MASantangelo/SV08-Enhanced-Gantry-Projects/tools/README.md

# tools

Scripts that generate the viewable files in this repo. You only need them if you're maintaining the repo; they're not needed to build the printer.

**Requirement:** [FreeCAD 1.0](https://www.freecad.org/) installed at the default location. The scripts run on FreeCAD's own Python, so nothing else needs installing.

## Refresh a variant

From the repo root:

```powershell
powershell -ExecutionPolicy Bypass -File tools\update-previews.ps1 -Variant "Printed Version" -Title "SV08-P6 Printed Gantry (6 mm)"
```

The titles in use are `SV08-P6 Printed Gantry (6 mm)`, `SV08-CF6 Carbon Fiber Gantry (6 mm)` and `SV08-M5 Aluminum Gantry (5 mm)`.

This:

1. Converts every STEP file into `For Viewing\<name>.stl`, in each of these folders that exists: the variant folder itself, `Base Assemblies`, `Base Components\Print Ready` and `Base Components\For Mockups Only`.
2. Rebuilds `<variant>\BOM.md` from the variant's `*BOM*.xlsx` file.

Add `-SkipStl` or `-SkipBom` to run only one of the two steps. Close the spreadsheet in Excel first, because Excel blocks other programs from reading it.

The output is deterministic: if a STEP file hasn't changed, its STL comes out byte-for-byte identical, so git only shows files that actually changed.

### Sub-variants (`CF Version\9mm Belt Mod`)

A sub-variant is a folder inside a variant that reuses most of its parent, like the CF build for 9 mm belts. It holds its own main STEP, `*BOM*.xlsx`, `BOM.md`, `Renders` and `For Viewing`. Its own sub-assemblies and parts sit beside the parent's in a folder with the same name: `CF Version\Base Assemblies\9mm Belt Mod` and `CF Version\Base Components\9mm Belt Mod`.

- Pass it as the variant: `-Variant "CF Version\9mm Belt Mod" -Title "SV08-CF6 Carbon Fiber Gantry for 9mm Belts"`. Renders, the BOM check and `dupes` pick up its sub-assemblies from the parent's `Base Assemblies\9mm Belt Mod`.
- `BOM.md` links its own parts first, then the parent's `Base Components` (the plates it shares), then `Shared Components`.
- Its BOM rules are the parent's rules plus any under `variants` → `"CF Version/9mm Belt Mod"`.
- The STLs for its parts in the parent's folders come from refreshing the parent (`-Variant "CF Version"`), which converts every subfolder.

## Renders

`update-previews.ps1` also renders PNGs into `<variant>\Renders\`. You can run that step on its own:

```powershell
powershell -ExecutionPolicy Bypass -File tools\render.ps1 -Variant "Printed Version"
```

- **What it renders:** the main assembly from 4 angles (front left, front right, rear left, overview), plus each `Base Assemblies` STEP from its outside corner. The CAD colours are kept, shaded without edge lines.
- **How:** it uses FreeCAD's full interface, so a FreeCAD window opens for about a minute and then closes itself. Images are rendered at 2× size, cropped to the parts and scaled down.
- **Changing angles:** edit `$MainViews` and `$AssemblyViews` in `render.ps1`. An angle is an azimuth (0 = front, 45 = front right, 315 = front left) and an elevation in degrees above the horizon. Avoid 90 (straight down), because the light washes out faces seen head-on.
- **No noise in git:** a render is only rewritten when its pixels change, so an unchanged model leaves the files byte-identical. FreeCAD's embedded metadata, which includes a timestamp and the local file path, is stripped out.
- **Not covered:** motion. Animations like the tensioner GIF still come from Fusion.
- **Landing image:** after rendering, `landing_composite.py` combines each version's `Full Gantry - Front Right` render into `Renders/Landing - Front Right.png`. With three versions it's a "Y" split from the centre (seams to the top-left corner, the top-right corner and the bottom middle): printed on the left, metal at the top, CF on the right, each with a label. Edit `REGIONS` in the script to change the order or labels.

## Build-guide step images

`build-steps.ps1` renders the step-by-step pictures for the guides in `Docs/`:

```powershell
powershell -ExecutionPolicy Bypass -File toolsuild-steps.ps1                    # every guide
powershell -ExecutionPolicy Bypass -File toolsuild-steps.ps1 -Only "XY Joint"
```

- **Step files:** each guide has a JSON file in `Docs/steps/` that names groups of parts (matched by name, optionally by height) and lists the steps. The format is described at the top of `build_steps.py`.
- **What each picture shows:** the parts added in that step in orange, parts fitted in earlier steps of the same sequence in grey, and nothing else.
- **Output:** `Docs/Images/<guide>/`, cropped and stripped of metadata like the other renders. Re-run it after any change to the sub-assembly STEP the guide uses.
- **Warnings:** a group that matches no parts (for example after a part is renamed in Fusion) is reported, and the run fails so the guide doesn't silently lose a part.

## Check flat plates (CF, metal)

```powershell
powershell -ExecutionPolicy Bypass -File tools\plate-check.ps1 -Variant "Metal Version" -Reference "CF Version"
```

This runs two checks on each plate in `<variant>\Base Components`: `plate_check.py` (holes, fits and walls between features), then `wall_check.py` (a direct wall sweep, below). Add `-SkipWallSweep` to run only the first.

`plate_check.py` checks:

- **Thickness:** must match the number in the file name (`Metal5mm` → 5.00 mm).
- **Position:** the plate must sit on 0,0,0.
- **Holes by role:** M2 and M3 tap drills (1.6 and 2.5), close-fit clearance holes (3.2, 4.3, 5.3) and Ø5.00 locating fits. A hole that's close to one of these sizes but not on it is flagged as a near-miss. Inside corner radii of the outline aren't counted as holes.
- **Metal only:** every plate except spacers needs at least one tapped hole.
- **Minimum wall:** the thinnest strip of material between two features, or between a feature and the edge, at every depth. Anything under 1.5 mm is flagged (change it with `-MinWall`). Each one is labelled as a through-wall (full plate depth) or a lip (a rim around a pocket).
- **With `-Reference`:** each hole is matched by position to the same plate in the reference version. It flags precision fits that changed (Ø5.00 shoulder holes, Ø13.00 bearing bores, Ø22.00 motor boss) and holes that exist on only one of the two plates. Intentional changes like PEM → tap are only counted. Add `-ListAllChanges` to list them.

`wall_check.py` measures material directly on the solid, so it also catches walls `plate_check.py` can't see: material between pockets that merge into one opening, such as knife-edge tips and thin tongues where a bearing step overlaps a motor-boss recess.

- **In-plane walls:** each plate is sectioned at every distinct depth (and every 0.1 mm through countersinks and chamfers). Anywhere two boundary edges come closer than the minimum across solid material, it reports a `THIN WALL` at the thinnest point, with the depth of that section.
- **Floors:** every pocket floor or ceiling is checked against the opposite face (`THIN FLOOR`).
- It uses the same `-MinWall` and `-Only` options and the same `plate_accepted.json` (kinds `wall` and `floor`).

**Printed parts:** the sweep can also check that walls and heights suit your slicer settings. Use `-SweepOnly`, because the hole sizes `plate_check.py` expects don't apply to print-tolerance holes, and point `-Folder` at the print-ready parts:

```powershell
powershell -ExecutionPolicy Bypass -File tools\plate-check.ps1 -Variant "Printed Version" -Folder "Base Components\Print Ready" -SweepOnly -MinWall 2.0 -PreferredWall 3.0 -InsertHole 4.7 -LayerHeight 0.2
powershell -ExecutionPolicy Bypass -File tools\plate-check.ps1 -Variant "Shared Components" -Folder "Print Ready" -SweepOnly -MinWall 2.0 -PreferredWall 3.0 -InsertHole 4.7 -LayerHeight 0.2
```

These are the project's printed rules: 2.0 mm minimum and 3.0 mm preferred. 3 mm of printed plastic is enough for most loads in this motion system, and the shared outline can reach it in most places.

- **`-PreferredWall`**: a second tier. Walls from `-MinWall` up to this are `BELOW-PREFERRED WALL`s. They're listed for review like thin walls, so you either fix them or accept them.
- **`-InsertHole`** (heat-set insert hole diameters, comma-separated, e.g. `4.7`): any wall touching one of these holes and thinner than the preferred wall (or `-MinWall`, without one) is an `INSERT WALL`. Heat-setting pushes melted plastic outward, so a thin wall beside an insert bulges into the next hole or cracks.
- **`-LayerHeight`** (e.g. `0.2`, `0.15`): the thickness and every flat level (pocket floors, steps) must sit on a layer boundary, otherwise it's an `OFF-LAYER HEIGHT`. In this mode the file's own Z is the build direction, since print-ready files are already oriented for printing.
- **`-WallMultiple`** (your line width, e.g. `0.4`), optional: every wall up to `-WallMax` (default 4 mm) must be an exact multiple of it, otherwise it's an `OFF-GRID WALL` with the two nearest multiples. The project doesn't use this rule, because the shared outline can't keep every wall on the grid.
- Accepted entries use the kinds `preferred`, `insert`, `grid` and `layer`.

Use `-Only "Front Left Top"` to check a single plate. Plates with findings get a marked-up drawing in `%TEMP%\sv08-plate-check`.

**Accepting a finding on purpose:** add an entry to `plate_accepted.json`, giving the plate, the kind (`wall`, `floor`, `near-miss` or `fit`), x/y and the measured value, plus a note. A matching finding then prints as `~ accepted` and doesn't count against the plate. If the geometry changes, it's reported as a normal finding again: that means a move of more than 1 mm, or a value change of more than 0.05 mm.

## Check the BOM against the STEP file

Run this before committing a new assembly STEP. It reads every part and how many times it's used from the STEP file, then compares those counts with the spreadsheet.

```powershell
& "C:\Program Files\FreeCAD 1.0\bin\python.exe" tools\step_bom.py check "Printed Version"
```

- **check**: reports quantity differences, parts in the CAD that aren't in the BOM, and BOM rows that are no longer in the CAD. It also fails on duplicate components (see `dupes`). It ends with `CHECK PASSED` (exit code 0) or `CHECK FAILED` (exit code 1), and never writes anything.
- **dupes**: checks the main STEP and every `Base Assemblies` STEP for duplicate components. When a component is copied and pasted instead of inserted as another instance, Fusion names the copy `Name (1)`, `Name (2)` and so on. The BOM still counts them correctly, but each copy is a separate component to keep in sync, so the check names each one and its parent so you can replace it with an instance of the original. Copies inside the stock Sovol `SV08 … Z Carriage` models are listed but don't fail the check.
- **update**: writes the CAD quantities into the spreadsheet's Qty column, then rebuilds `BOM.md`. Links, notes and formatting are left alone. New CAD parts are only reported unless you add `--add-new`, which appends them under a "New from CAD (sort these)" section. Close the spreadsheet in Excel first.
- **tree**: prints the assembly structure, showing each sub-assembly once. It's useful when writing rules.

Needs openpyxl in FreeCAD's Python. This is a one-time install: `& "C:\Program Files\FreeCAD 1.0\bin\python.exe" -m pip install --user openpyxl`

### Rules (`bom_rules.json`)

CAD names don't always match BOM names, so `bom_rules.json` translates them. Fusion's copy and mirror suffixes (`(2)`, `(Mirror)`, `_1`, `.f3d`, ` x2`) are removed automatically first.

| Rule | What it does | Example |
|---|---|---|
| `exclude_assemblies` | Skips a sub-assembly and everything inside it | The stock SV08 Z carriages |
| `unit_assemblies` | Counts a sub-assembly as one BOM item. Add `"descend": true` to also count the parts inside it. | A D2F-L switch is 1 item, not 5 pieces |
| `category_by_assembly` | Puts parts under a sub-assembly into a specific BOM category | Xol hardware goes into "Xol Toolhead Hardware". Use `{"as": "<category>", "only": "<regex>"}` to move only the matching parts: the rail screws and M3 T-nuts under `Linear Rails` go into "Linear Rail Mounting Hardware", while the rails stay in "Linear Rails & Sliders" |
| `rename` | Maps an exact CAD name to a BOM name | `T-Nut M4` becomes `M4 T-Nut` |
| `rename_patterns` | Regex renames, used when no exact rename matches | `M3x8mm SHCS` becomes `M3 x 8mm SHCS` |
| `ignore_parts` | CAD parts that never belong in the BOM | |
| `bom_only` | BOM rows that are expected to be missing from the CAD | |

`common` rules apply to every variant. Rules under `variants` → `"<folder name>"` add to them for one variant.

## Mechanical analysis

The numbers and figures in [`Mechanical Analysis.md`](../Mechanical%20Analysis.md) come from the scripts in [`analysis/`](analysis). To rerun them after a design change:

```powershell
powershell -ExecutionPolicy Bypass -File tools\analysis\analysis.ps1
```

It takes about 15 minutes and runs six steps. Add `-From <step>` to restart from a later one, reusing the earlier steps' output.

| Step | What it does |
|---|---|
| `geometry.py` | Reads the three versions' assembly STEPs and the 9mm belt mod's. It exports the left-side plates, the front and back corner sandwiches and the left XY joint, and measures every belt wrap and its load at 8 lb. |
| `plates.py` | FEA of every left-side plate under its idler loads (printed ABS, CF with the weave at 0/90 and at 45°, aluminium), then how much the plates lengthen the belt path compared with the belt's own stretch |
| `corners.py` | FEA of the corner sandwiches, giving how stiffly each version holds the Y extrusion ends. Each is run bonded (a tight through-bolt) and clamped only at its bolts (a loose T-nut joint). |
| `xyjoint.py` | Predicted XY joint bench test: one joint held at its MGN9 carriage with a 200 mm X-beam stub, 49 N sideways and vertically, next to the bare-stub deflection. Each joint is exported with three stand-in shaft post sizes, and the first that meshes is used. |
| `frame.py` | Beam models of the whole gantry: masses and acceleration (motor rotors included), sag, vertical bounce, XY and yaw modes, belt tension swing and plucked-frequency table, thermal bow at each chamber temperature, joint slip, motor heat, creep and buckling |
| `figures.py` | Writes the PNGs in `Renders/Analysis/` |

- **Inputs:** material data and assumptions are in `materials.py`: the CF weave's direction-dependent constants, belt stiffness range, toolhead mass, motor, and chamber temperatures.
- **Tools:** meshing uses gmsh and solving uses CalculiX. Both ship with FreeCAD 1.0, so nothing else needs installing.
- **Work files** go to `%TEMP%\sv08fea`, deliberately a short path, because CalculiX fails once a path passes Windows' 260-character limit.
- **Meshing failures:** gmsh retries with other element sizes and a looser tolerance for touching faces, and gives up on an attempt after 90 s. If a model still can't be meshed, it's skipped. For a corner, `frame.py` then uses the other corner's value, and says so in its output.
- **Reading the output:** the printed results are what the tables in the analysis doc are built from. The doc isn't regenerated automatically, so update its numbers by hand when they change.

## Files

| File | What it does |
|---|---|
| `update-previews.ps1` | Runs both steps for one variant |
| `step2stl.py` | STEP to STL using size-based meshing: small hardware coarse, plates and large parts fine. This keeps full assemblies small enough for GitHub's viewer. |
| `make_bom_md.py` | Spreadsheet to `BOM.md`: sectioned tables, Amazon/AliExpress/Mouser/McMaster buy links, and printed parts and plates linked to their STL previews |
| `render.ps1` / `render.py` | Renders PNGs of the assemblies using FreeCAD's full interface |
| `build-steps.ps1` / `build_steps.py` | Renders the build-guide step images from `Docs/steps/*.json` |
| `landing_composite.py` | Builds the split landing-page image from each version's render |
| `plate-check.ps1` / `plate_check.py` | Sanity-checks flat plates: thickness, holes, thin walls, changes from a reference version |
| `wall_check.py` | Direct minimum-wall and floor sweep of flat plates, including merged pockets (run by `plate-check.ps1`) |
| `plate_accepted.json` | Findings accepted on purpose, shared by both plate checks |
| `step_bom.py` | Checks or updates the BOM spreadsheet against the assembly STEP |
| `bom_rules.json` | Rules that translate CAD names into BOM lines |
| `read_xlsx.py` | Minimal `.xlsx` reader using only the Python standard library, used by `make_bom_md.py` |
| `analysis/analysis.ps1` | Runs the mechanical analysis (see above) |
| `analysis/fealib.py` | Small gmsh + CalculiX wrapper used by the FEA steps: meshing, picking bolt and bore nodes by position, solving, reading results |
| `analysis/materials.py` | Material data and analysis assumptions |

## Spreadsheet layout `make_bom_md.py` expects

- Header row: `Category | Qty Needed | Description | Purchase Link | Notes`
- Section rows: only the first column filled in, for example `Fasteners - Screws`
- Rows in a section called `Printed Parts`, or one ending in `Plates` (`CF Plates`, `Metal Plates`), are linked to the STL preview with the matching name in the variant's `Base Components` or in `Shared Components`. A leading `4x` and a trailing `- For Printing` are ignored when matching.
