MASantangelo/SV08-Enhanced-Gantry-Projects/CF Version/README.md

# SV08-CF6 Carbon Fiber Gantry (6 mm)

The carbon fiber variant: every gantry plate is cut from 6 mm carbon fiber, and standard M3 hex nuts in hex pockets replace the heat-set inserts used in the printed version.

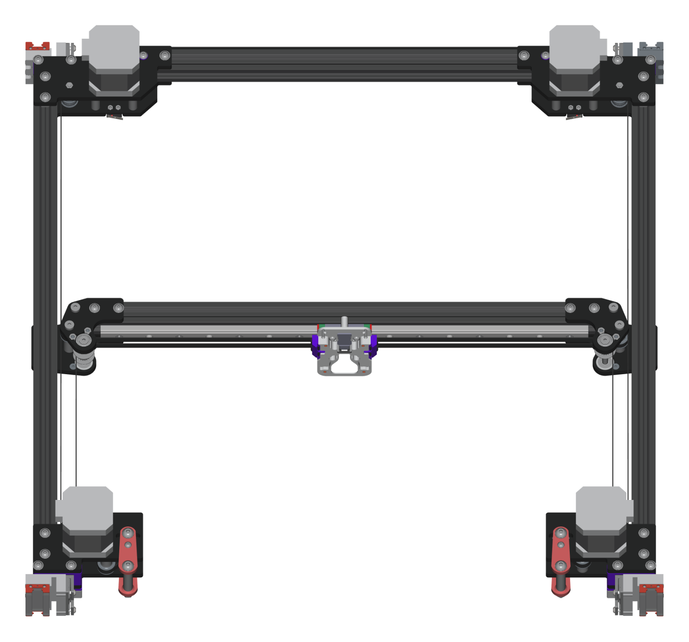
[picture p5: CF Version/Renders/Full Gantry - Overview.png]
Full gantry overview, rendered from the current STEP file


## Folder structure

```text
CF Version/
├── BOM.md                                   Bill of materials with purchase links
├── SV08_CF6_BOM_from_STEP.xlsx              BOM spreadsheet (source for BOM.md)
├── SV08-CF6 Dual Shear Live Idlers Front Tensioners.step   Full assembly
├── For Viewing/                             STL preview of the full assembly (~34 MB)
├── 9mm Belt Mod/                            The 9 mm belt version: its own full assembly, BOM and renders
│
├── Base Assemblies/                         Each corner and joint as its own assembly
│   ├── Back Left / Back Right Motor Assembly
│   ├── Front Left / Front Right Motor Assembly
│   ├── XY Joint Left / Right
│   ├── 9mm Belt Mod/                        The same six for 9 mm belts
│   └── For Viewing/                         STL previews
│
├── Base Components/                         ← Cut these from 6 mm carbon fiber
│   ├── *.step                               12 gantry plates + the 5 mm XY idler spacers
│   ├── CF Printed Parts.3mf                 The shared printed parts a CF build needs, on one plate (OrcaSlicer)
│   ├── 9mm Belt Mod/                        The three 5 mm riser spacers for the 9 mm build (CF or printed)
│   └── For Viewing/                         STL previews
│
├── Photos/                                  Photos of real builds
└── Renders/                                 Auto-generated from the STEP files (always current)
```

The spacers and tensioner lever arms are the same in every version, so they live in [`Shared Components`](../Shared%20Components). Print them, or cut the lever arms from CF or metal.

## Quick links

| I want to... | Go to |
|---|---|
| Buy the hardware | [BOM.md](BOM.md) |
| Install it | [Installation guide](../Docs/Installation.md) |
| Cut the plates | [Base Components](Base%20Components) |
| Print the shared parts | [Shared Components/Print Ready](../Shared%20Components/Print%20Ready), or all at once from the [CF Printed Parts 3MF](Base%20Components/CF%20Printed%20Parts.3mf) |
| Look at the assembly in 3D | [Full assembly STL](For%20Viewing/SV08-CF6%20Dual%20Shear%20Live%20Idlers%20Front%20Tensioners.stl) · [Sub-assemblies](Base%20Assemblies/For%20Viewing) |
| Build it for 9 mm belts | [9mm Belt Mod](9mm%20Belt%20Mod): the same CF plates with a 30 mm corner gap, 9 mm idlers and pulleys and longer hardware, with its own [BOM](9mm%20Belt%20Mod/BOM.md). It works with the aluminum and printed plates too. |

## What's different from the printed version

- **Plates:** cut from 6 mm carbon fiber instead of printed. The layout matches the printed plates, with machining tolerances built in (see the hole guide below) and a few outlines grown slightly to keep at least 1.5 mm of material around the bearing-retainer screws.
- **Threaded mounting points:** standard M3 hex nuts (ISO 4032), seated in hex pockets, replace the M3 heat-set inserts. The pockets are 5.9 mm across the flats, so a nut drops in and can't turn. A dab of glue (CA or epoxy) keeps each nut in its pocket until its screw is in. Every screw that goes into a nut gets its full thread, apart from the lever-arm screws (about 2.1 of 2.4 mm), which is plenty for a pivot.
- **Back motors on top:** the CAD has the back motors on top of the corners, like the fronts. The printed and metal CAD hangs them below. Both ways work on every version: swap the back plates left for right to change it (see [Motor up or motor down](../Docs/Installation.md#motor-up-or-motor-down)).
- **Everything else is the same:** hardware, bearings, pulleys, belts, extrusions and the shared printed parts.

## Cutting the plates

| Hole | Size | Notes |
|---|---|---|
| **M3 / M4 / M5 clearance** | Ø3.2 / Ø4.3 / Ø5.3 | Close fit. The tensioner slot is 5.3 mm wide. |
| **M3 nut pockets** | 5.9 mm across the flats, R1 corners, 2.5 mm deep (2.4 mm at the bearing retainers on the front bottom plates), with a 1 mm lead-in chamfer | For standard M3 hex nuts; the M3 hole through the rest of the plate is Ø3.2. The 2.4 mm pockets leave a thicker floor at the front bottom retainers. |
| **Shoulder-bolt holes** | Ø5.00 | Locating fit for the D5 shoulder bolts; head counterbores Ø8.3. |
| **Bearing seats** | Ø13.00 bore, Ø16.20 step | Locating fit for the F695 flanged bearings. Step depth: 2.0 mm on the XY plates, 2.6 mm on the front bottoms, 1.4 mm on the front tops, 1.0 mm on the back bottoms. The XY and front depths set the bearing spans for the Chicago bolt idler shafts. |
| **Bearing-retainer counterbores** | Ø6.2, as deep as the bearing step beside them (1.4–2.6 mm) | For the M3 flat heads that clamp the bearing flanges |
| **Motor boss** | Ø22.00 | Front top plates; merged with the bearing bore, so there's no thin web between them |

- **The pockets need a mill.** Bearing steps, counterbores and the hex nut pockets are partial-depth features, so a waterjet or laser alone can't cut them.
- **Left plates are flipped copies of the right ones.** Each left plate is its right-hand plate turned over, so its pockets are on the opposite face of the file. Machine each plate pocket-side up as it's drawn.
- **XY live idler spacers:** cut from the same 6 mm sheet and machined down to 5 mm, so you don't need a separate 5 mm sheet.
- A few walls and floors are under 1.5 mm on purpose: mostly the floors between the nut pockets and the bearing-retainer counterbores (1.0 mm on the front bottoms), plus a few rims beside the nut pockets and shoulder-bolt holes. They're listed, with the reasons, in [`tools/plate_accepted.json`](../tools/plate_accepted.json).

## Build photos

The first CF XY joint (left), cut from 6 mm carbon fiber and fitted with its Chicago bolt live idler, bearings and pulleys.

| Front | Side |
|---|---|
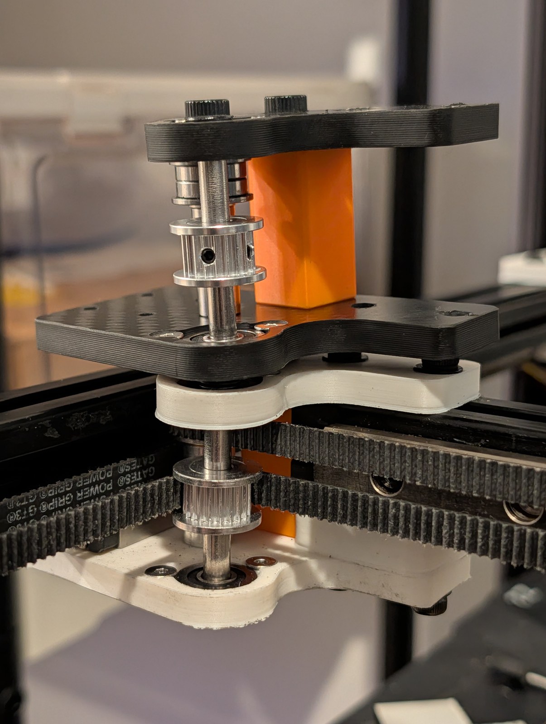
[picture p6: CF Version/Photos/XY Joint Left CF - Front.jpg]
The left CF XY joint on the printer: the toothed pulley and the bearing stack on the shoulder bolt between the carbon fiber plates, with the orange printed spacer and both belts below
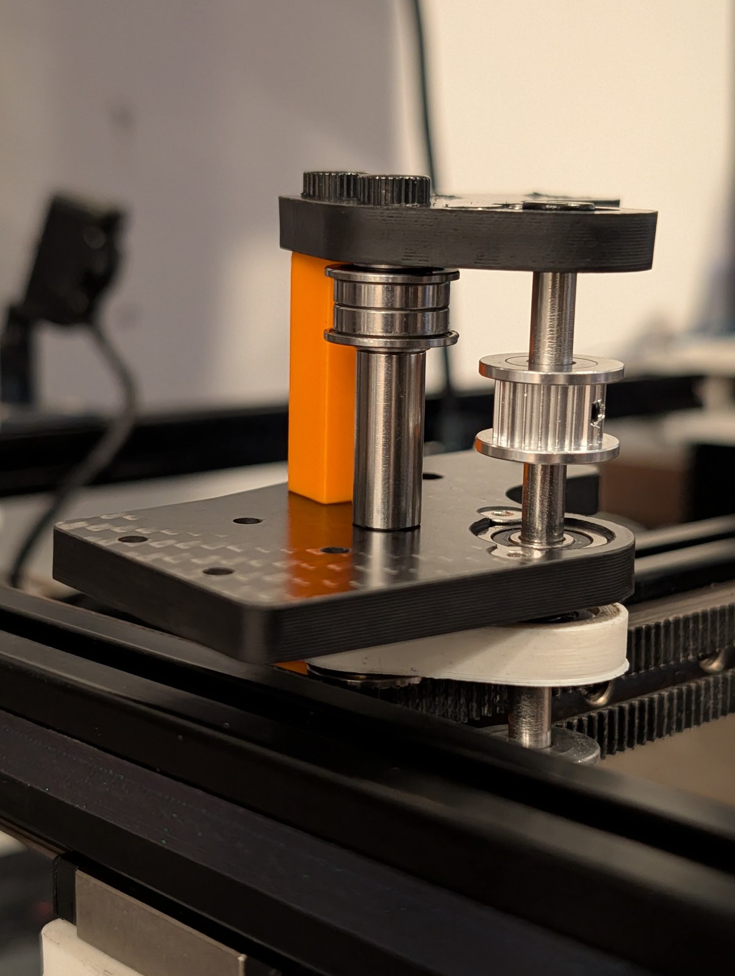
[picture p7: CF Version/Photos/XY Joint Left CF - Side.jpg]
The left CF XY joint from the side: the bearing stack and the toothed pulley on the Chicago bolt between the two carbon fiber plates
|  |  |

**The X gantry on the stock SV08 extrusion**, with both CF XY joints through-bolted to it with nuts and bolts.

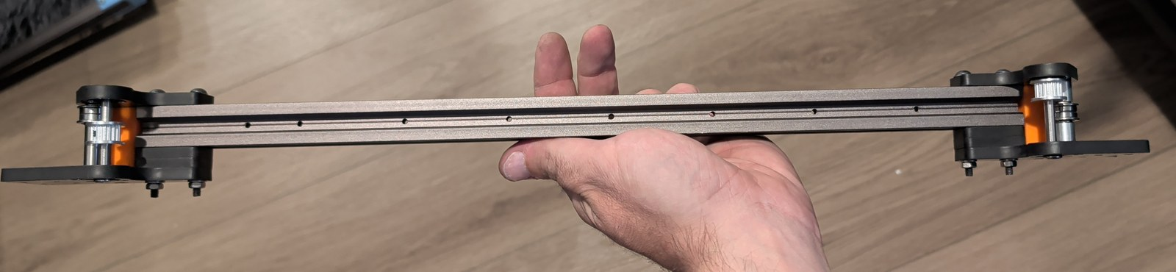
[picture p8: CF Version/Photos/X Gantry CF - In Hand.jpg]
Both CF XY joints mounted on the ends of the stock SV08 toolhead extrusion, held in one hand: through-bolts and nuts under each joint, pulleys and orange printed spacers at each end


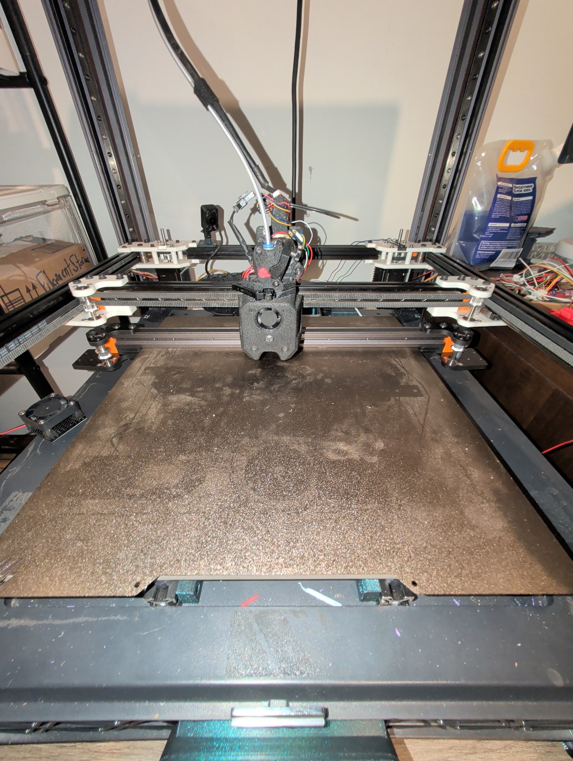
[picture p9: CF Version/Photos/X Gantry CF - On Printer.jpg]
The CF X gantry installed on an SV08 with printed corners: the toolhead on the stock extrusion between the two CF XY joints, belts fitted


**Front right motor corner**

| Belt side | Tensioner |
|---|---|
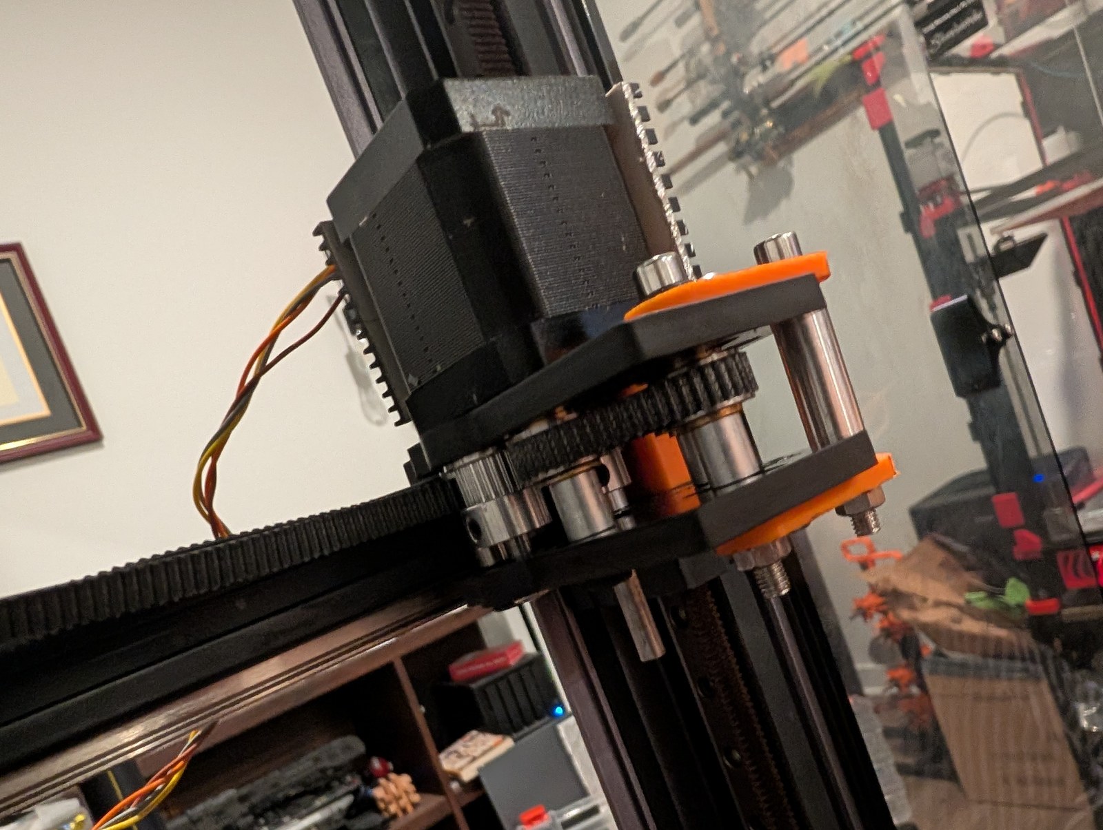
[picture p10: CF Version/Photos/Front Right Motor Corner CF - Belt Side.jpg]
The CF front right motor corner on the printer: the motor on the top plate, the belts on the bearing stacks between the two carbon fiber plates, and the orange lever arms on the shoulder bolts
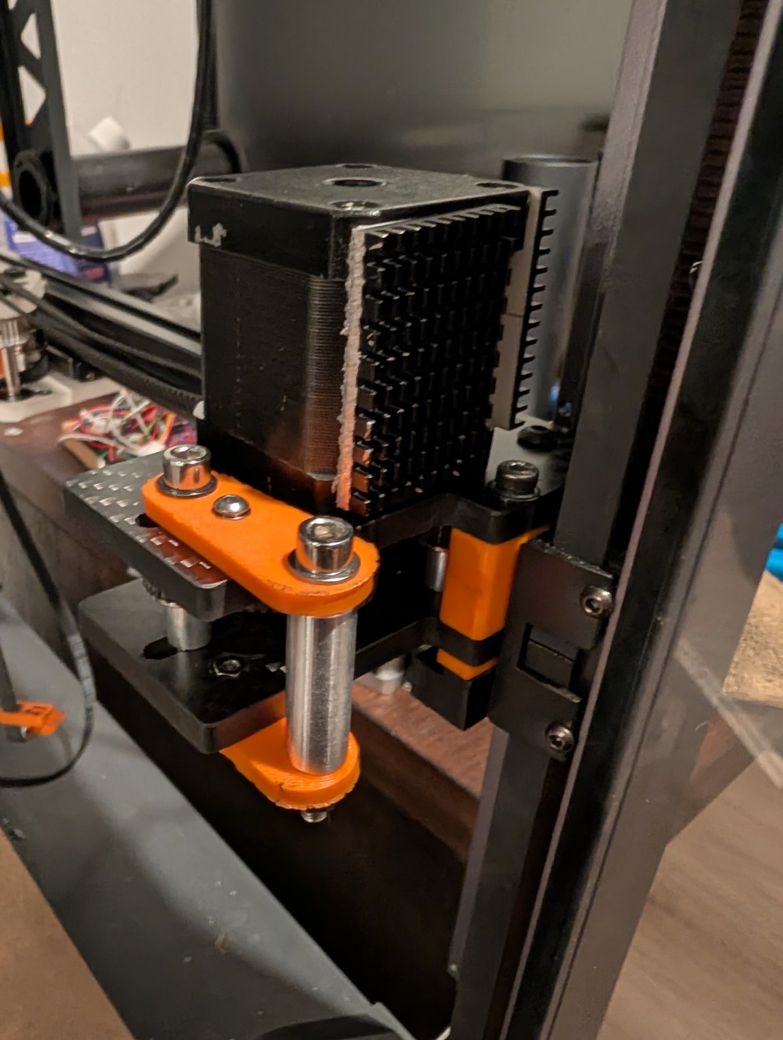
[picture p11: CF Version/Photos/Front Right Motor Corner CF - Tensioner.jpg]
The CF front right motor corner from the tensioner side: the orange lever arms clamped top and bottom on the tensioner shaft, with the motor above
|  |  |

## Renders

Generated automatically from the current STEP files whenever the repo is refreshed (see [tools](../tools)), so they always show the latest design.

| | |
|---|---|
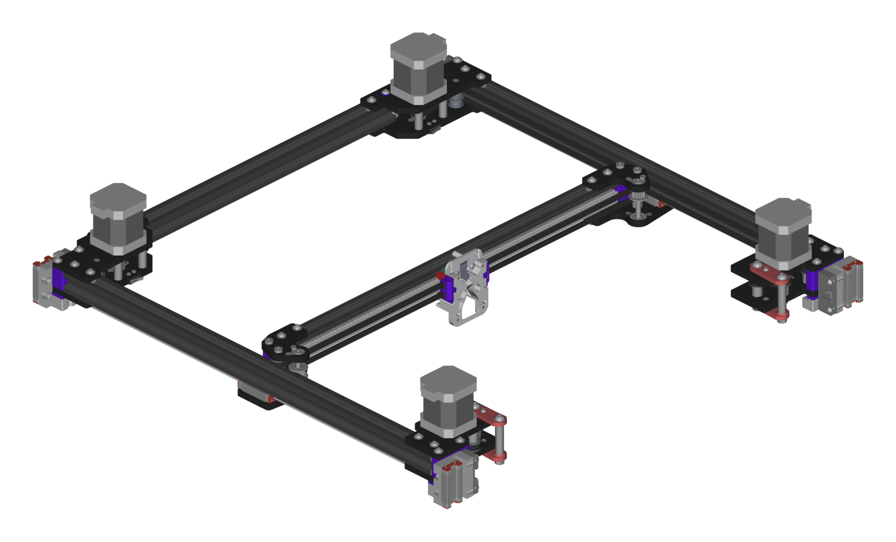
[picture p12: CF Version/Renders/Full Gantry - Front Left.png]
Full gantry, front left
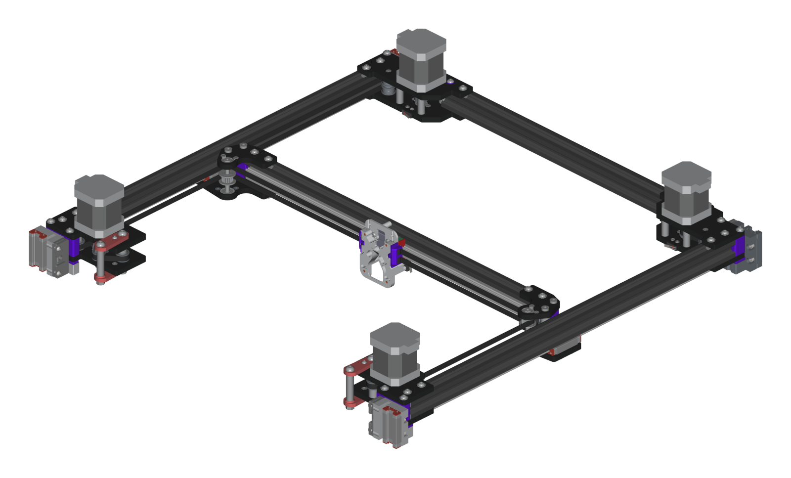
[picture p13: CF Version/Renders/Full Gantry - Front Right.png]
Full gantry, front right
|  |  |
| Front left | Front right |
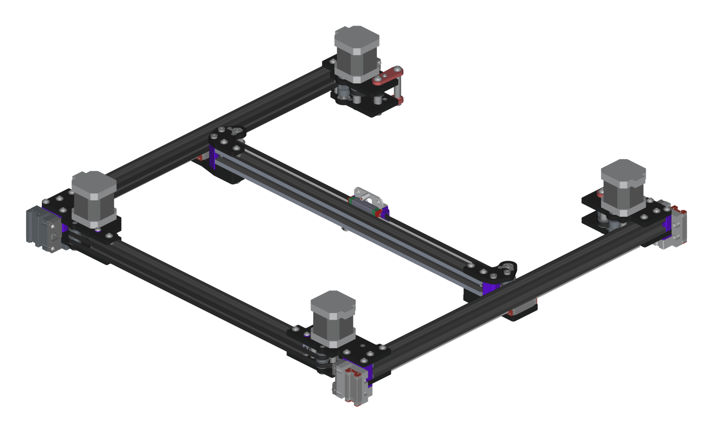
[picture p14: CF Version/Renders/Full Gantry - Rear Left.png]
Full gantry, rear left
|  | Full gantry, overview |
| Rear left | Overview |

### Sub-assemblies

| | | |
|---|---|---|
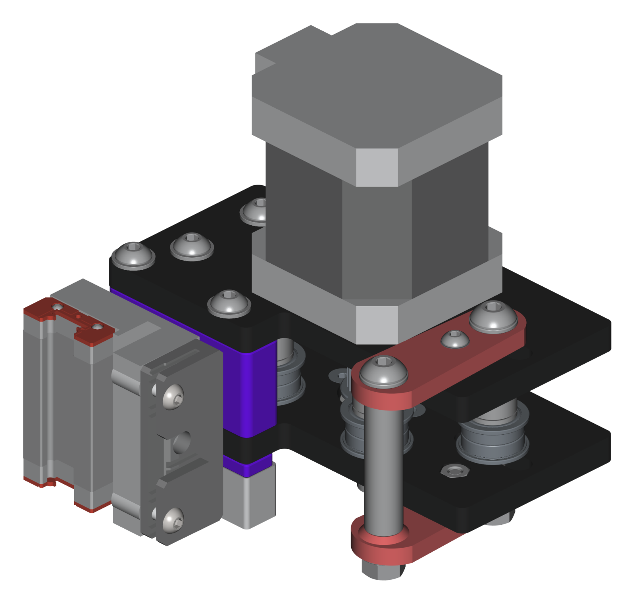
[picture p15: CF Version/Renders/Front Left Motor Assembly CF6mm - Iso.png]
Front left motor assembly
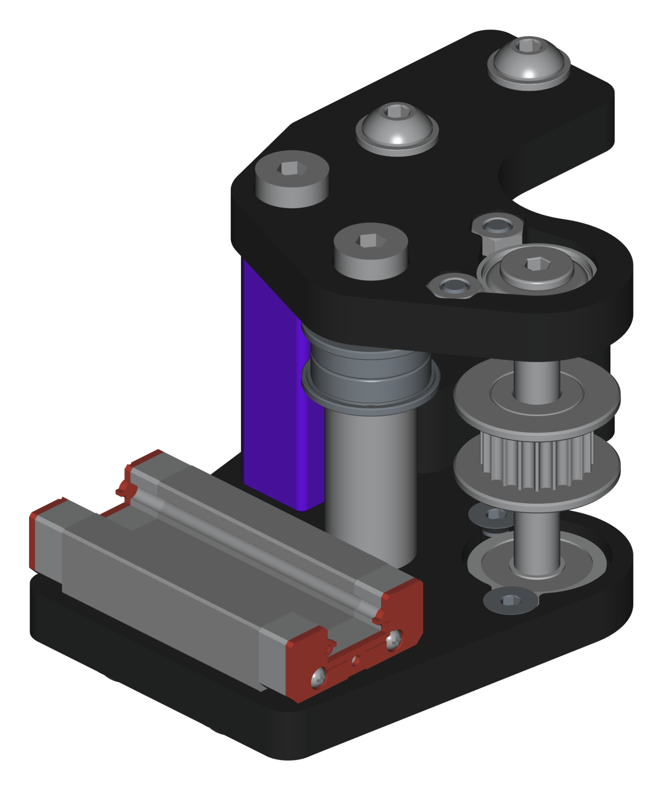
[picture p16: CF Version/Renders/XY Joint Left CF6mm - Iso.png]
XY joint left
|  | Front right motor assembly |  |
| Front left motor | Front right motor | XY joint left |
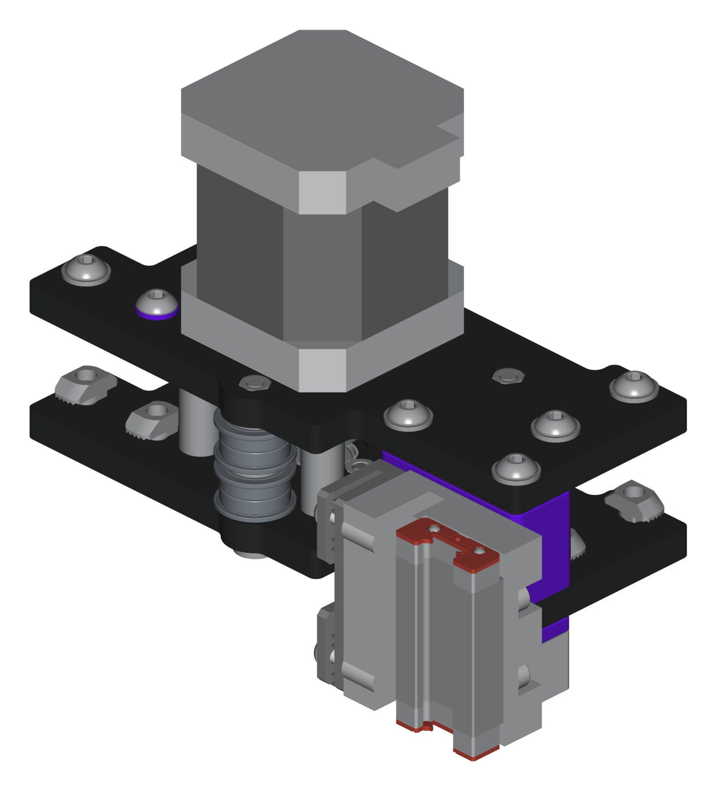
[picture p17: CF Version/Renders/Back Left Motor Assembly CF6mm - Iso.png]
Back left motor assembly
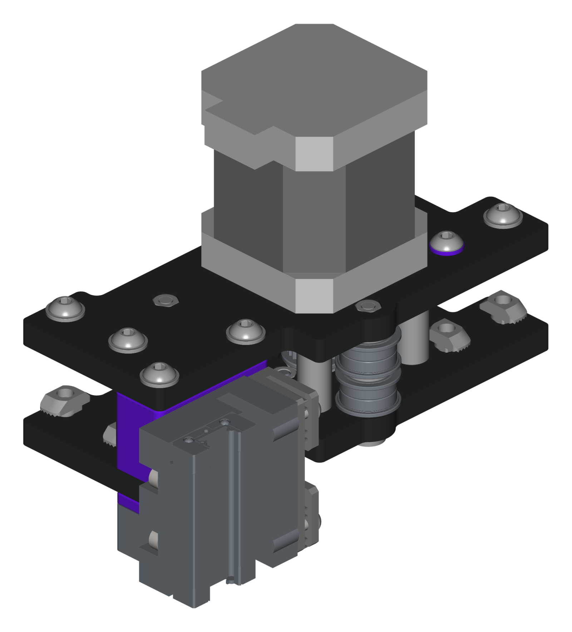
[picture p18: CF Version/Renders/Back Right Motor Assembly CF6mm - Iso.png]
Back right motor assembly
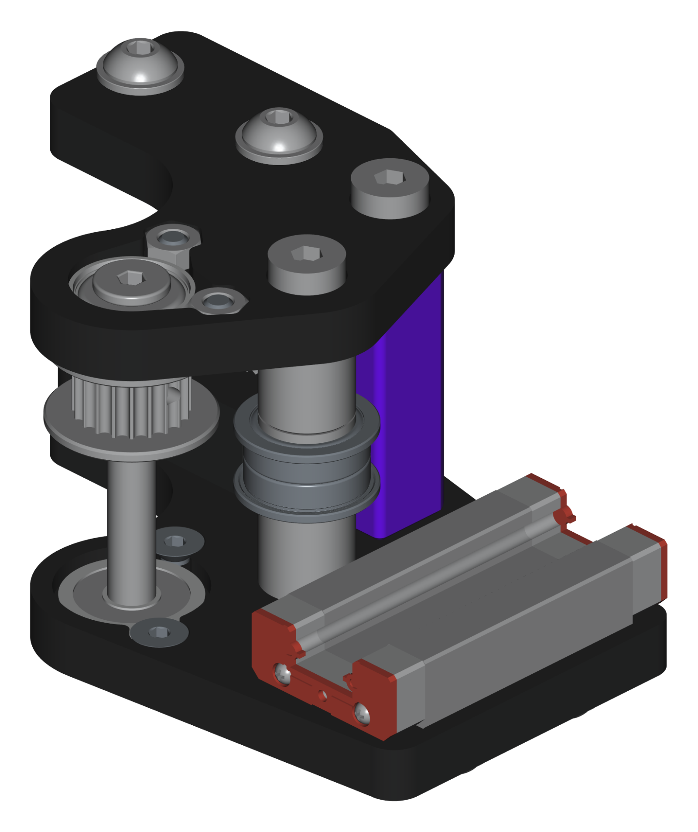
[picture p19: CF Version/Renders/XY Joint Right CF6mm - Iso.png]
XY joint right
|  |  |  |
| Back left motor | Back right motor | XY joint right |
