MASantangelo/SV08-Enhanced-Gantry-Projects/Metal Version/Renders/Full Gantry - Overview.png

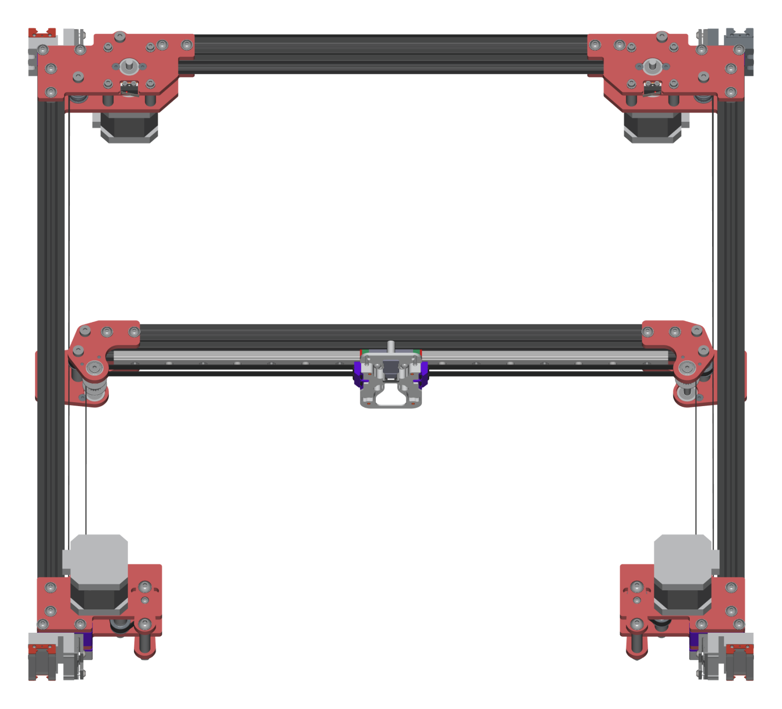
Metal Version/Renders/Full Gantry - Overview.png
