MASantangelo/SV08-Enhanced-Gantry-Projects/Shared Components/README.md

# Shared Components

Parts that are the same in every version of the gantry (printed, carbon fiber and metal). Each version's BOM links here for them.

## Print Ready

Oriented for printing, with holes enlarged by about 0.3 mm for printing tolerance. The quantity per machine is in the file name.

| Qty | Part |
|---:|---|
| 4 | [Tensioner Lever Arm Revised](Print%20Ready/For%20Viewing/4x%20Tensioner%20Lever%20Arm%20Revised%20-%20For%20Printing.stl) |
| 4 | [Z Carriage Spacer](Print%20Ready/For%20Viewing/4x%20Z%20Carriage%20Spacer%20-%20For%20Printing.stl) |
| 2 | [Back Spacer Plate 20mm](Print%20Ready/For%20Viewing/2x%20Back%20Spacer%20Plate%2020mm%20-%20For%20Printing.stl) |
| 2 | [Front Spacer Plate 20mm](Print%20Ready/For%20Viewing/2x%20Front%20Spacer%20Plate%2020mm%20-%20For%20Printing.stl) |
| 2 | [Printed Back Motor Spacer](Print%20Ready/For%20Viewing/2x%20Printed%20Back%20Motor%20Spacer%20-For%20Printing.stl) |
| 2 | [XY Live Idler Spacer](Print%20Ready/For%20Viewing/2x%20XY%20Live%20Idler%20Spacer%20-%20For%20Printing.stl) |

Part names link to 3D previews. The STEP files sit next to them in [`Print Ready`](Print%20Ready).

## For Cutting

Nominal size, for parts that can also be cut from carbon fiber instead of printed.

| Qty | Part |
|---:|---|
| 4 | [Tensioner Lever Arm Revised](For%20Cutting/For%20Viewing/Tensioner%20Lever%20Arm%20Revised.stl) |

The tensioner lever arm works either way: print it from `Print Ready`, or cut it from carbon fiber using this file. **Metal builds use their own flat 5 mm lever arm** from [`Metal Version/Base Components`](../Metal%20Version/Base%20Components). Machined aluminium lever arms for all three versions will be available to buy at some point.

## Stock Parts

Models of bought parts and the stock SV08 extrusions, for checking fits in CAD. You don't make these; the BOMs say where to buy them.

| Part | Notes |
|---|---|
| [M5x30 Chicago Bolt Base](Stock%20Parts/For%20Viewing/M5x30%20Chicago%20Bolt%20Base.stl) | 304 stainless Chicago screw, 5 mm × 30 mm barrel, M4 thread. Front live idler shaft. |
| [M5x40 Chicago Bolt Base](Stock%20Parts/For%20Viewing/M5x40%20Chicago%20Bolt%20Base.stl) | Same, 40 mm barrel. XY joint live idler shaft. |
| [M4x4 Chicago Bolt Cap Screw](Stock%20Parts/For%20Viewing/M4x4%20Chicago%20Bolt%20Cap%20Screw.stl) | The screw included with the Chicago bolts. Its 2 mm head doesn't clear the front motors, so the build uses the ultra-thin head instead. |
| [M4x8 Ultra Thin Flat Head](Stock%20Parts/For%20Viewing/M4x8%20Ultra%20Thin%20Flat%20Head.stl) | 1.2 mm head. Closes the screw end of each Chicago bolt. |
| [SV08 Stock Toolhead Extrusion](Stock%20Parts/For%20Viewing/SV08%20Stock%20Toolhead%20Extrusion.stl) | 426 mm. M4 holes 5 mm and 25 mm from each end. |
| [SV08 Stock Gantry X Extrusion](Stock%20Parts/For%20Viewing/SV08%20Stock%20Gantry%20X%20Extrusion.stl) | 345 mm. M4 holes 5 mm and 23 mm from each end. |
| [SV08 Stock Gantry Y Extrusion](Stock%20Parts/For%20Viewing/SV08%20Stock%20Gantry%20Y%20Extrusion.stl) | 469 mm. M4 holes 5 mm and 25 mm from each end. |

Part names link to 3D previews. The STEP files sit next to them in [`Stock Parts`](Stock%20Parts).
