MASantangelo/SV08-Enhanced-Gantry-Projects/CF Version/BOM.md

# SV08-CF6 Carbon Fiber Gantry (6 mm): Bill of Materials

Generated from [`SV08_CF6_BOM_from_STEP.xlsx`](SV08_CF6_BOM_from_STEP.xlsx). If the two disagree, the spreadsheet is correct.

Links are plain product pages with no affiliate or tracking codes. Where a listing has multiple options, the **Notes** column says which one to pick.

## Contents

- [Fasteners - Screws](#fasteners---screws)
- [Fasteners - Shoulder Bolts](#fasteners---shoulder-bolts)
- [Fasteners - T-Nuts](#fasteners---t-nuts)
- [Live Idler Shafts](#live-idler-shafts)
- [Fasteners - Nuts](#fasteners---nuts)
- [Washers & Shims](#washers--shims)
- [Bearings](#bearings)
- [Pulleys](#pulleys)
- [Belts](#belts)
- [Spacers (Aluminum)](#spacers-aluminum)
- [Xol Toolhead Hardware](#xol-toolhead-hardware)
- [Electronics / Endstops](#electronics--endstops)
- [Linear Rails & Sliders](#linear-rails--sliders)
- [Linear Rail Mounting Hardware](#linear-rail-mounting-hardware)
- [Motors](#motors)
- [Extrusions](#extrusions)
- [CF Plates](#cf-plates)
- [Printed Parts](#printed-parts)

## Fasteners - Screws

*The M3 screws and M3 T-nuts that mount the linear rails are listed separately under [Linear Rail Mounting Hardware](#linear-rail-mounting-hardware).*

| Qty | Part | Buy | Notes |
|---:|---|---|---|
| 28 | M4 x 10mm BHCS | [Amazon](https://amazon.com/dp/B0CTH3Z2F5) |  |
| 24 | M3 x 6mm FHCS | [Amazon](https://amazon.com/dp/B01E5EOIWW) |  |
| 12 | M3 x 10mm BHCS | [Amazon](https://amazon.com/dp/B0GJK7Z9DH) |  |
| 8 | M3 x 35mm SHCS | [Amazon](https://amazon.com/dp/B0GHY9ZCLC) |  |
| 8 | M4 x 45mm BHCS | [Amazon](https://amazon.com/dp/B0GH6G1R1G) |  |
| 4 | M4x8 Ultra Thin Flat Head | [Amazon](https://amazon.com/dp/B0H61X7SWB) | Screw end of each Chicago bolt live idler shaft (1 per front motor assembly and 1 per XY joint). 1.2mm head, thin enough to clear the front motors. Use threadlocker: blue (medium, removable) recommended; red (high strength) only for a permanent build, since removing it takes heat that can damage the bearings. |
| 4 | M2 x 2mm Set Screw | [Amazon](https://amazon.com/dp/B0DDJBSF6B) | Should come with the GT2 20-Tooth Pulley - Live Idler Version (2 per pulley, 4 total). |
| 4 | M2 x 8mm SHCS | [Amazon](https://amazon.com/dp/B0D4JMPT86) |  |
| 4 | M4 x 20mm BHCS | [Amazon](https://amazon.com/dp/B0DYSQZHC9) |  |
| 4 | M5 x 45mm BHCS | [Amazon](https://amazon.com/dp/B0GJX8PR8J) |  |

## Fasteners - Shoulder Bolts

| Qty | Part | Buy | Notes |
|---:|---|---|---|
| 8 | D5 M3 x 30mm Shoulder Bolt | [AliExpress](https://www.aliexpress.us/item/3256810189139611.html) | Make sure you select Size D5-M3, Length 30mm |
| 4 | D5 M3 x 25mm Shoulder Bolt | [AliExpress](https://www.aliexpress.us/item/3256810189139611.html) | Make sure you select Size D5-M3, Length 25mm |
| 4 | D5 M3 x 35mm Shoulder Bolt | [AliExpress](https://www.aliexpress.us/item/3256810189139611.html) | Make sure you select Size D5-M3, Length 35mm |

## Fasteners - T-Nuts

*The M3 screws and M3 T-nuts that mount the linear rails are listed separately under [Linear Rail Mounting Hardware](#linear-rail-mounting-hardware).*

| Qty | Part | Buy | Notes |
|---:|---|---|---|
| 32 | M4 T-Nut | [Amazon](https://amazon.com/dp/B0C9DJBG1H) |  |

## Live Idler Shafts

| Qty | Part | Buy | Notes |
|---:|---|---|---|
| 2 | M5x40 Chicago Bolt Base | [Amazon](https://amazon.com/dp/B0FLJNY14R) | Live idler shaft in the XY joints (1 per joint). 304 stainless Chicago screw: the 5mm x 40mm barrel runs the full width of both bearings, its head on one bearing and an M4x8 Ultra Thin Flat Head on the other, so the bearings are clamped and the idler can't float. Pack of 20. The M4x4 screws in the pack aren't used: their 2mm heads don't clear the front motors, so the ultra-thin heads are used everywhere. ALTERNATIVES (not as good): an M3 internally threaded spacer, 5mm OD x 35mm (amazon.com/dp/B0D3HWQ2GF), clamped by 2x M3 x 10mm ultra-thin flat heads (amazon.com/dp/B0H61WCTBX). The anodised spacers measure about 5.05mm, so sand the whole length in a drill (400-600 grit) until it presses into a bearing with firm thumb pressure and the pulley slides over it. Or a 5mm h6/h7 slip-fit dowel / ground shaft, 40mm long: it fits, but it's held only by the pulley set screws, so the idler can float up and down under belt tension, which causes vibration. |
| 2 | M5x30 Chicago Bolt Base | [Amazon](https://amazon.com/dp/B0FLJQP39V) | Live idler shaft in the front motor assemblies (1 per side). 304 stainless Chicago screw: the 5mm x 30mm barrel runs the full width of both bearings, head at the bottom and an M4x8 Ultra Thin Flat Head at the top, 0.4mm under the motor. Pack of 20; the M4x4 screws in the pack aren't used (their 2mm heads don't clear the motor). ALTERNATIVES (not as good): an M3 internally threaded spacer, 5mm OD x 25mm (amazon.com/dp/B0D3HVVJPN), clamped by 2x M3 x 10mm ultra-thin flat heads (amazon.com/dp/B0H61WCTBX). The anodised spacers measure about 5.05mm, so sand the whole length in a drill (400-600 grit) until it presses into a bearing with firm thumb pressure and the pulley slides over it. Or a 5mm h6/h7 slip-fit dowel / ground shaft, 30mm long: it fits, but it's held only by the pulley set screws, so the idler can float up and down under belt tension, which causes vibration. |

## Fasteners - Nuts

| Qty | Part | Buy | Notes |
|---:|---|---|---|
| 4 | M2 Nut | [Amazon](https://amazon.com/dp/B0FGTMN5JM) |  |
| 4 | M5 Nut | [Amazon](https://amazon.com/dp/B0D1X2YBLJ) |  |
| 36 | M3 Nut | [Amazon](https://amazon.com/dp/B0F9FC4563) | Standard M3 hex nuts (ISO 4032: 5.5mm across flats, up to 2.4mm thick) in hex pockets in the CF plates, in place of the PEM standoffs: bearing retainers, shoulder bolts and lever-arm screws. The pockets are 5.9mm across flats, so a dab of glue holds a nut in place while you assemble. |

## Washers & Shims

| Qty | Part | Buy | Notes |
|---:|---|---|---|
| 44 | M5 Washer (5mm ID \| 10mm OD \| 1mm Tall) | [Amazon](https://amazon.com/dp/B07WZ5WQCG) | Includes the 36 bearing-stack shims, now named M5 Washer. |
| 38 | M4 Washer (4mm ID \| 9mm OD \| 1mm Tall) | [Amazon](https://amazon.com/dp/B0DK6KXB6W) | .8mm more common and acceptable swap, OD matters |
| 8 | M3 Washer (3mm ID \| 7mm OD \| .5-.6mm Tall) | [Amazon](https://amazon.com/dp/B0C3TJ7PWT) |  |
| 8 | M3 Shim (3mm ID \| 5mm OD \| .2mm Tall) | [Amazon](https://amazon.com/dp/B08ZYP1TK4) |  |

## Bearings

| Qty | Part | Buy | Notes |
|---:|---|---|---|
| 48 | 695-2RS Flanged Bearing | [Amazon](https://amazon.com/dp/B0CGXF48ZZ) | Includes the 12 loose bearings named F695-2RS Bearing Single in CAD (36 stacked + 12 loose). |
| 4 | MR63ZZ Bearing 3x6x2.5mm | [Amazon](https://amazon.com/dp/B0DY11G865) |  |

## Pulleys

| Qty | Part | Buy | Notes |
|---:|---|---|---|
| 6 | GT2 20-Tooth Pulley Set-Screw Version | [Amazon](https://amazon.com/dp/B0GWLM6FD6) |  |
| 2 | GT2 20-Tooth Pulley - Live Idler Version | [AliExpress](https://www.aliexpress.us/item/3256803833151466.html) | Make sure you select Bore 5mm Width 6mm. Uses 2x M2 x 2mm Set Screws each (4 total). Pulley body recovered from an unnamed STEP node (one per XY Joint) |

## Belts

| Qty | Part | Buy | Notes |
|---:|---|---|---|
| 1 | Bottom Belt 2.1m | [Amazon](https://amazon.com/dp/B07CDDPCM8) |  |
| 1 | Top Belt 2.1m | [Amazon](https://amazon.com/dp/B07CDDPCM8) |  |

## Spacers (Aluminum)

| Qty | Part | Buy | Notes |
|---:|---|---|---|
| 10 | M5 Spacer 10mm OD 10mm Tall | [AliExpress](https://www.aliexpress.com/item/3256802878592600.html) | 8mm OD is more common and acceptable. Purchase preferred. Printed as alternative with same dimensions.. If purchasing from Aliexpress be sure to select 5.1x10x10 |
| 8 | M3 Spacer 8mm OD 20mm Tall | [Amazon](https://amazon.com/dp/B0F8QLBKYC) | 6mm OD is more common and acceptable. Purchase preferred. Printed as alternative with same dimensions. Optional: use a 6mm OD (or smaller) spacer for the one nearest each end of the Gantry X extrusion (2 total) and the stock 345mm extrusion fits without cutting. |
| 2 | M5 Spacer 8mm OD 20mm Tall | [Amazon](https://amazon.com/dp/B0CRL77N5C) | Purchase preferred. Printed as alternative with same dimensions. |
| 2 | M5 Spacer 8mm OD 30mm Tall | [Amazon](https://amazon.com/dp/B0CQ53LS2B) | Purchase preferred. Printed as alternative with same dimensions. |
| 1 | M5 Spacer 10mm OD 20mm Tall | [Amazon](https://amazon.com/dp/B0D2L3H5LV) | 8mm OD is more common and acceptable. Purchase preferred. Printed as alternative with same dimensions. |

## Xol Toolhead Hardware

*Optional: only needed if you're building the Xol carriage.*

| Qty | Part | Buy | Notes |
|---:|---|---|---|
| 4 | M3 x 6mm BHCS |  | Not required unless building the Xol carriage. |
| 2 | M2 x 12mm BHCS |  | Not required unless building the Xol carriage. |
| 2 | M3 x 30mm Dowel Pin |  | Only dowel used by the Xol Toolhead. Not required unless building the Xol carriage. |
| 2 | Xol 6mm Clamp |  | Not required unless building the Xol carriage. |
| 1 | D2F-L Micro Switch (Endstop) |  | Not required unless building the Xol carriage. |
| 1 | Xol-Carriage_MGN12H_MGN9H_archetype_clips |  | Not required unless building the Xol carriage. |

## Electronics / Endstops

| Qty | Part | Buy | Notes |
|---:|---|---|---|
| 2 | D2F-L Micro Switch (Endstop) | [Amazon](https://amazon.com/dp/B0DBV8XGG4) | Base machine endstops (one in each back assembly). |

## Linear Rails & Sliders

| Qty | Part | Buy | Notes |
|---:|---|---|---|
| 2 | MGN9H Linear Rail Slide |  | Re-usable from Stock |
| 2 | Y MGN9H Rail 402mm |  | Re-usable from Stock |
| 1 | MGN12H Linear Rail Slide |  | Re-usable from Stock |
| 1 | X MGN12H Rail 406mm |  | Re-usable from Stock |

## Linear Rail Mounting Hardware

*The screws and T-nuts that hold the linear rails to the 2020 extrusions: 10 per Y rail and 8 on the X rail.*

| Qty | Part | Buy | Notes |
|---:|---|---|---|
| 28 | M3 x 8mm SHCS | [Amazon](https://amazon.com/dp/B0F5Q6YYWM) | Rail mounting screws: 10 per Y rail (20) and 8 on the X rail, one per M3 T-Nut. |
| 28 | M3 T-Nut | [Amazon](https://amazon.com/dp/B0G2M7W3PL) | Rail mounting T-nuts: 10 per Y rail (20) and 8 on the X rail. |

## Motors

| Qty | Part | Buy | Notes |
|---:|---|---|---|
| 4 | 42-48 Motor 5mmx30-37mm Shaft |  |  |

## Extrusions

| Qty | Part | Buy | Notes |
|---:|---|---|---|
| 2 | Gantry Y-Axis 2020 Extrusion 469mm |  | Stock extrusion works: the front and back motor-mount bolt holes line up with its existing holes. |
| 1 | Gantry X-Axis 2020 Extrusion 342mm |  | Shortened from 345mm: all tensioning now happens at the front motor mounts. The back motor-mount bolt holes line up with the stock extrusion's existing holes. To use the stock 345mm extrusion without cutting it, fit a 6mm OD (or smaller) M3 x 20mm spacer in the spot nearest each end of this extrusion (one per back corner) instead of an 8mm one. If you cut a 345mm extrusion down to 342mm, take 1.5mm off each end: the stock holes are 5mm and 23mm from each end, so an even trim keeps both ends lined up with the back motor-mount holes. |
| 1 | Toolhead X-Axis 2020 Extrusion 426mm |  | Stock extrusion works: the XY joint bolt holes line up with its existing holes (5mm and 25mm from each end). |

## CF Plates

Cutting files are in [`Base Components`](Base%20Components). Click a part name to preview it in 3D.

| Qty | Part | Buy | Notes |
|---:|---|---|---|
| 4 | [XY Live Idler Spacer 5mm CF6mm](Base%20Components/For%20Viewing/XY%20Live%20Idler%20Spacer%205mm%20CF6mm.stl) |  | Cut from the same 6mm carbon fiber plate and machined down to 5mm (no separate 5mm sheet needed). |
| 1 | [Back Left Bottom Plate CF6mm](Base%20Components/For%20Viewing/Back%20Left%20Bottom%20Plate%20CF6mm.stl) |  | Cut from 6mm carbon fiber |
| 1 | [Back Left Top Plate CF6mm](Base%20Components/For%20Viewing/Back%20Left%20Top%20Plate%20CF6mm.stl) |  | Cut from 6mm carbon fiber |
| 1 | [Back Right Bottom Plate CF6mm](Base%20Components/For%20Viewing/Back%20Right%20Bottom%20Plate%20CF6mm.stl) |  | Cut from 6mm carbon fiber |
| 1 | [Back Right Top Plate CF6mm](Base%20Components/For%20Viewing/Back%20Right%20Top%20Plate%20CF6mm.stl) |  | Cut from 6mm carbon fiber |
| 1 | [Front Left Bottom CF6mm](Base%20Components/For%20Viewing/Front%20Left%20Bottom%20CF6mm.stl) |  | Cut from 6mm carbon fiber |
| 1 | [Front Left Top CF6mm](Base%20Components/For%20Viewing/Front%20Left%20Top%20CF6mm.stl) |  | Cut from 6mm carbon fiber |
| 1 | [Front Right Bottom CF6mm](Base%20Components/For%20Viewing/Front%20Right%20Bottom%20CF6mm.stl) |  | Cut from 6mm carbon fiber |
| 1 | [Front Right Top CF6mm](Base%20Components/For%20Viewing/Front%20Right%20Top%20CF6mm.stl) |  | Cut from 6mm carbon fiber |
| 1 | [XY Live Idler Left Bottom Plate CF6mm](Base%20Components/For%20Viewing/XY%20Live%20Idler%20Left%20Bottom%20Plate%20CF6mm.stl) |  | Cut from 6mm carbon fiber |
| 1 | [XY Live Idler Left Top Plate CF6mm](Base%20Components/For%20Viewing/XY%20Live%20Idler%20Left%20Top%20Plate%20CF6mm.stl) |  | Cut from 6mm carbon fiber |
| 1 | [XY Live Idler Right Bottom Plate CF6mm](Base%20Components/For%20Viewing/XY%20Live%20Idler%20Right%20Bottom%20Plate%20CF6mm.stl) |  | Cut from 6mm carbon fiber |
| 1 | [XY Live Idler Right Top Plate CF6mm](Base%20Components/For%20Viewing/XY%20Live%20Idler%20Right%20Top%20Plate%20CF6mm.stl) |  | Cut from 6mm carbon fiber |

## Printed Parts

Print files are in [`Shared Components/Print Ready`](../Shared%20Components/Print%20Ready) (parts common to every version). Click a part name to preview it in 3D.

| Qty | Part | Buy | Notes |
|---:|---|---|---|
| 4 | [Tensioner Lever Arm Revised](../Shared%20Components/Print%20Ready/For%20Viewing/4x%20Tensioner%20Lever%20Arm%20Revised%20-%20For%20Printing.stl) |  | Print it (Shared Components/Print Ready, holes enlarged for printing) or cut it from CF or metal (Shared Components/For Cutting, nominal size). |
| 4 | [Z Carriage Spacer](../Shared%20Components/Print%20Ready/For%20Viewing/4x%20Z%20Carriage%20Spacer%20-%20For%20Printing.stl) |  |  |
| 2 | [Back Spacer Plate 20mm](../Shared%20Components/Print%20Ready/For%20Viewing/2x%20Back%20Spacer%20Plate%2020mm%20-%20For%20Printing.stl) |  |  |
| 2 | [Front Spacer Plate 20mm](../Shared%20Components/Print%20Ready/For%20Viewing/2x%20Front%20Spacer%20Plate%2020mm%20-%20For%20Printing.stl) |  |  |
| 2 | [Printed Back Motor Spacer](../Shared%20Components/Print%20Ready/For%20Viewing/2x%20Printed%20Back%20Motor%20Spacer%20-For%20Printing.stl) |  |  |
| 2 | [XY Live Idler Spacer](../Shared%20Components/Print%20Ready/For%20Viewing/2x%20XY%20Live%20Idler%20Spacer%20-%20For%20Printing.stl) |  |  |
