MASantangelo/SV08-Enhanced-Gantry-Projects/CF Version/Base Assemblies/9mm Belt Mod/Back Left Motor Assembly CF6mm (For 9mm Belts).step

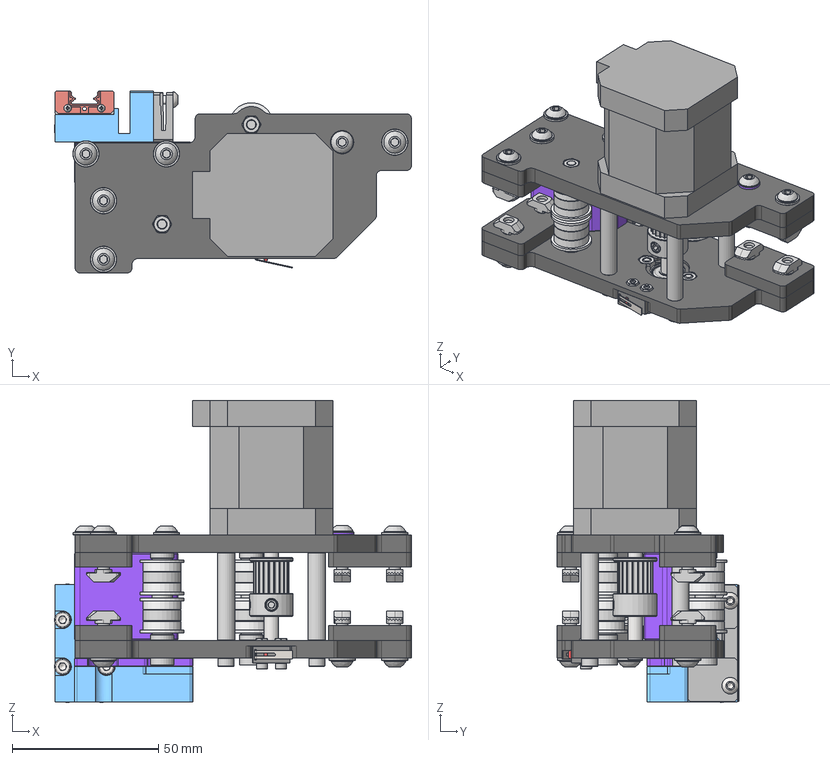
[picture p39: CAD file, 2026-11-04]
CF Version/Base Assemblies/9mm Belt Mod/Back Left Motor Assembly CF6mm (For 9mm Belts).step
121.9 x 62.2 x 103.3 mm
CF6BRTMP
CF6BRBMP
F695 Bearing x 9
4668K226_Permanently Lubricated 440C Stainless Steel Ball Bearing x 4
D2F_Bottom^D2F-L_Straight
D2F_Top^D2F-L_Straight
D2F_Button^D2F-L_Straight
D2F_Pin^D2F-L_Straight x 4
D2F_Hinge^D2F-L_Straight
D5M3x35mmSB x 2
6000N209_NO THREADS_T-Slotted Framing Fasteners x 8
FL Z Carriage Spacer 3mm
GB-T-70.1-2000-M3x6 内六角圆柱 头螺丝 hex socket cylindrical head screws x 4
JXHSV08-02005-d AB轴安装板1 AB-axis m ounting plate1
JXHSV08-02006-d Z轴皮带压板2 z-axis belt clip plate
GB-T-70.2-2000-M3x10 内六角平圆 头螺钉 hex socket flat round head screw x 2
MGN9HZ1C 滑块 slider
