MASantangelo/SV08-Enhanced-Gantry-Projects/CF Version/Base Assemblies/9mm Belt Mod/For Viewing/Front Left Motor Assembly CF6mm (For 9mm Belts).stl

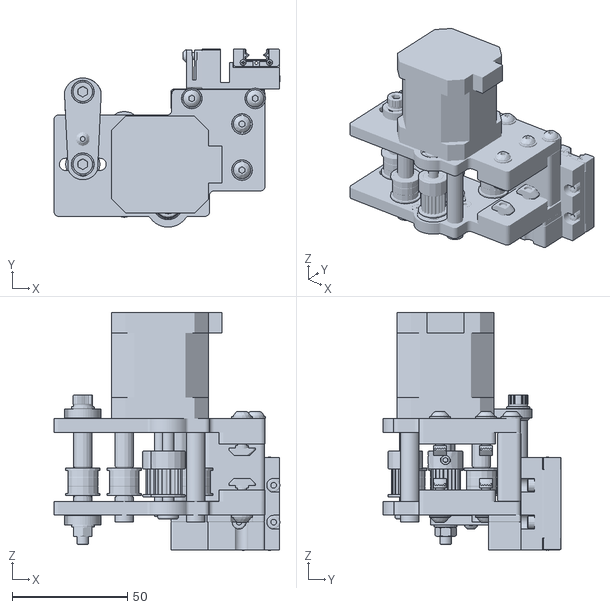
[picture p40: CAD file, 2026-11-04]
CF Version/Base Assemblies/9mm Belt Mod/For Viewing/Front Left Motor Assembly CF6mm (For 9mm Belts).stl
98.1 x 77.3 x 103.3
