MASantangelo/SV08-Enhanced-Gantry-Projects/CF Version/Base Assemblies/Back Right Motor Assembly CF6mm.step

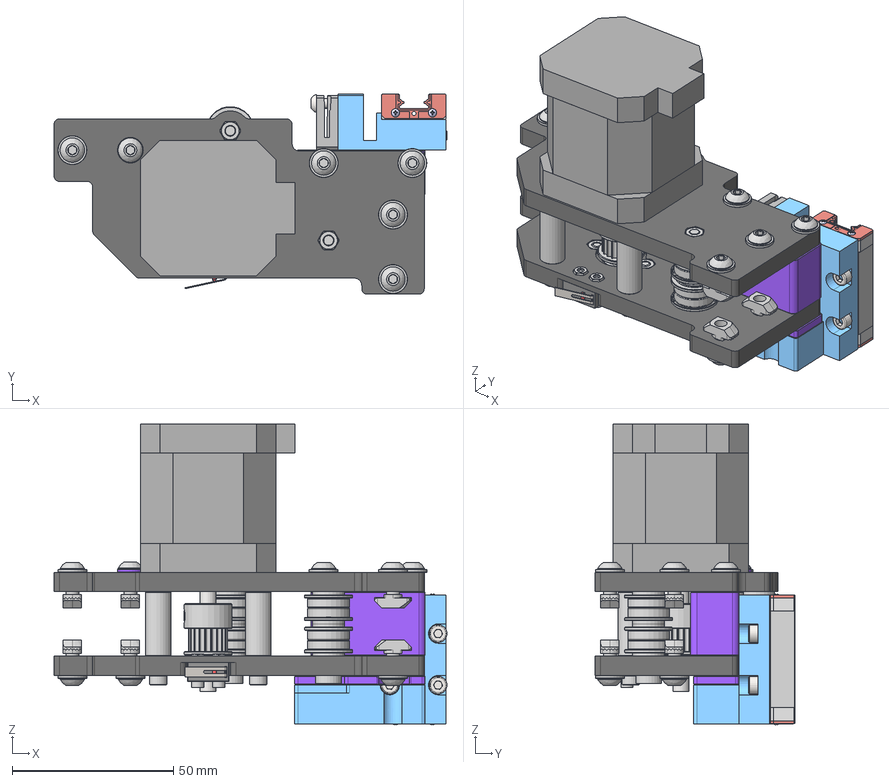
[picture p41: CAD file, 2026-11-01]
CF Version/Base Assemblies/Back Right Motor Assembly CF6mm.step
121.9 x 62.2 x 93.3 mm
CF6BLBMP
CF6BLTMP
JXHSV08-03018-h 42-48电机(左侧) 42-48 motor left side
7804K138_Corrosion-Resistant 440C Stainless Steel Ball Bearing x 8
98089A375_18-8 Stainless Steel Shim x 8
F695 Bearing
D2F_Bottom^D2F-L_Straight
D2F_Top^D2F-L_Straight
D2F_Button^D2F-L_Straight
D2F_Pin^D2F-L_Straight x 4
D2F_Hinge^D2F-L_Straight
D5M3x25mmSB x 2
3684N12_Corrosion-Resistant Aluminum Gt Timing Belt Pulley
92290A763_NO THREADS_Super-Corrosion-Resistant 316 Stainless Steel So cket Head Screw x 4
FL Z Carriage Spacer 3mm
GB-T-70.1-2000-M3x6 内六角圆柱 头螺丝 hex socket cylindrical head screws x 4
JXHSV08-02005-d AB轴安装板1 AB-axis m ounting plate1
JXHSV08-02006-d Z轴皮带压板2 z-axis belt clip plate
GB-T-70.2-2000-M3x10 内六角平圆 头螺钉 hex socket flat round head screw x 2
MGN9HZ1C 滑块 slider
BL Plate Spacer 20mm
92095A190_NO THREADS_18-8 Stainless Steel Button Head Hex-Drive Screw x 8
92125A126_NO THREADS_18-8 Stainless Steel Hex-Drive Flat Head Screw x 2
92095A205_NO THREADS_Button Head Hex Drive Screw x 2
91292A832_NO THREADS_18-8 Stainless Steel Socket Head Screw x 2
90591A349_NO THREADS_Zinc-Plated Steel Hex Nut x 2
6000N209_NO THREADS_T-Slotted Framing Fasteners x 8
94669A061_Aluminum Unthreaded Spacer x 4
