MASantangelo/SV08-Enhanced-Gantry-Projects/Metal Version/Base Assemblies/For Viewing/Front Left Motor Assembly Metal5mm.stl

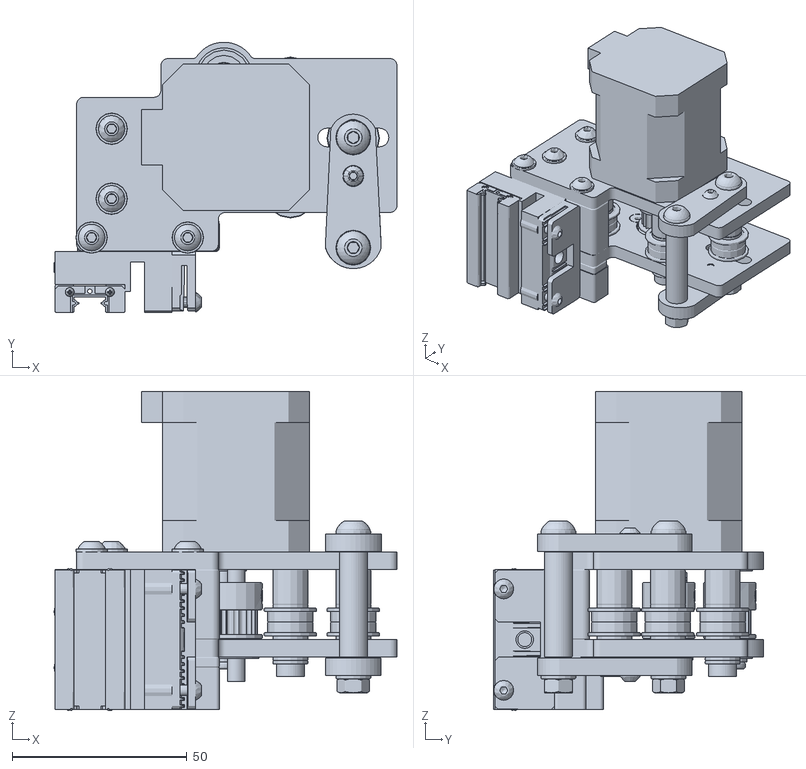
[picture p42: CAD file, 2026-10-22]
Metal Version/Base Assemblies/For Viewing/Front Left Motor Assembly Metal5mm.stl
98.1 x 77.3 x 91.3
