MASantangelo/SV08-Enhanced-Gantry-Projects/Metal Version/Base Assemblies/Front Right Motor Assembly Metal5mm.step

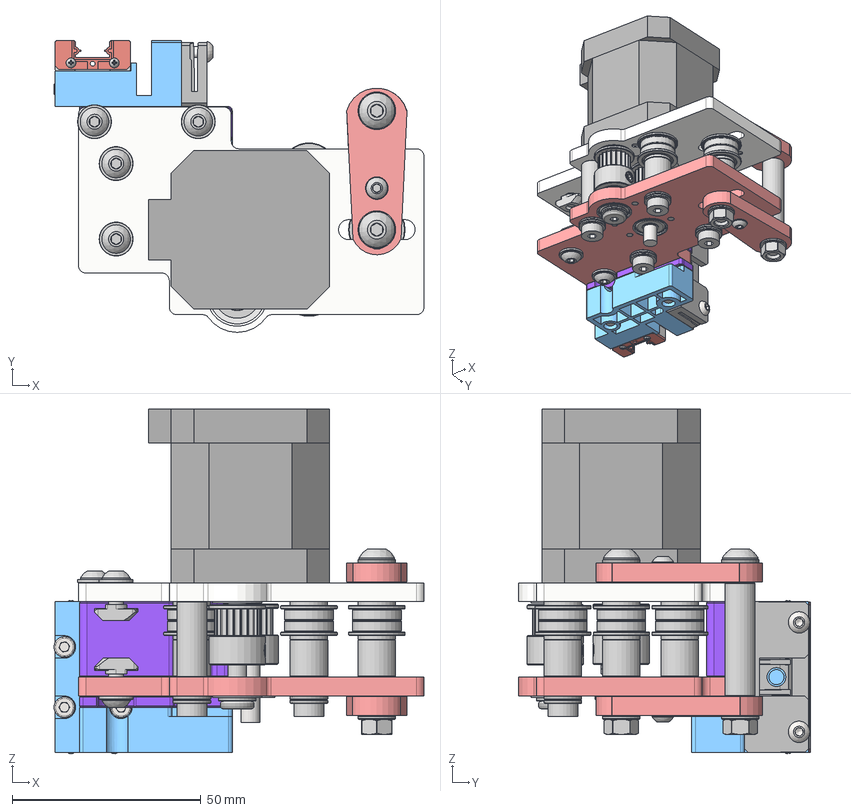
[picture p43: CAD file, 2026-10-22]
Metal Version/Base Assemblies/Front Right Motor Assembly Metal5mm.step
98.1 x 77.3 x 91.3 mm
P6FRBMP
P6FRTMP
JXHSV08-03018-h 42-48电机(左侧) 42-48 motor left side
D5 M3x36mm Shoulder Bolt x 4
F695 Bearing x 3
7804K138_Corrosion-Resistant 440C Stainless Steel Ball Bearing x 8
98089A375_18-8 Stainless Steel Shim x 8
Front Spacer Plate 20mm x2
3684N12_Corrosion-Resistant Aluminum Gt Timing Belt Pulley x 2
MGN9HZ1C 滑块 slider
JXHSV08-02006-d Z轴皮带压板2 z-axis belt clip plate
GB-T-70.2-2000-M3x10 内六角平圆 头螺钉 hex socket flat round head screw x 2
JXHSV08-02005-d AB轴安装板1 AB-axis m ounting plate1
GB-T-70.1-2000-M3x6 内六角圆柱 头螺丝 hex socket cylindrical head screws x 4
6000N209_NO THREADS_T-Slotted Framing Fasteners x 4
Tensioner Lever Arm Revised x 2
FL Z Carriage Spacer 3mm
