MASantangelo/SV08-Enhanced-Gantry-Projects/Printed Version/Base Assemblies/For Viewing/Front Right Motor Assembly Printed 6mm.stl

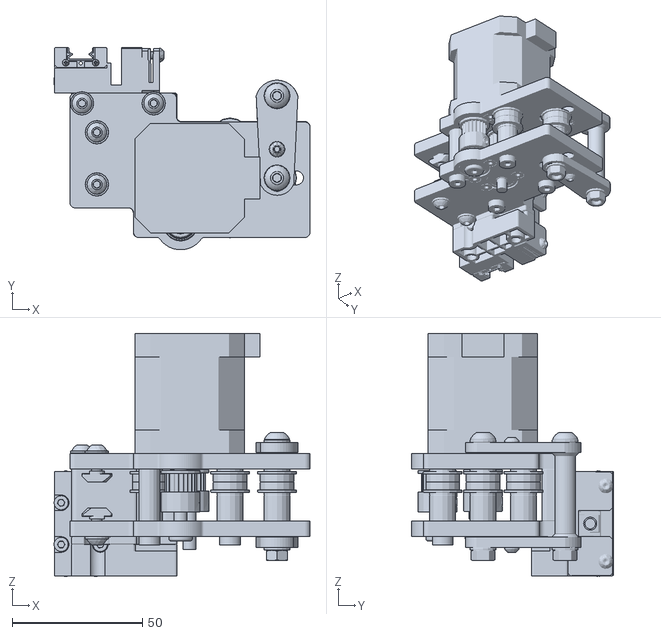
[picture p44: CAD file, 2026-10-22]
Printed Version/Base Assemblies/For Viewing/Front Right Motor Assembly Printed 6mm.stl
98.2 x 77.6 x 93.3
