MASantangelo/SV08-Enhanced-Gantry-Projects/CF Version/Base Assemblies/9mm Belt Mod/Front Right Motor Assembly CF6mm (For 9mm Belts).step

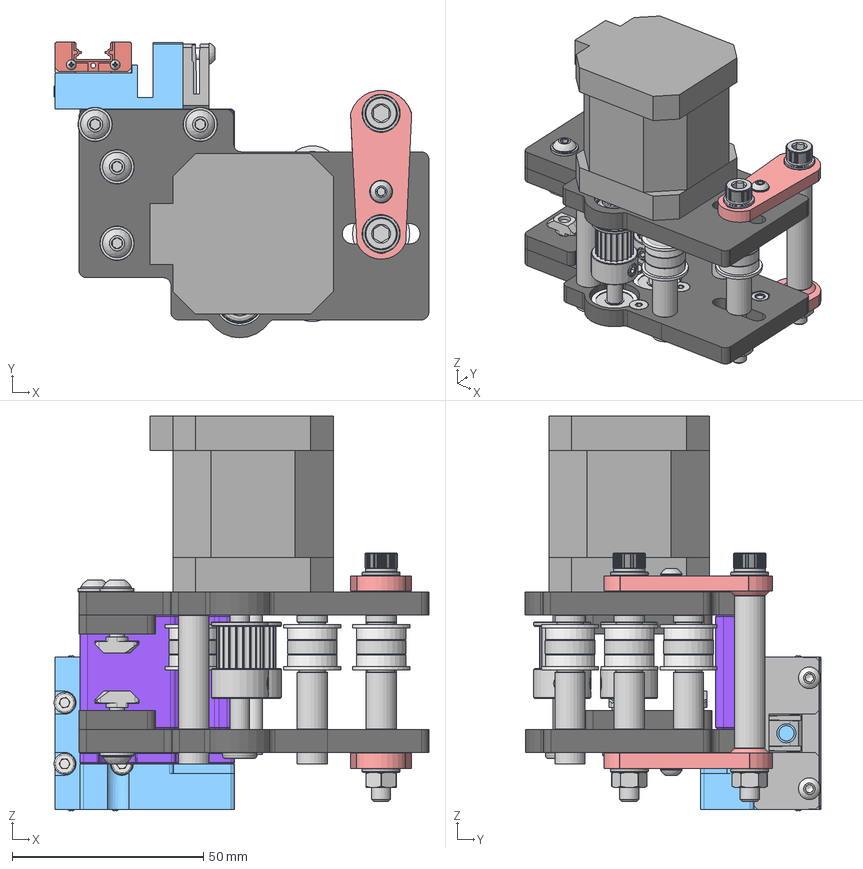
[picture p45: CAD file, 2026-11-04]
CF Version/Base Assemblies/9mm Belt Mod/Front Right Motor Assembly CF6mm (For 9mm Belts).step
98.1 x 77.3 x 103.3 mm
CF6FRBMP
CF6FRTMP
6000N209_NO THREADS_T-Slotted Framing Fasteners x 4
D5M3x40mmSB x 4
F695 Bearing x 11
FL Z Carriage Spacer 3mm
MGN9HZ1C 滑块 slider
JXHSV08-02006-d Z轴皮带压板2 z-axis belt clip plate
GB-T-70.2-2000-M3x10 内六角平圆 头螺钉 hex socket flat round head screw x 2
JXHSV08-02005-d AB轴安装板1 AB-axis m ounting plate1
GB-T-70.1-2000-M3x6 内六角圆柱 头螺丝 hex socket cylindrical head screws x 4
4668K226_Permanently Lubricated 440C Stainless Steel Ball Bearing x 4
Tensioner Lever Arm Revised x 2
