MASantangelo/SV08-Enhanced-Gantry-Projects/Metal Version/Base Assemblies/Front Left Motor Assembly Metal5mm.step

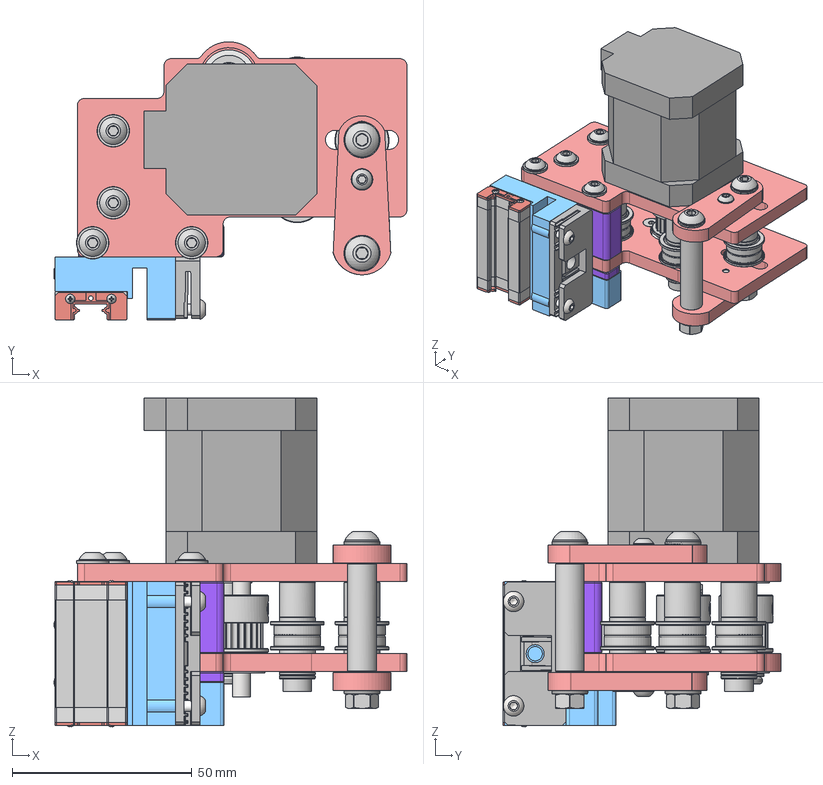
[picture p46: CAD file, 2026-10-22]
Metal Version/Base Assemblies/Front Left Motor Assembly Metal5mm.step
98.1 x 77.3 x 91.3 mm
P6FLBMP
P6FLTMP
F695 Bearing x 3
JXHSV08-03018-h 42-48电机(左侧) 42-48 motor left side
D5 M3x36mm Shoulder Bolt x 4
7804K138_Corrosion-Resistant 440C Stainless Steel Ball Bearing x 8
98089A375_18-8 Stainless Steel Shim x 8
3684N12_Corrosion-Resistant Aluminum Gt Timing Belt Pulley x 2
JXHSV08-02006-d Z轴皮带压板2 z-axis belt clip plate
GB-T-70.1-2000-M3x6 内六角圆柱 头螺丝 hex socket cylindrical head screws x 3
JXHSV08-02013-d AB轴安装板2 ab axis i nstall plate2
MGN9HZ1C 滑块 slider
GB-T-70.2-2000-M3x10 内六角平圆 头螺钉 hex socket flat round head screw x 2
GB-T-70.1-2000-M3x6 内六角圆柱 头螺丝 hex socket cylindrical head screws_1
6000N209_NO THREADS_T-Slotted Framing Fasteners x 4
Tensioner Lever Arm Revised x 2
FL Z Carriage Spacer 3mm
Front Spacer Plate 20mm x2
94669A063_Aluminum Unthreaded Spacer
94669A079_Aluminum Unthreaded Spacer x 4
92095A182_NO THREADS_18-8 Stainless Steel Button Head Hex-Drive Screw x 2
94669A130_Aluminum Unthreaded Spacer
