MASantangelo/SV08-Enhanced-Gantry-Projects/CF Version/Base Assemblies/For Viewing/Front Left Motor Assembly CF6mm.stl

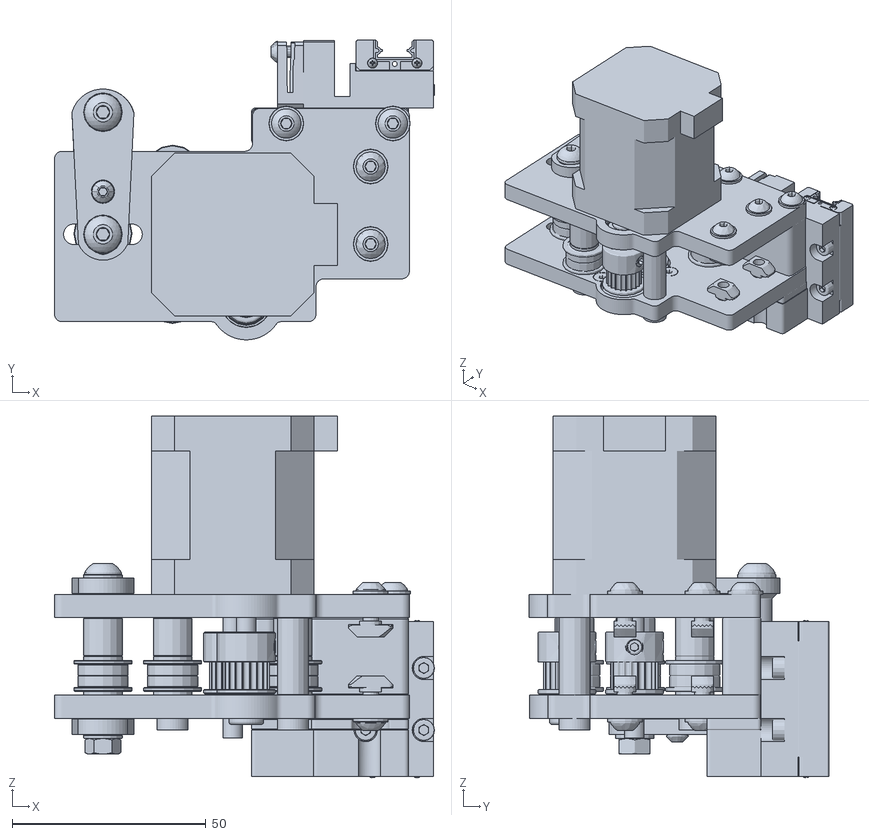
[picture p51: CAD file, 2026-10-22]
CF Version/Base Assemblies/For Viewing/Front Left Motor Assembly CF6mm.stl
98.1 x 77.3 x 93.3
