MASantangelo/SV08-Enhanced-Gantry-Projects/CF Version/9mm Belt Mod/For Viewing/SV08-CF6 Dual Shear Live Idlers Front Tensioners (for 9mm Belts).stl

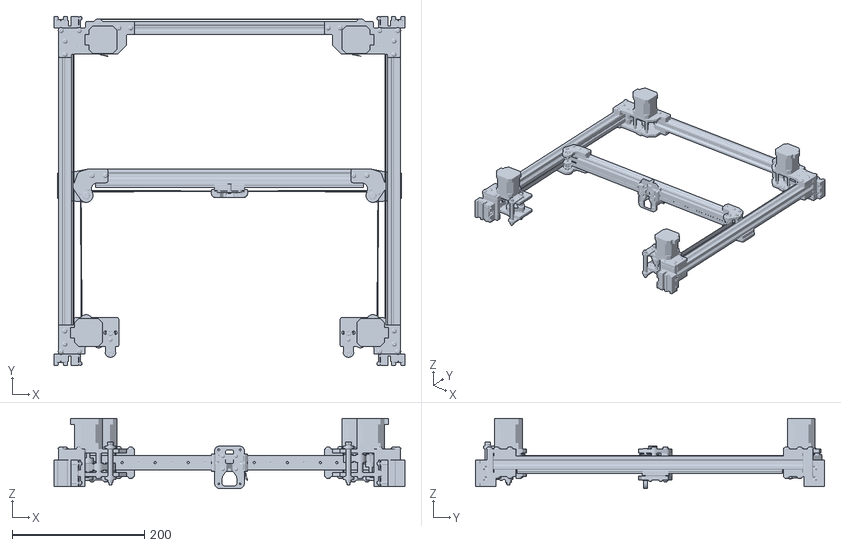
[picture p52: CAD file, 2026-11-04]
CF Version/9mm Belt Mod/For Viewing/SV08-CF6 Dual Shear Live Idlers Front Tensioners (for 9mm Belts).stl
531.5 x 529.0 x 106.2
