MASantangelo/SV08-Enhanced-Gantry-Projects/CF Version/Base Assemblies/9mm Belt Mod/For Viewing/XY Joint Left CF6mm (For 9mm Belts).stl

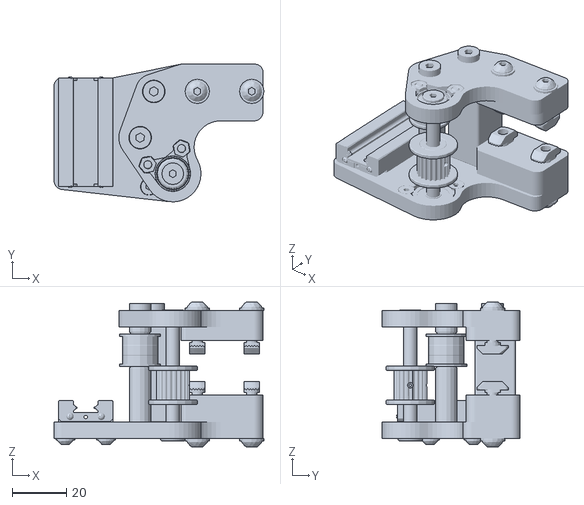
[picture p53: CAD file, 2026-11-04]
CF Version/Base Assemblies/9mm Belt Mod/For Viewing/XY Joint Left CF6mm (For 9mm Belts).stl
77.1 x 50.6 x 53.2
