MASantangelo/SV08-Enhanced-Gantry-Projects/CF Version/Base Assemblies/For Viewing/XY Joint Left CF6mm.stl

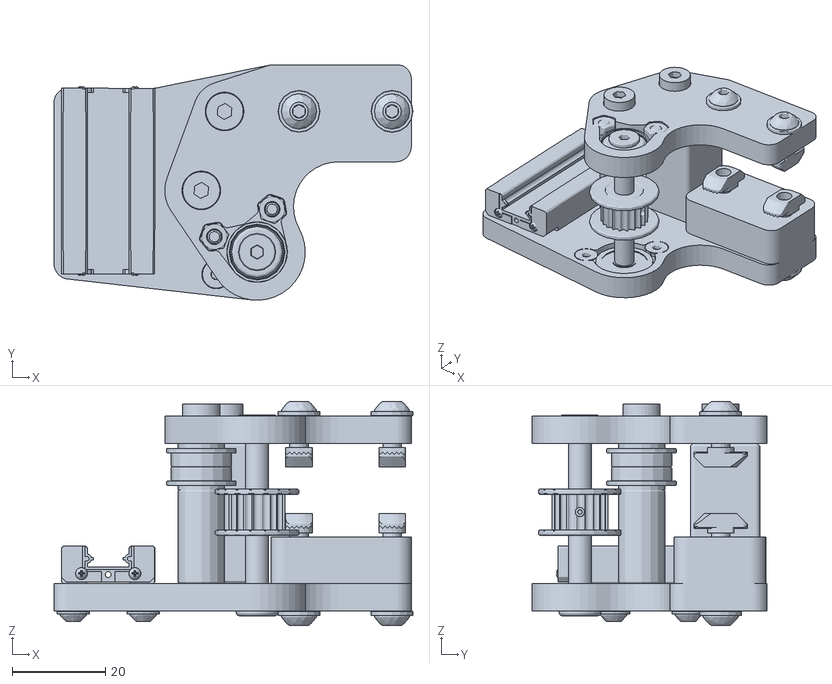
[picture p54: CAD file, 2026-11-04]
CF Version/Base Assemblies/For Viewing/XY Joint Left CF6mm.stl
77.2 x 50.6 x 48.2
