MASantangelo/SV08-Enhanced-Gantry-Projects/CF Version/Base Components/9mm Belt Mod/For Viewing/Back Motor 5mm Spacer for X Gantry.stl

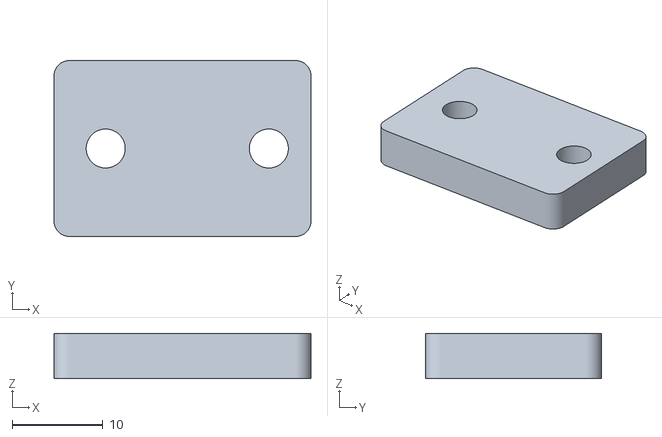
[picture p55: CAD file, 2026-11-04]
CF Version/Base Components/9mm Belt Mod/For Viewing/Back Motor 5mm Spacer for X Gantry.stl
28.3 x 19.4 x 5.00
