MASantangelo/SV08-Enhanced-Gantry-Projects/CF Version/Base Components/9mm Belt Mod/Front Motor 5mm Spacer for Y Gantry.step

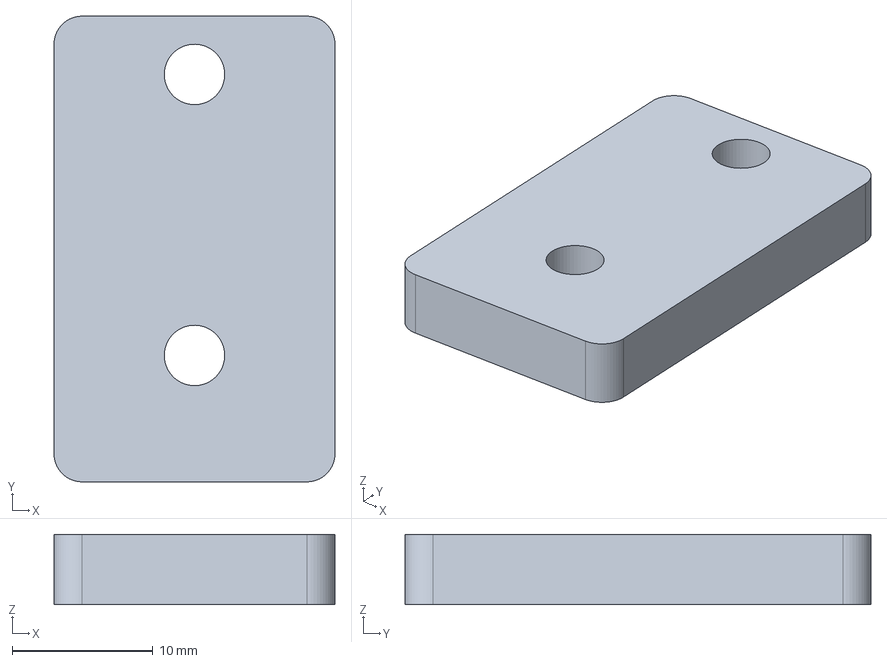
[picture p56: CAD file, 2026-11-04]
CF Version/Base Components/9mm Belt Mod/Front Motor 5mm Spacer for Y Gantry.step
20.0 x 33.2 x 5.00 mm
