MASantangelo/SV08-Enhanced-Gantry-Projects/CF Version/Base Components/For Viewing/XY Live Idler Left Top Plate CF6mm.stl

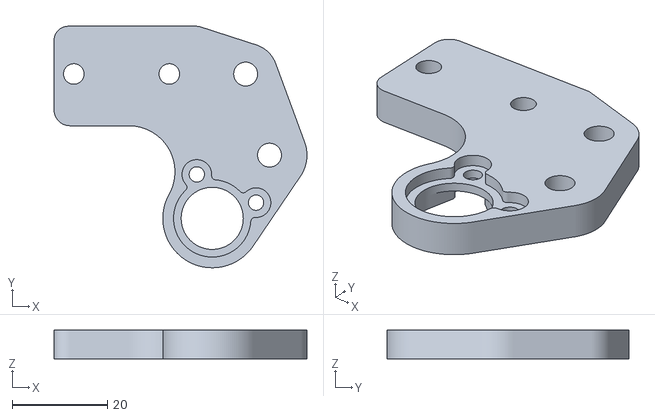
[picture p57: CAD file, 2026-11-04]
CF Version/Base Components/For Viewing/XY Live Idler Left Top Plate CF6mm.stl
53.0 x 50.6 x 6.00
