MASantangelo/SV08-Enhanced-Gantry-Projects/CF Version/For Viewing/SV08-CF6 Dual Shear Live Idlers Front Tensioners.stl

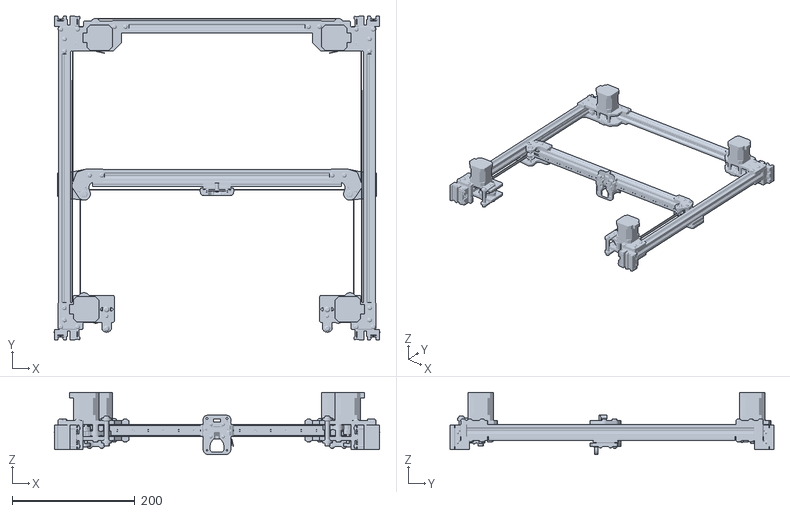
[picture p58: CAD file, 2026-11-04]
CF Version/For Viewing/SV08-CF6 Dual Shear Live Idlers Front Tensioners.stl
531.5 x 529.0 x 101.3
