MASantangelo/SV08-Enhanced-Gantry-Projects/Metal Version/Base Assemblies/For Viewing/XY Joint Right Metal5mm.stl

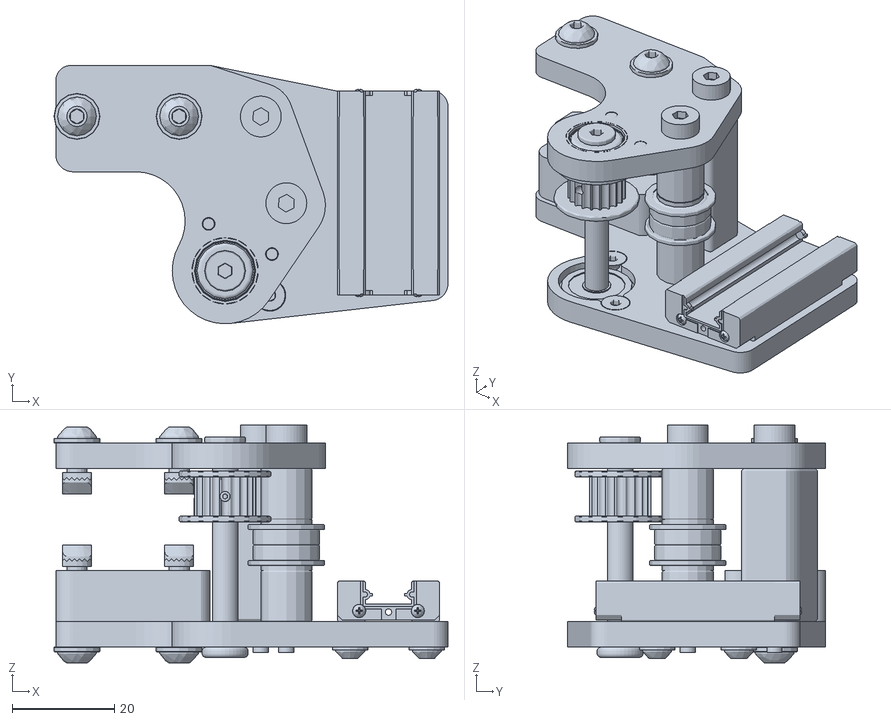
[picture p59: CAD file, 2026-11-04]
Metal Version/Base Assemblies/For Viewing/XY Joint Right Metal5mm.stl
77.1 x 50.6 x 46.6
