MASantangelo/SV08-Enhanced-Gantry-Projects/Metal Version/Base Assemblies/XY Joint Right Metal5mm.step

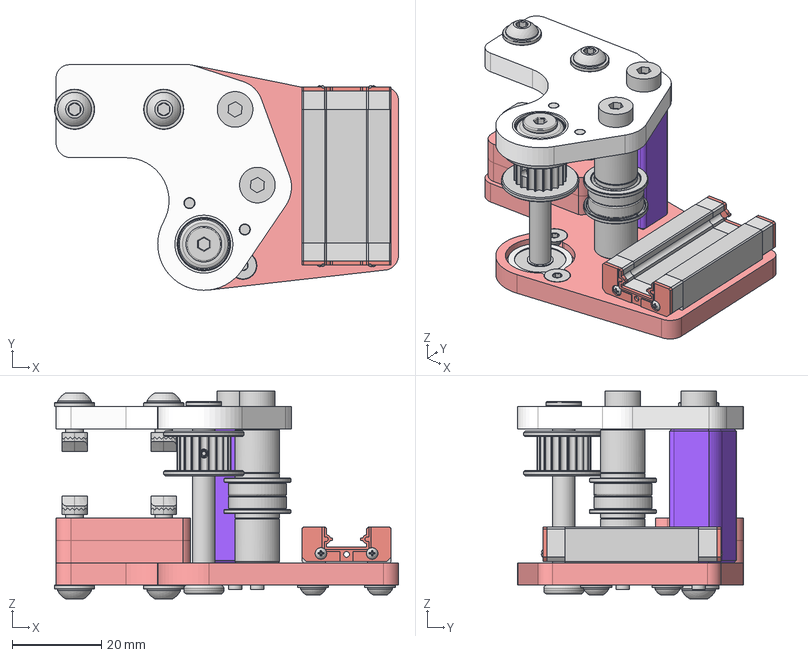
[picture p60: CAD file, 2026-11-04]
Metal Version/Base Assemblies/XY Joint Right Metal5mm.step
77.1 x 50.6 x 46.6 mm
M5XYRBP
M5XYRTP
M5XY5mmSP x 2
D5M3x35mmSB x 2
F695 Bearing x 2
7804K138_Corrosion-Resistant 440C Stainless Steel Ball Bearing x 2
98089A375_18-8 Stainless Steel Shim x 2
92015A011_NO THREADS_18-8 Stainless Steel Cup-Point Set Screw x 2
MGN9HZ1C 滑块 slider
6000N209_NO THREADS_T-Slotted Framing Fasteners x 4
XY Left 3rd Post Spacer
92125A125_NO THREADS_18-8 Stainless Steel Hex-Drive Flat Head Screw x 4
