MASantangelo/SV08-Enhanced-Gantry-Projects/Metal Version/For Viewing/SV08-M5 Dual Shear Live Idlers Front Tensioners.stl

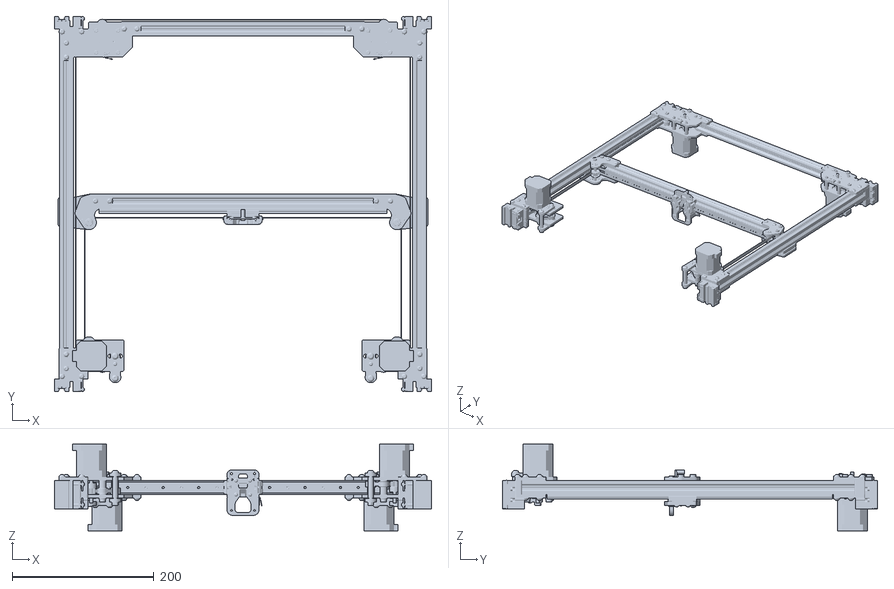
[picture p62: CAD file, 2026-11-04]
Metal Version/For Viewing/SV08-M5 Dual Shear Live Idlers Front Tensioners.stl
531.5 x 529.0 x 122.0
