MASantangelo/SV08-Enhanced-Gantry-Projects/Printed Version/Base Assemblies/For Viewing/XY Joint Left Printed 6mm.stl

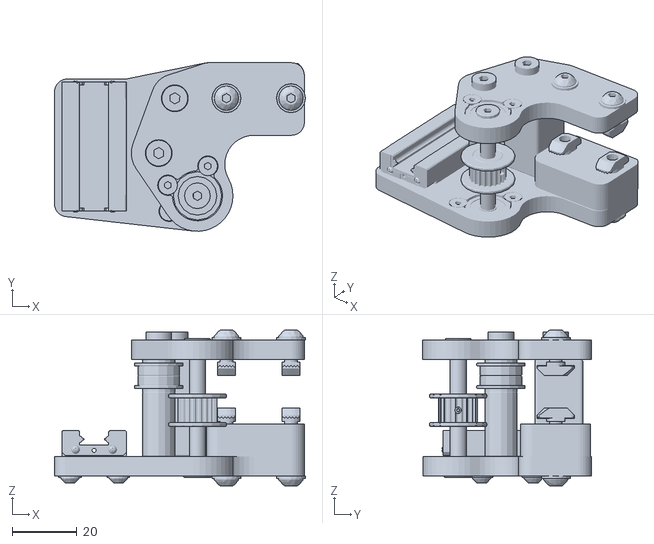
[picture p63: CAD file, 2026-11-04]
Printed Version/Base Assemblies/For Viewing/XY Joint Left Printed 6mm.stl
77.8 x 52.2 x 48.2
