MASantangelo/SV08-Enhanced-Gantry-Projects/Printed Version/Base Components/Print Ready/For Viewing/XY Live Idler Right Bottom Plate Printed6mm - For Printing.stl

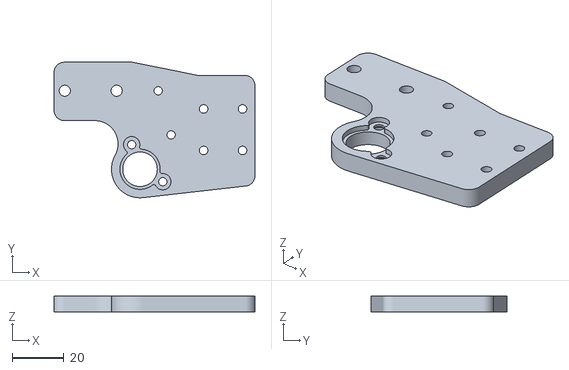
[picture p64: CAD file, 2026-11-04]
Printed Version/Base Components/Print Ready/For Viewing/XY Live Idler Right Bottom Plate Printed6mm - For Printing.stl
77.4 x 52.2 x 6.00
