MASantangelo/SV08-Enhanced-Gantry-Projects/Printed Version/Base Components/Print Ready/XY Live Idler Right Top Plate Printed6mm - For Printing.step

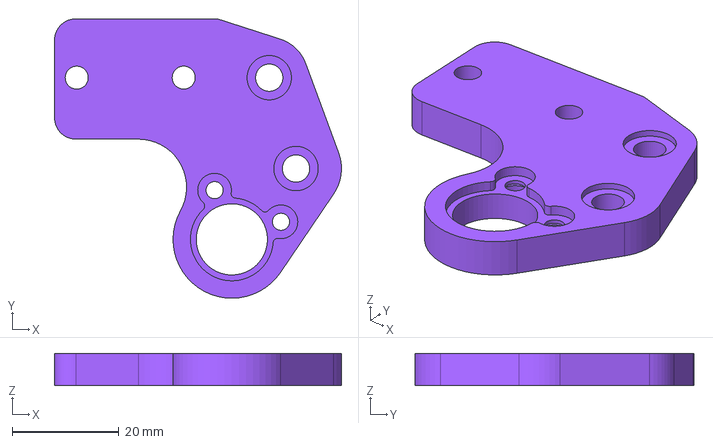
[picture p65: CAD file, 2026-11-04]
Printed Version/Base Components/Print Ready/XY Live Idler Right Top Plate Printed6mm - For Printing.step
53.7 x 52.2 x 6.00 mm
