MASantangelo/SV08-Enhanced-Gantry-Projects/Printed Version/For Viewing/SV08-P6 Dual Shear Live Idlers Front Tensioners.stl

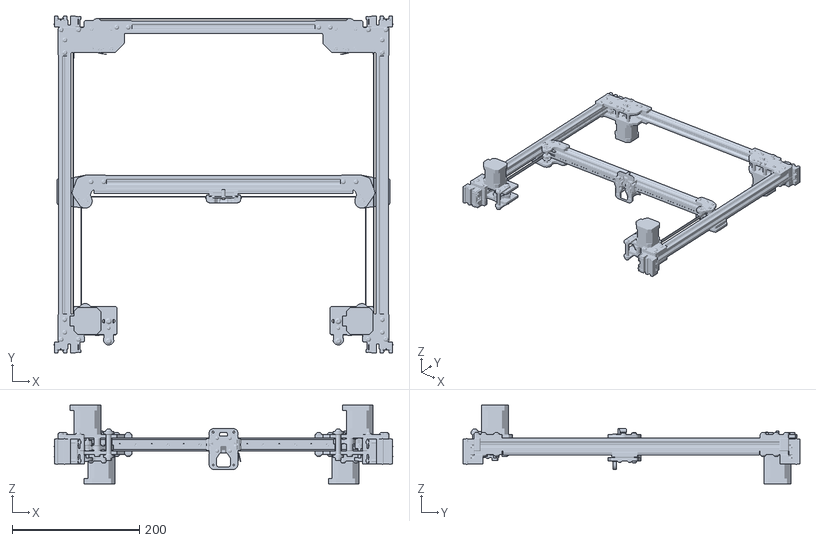
[picture p66: CAD file, 2026-11-04]
Printed Version/For Viewing/SV08-P6 Dual Shear Live Idlers Front Tensioners.stl
531.5 x 529.0 x 124.0
