MASantangelo/SV08-Enhanced-Gantry-Projects/Shared Components/For Cutting/For Viewing/Tensioner Lever Arm Revised.stl

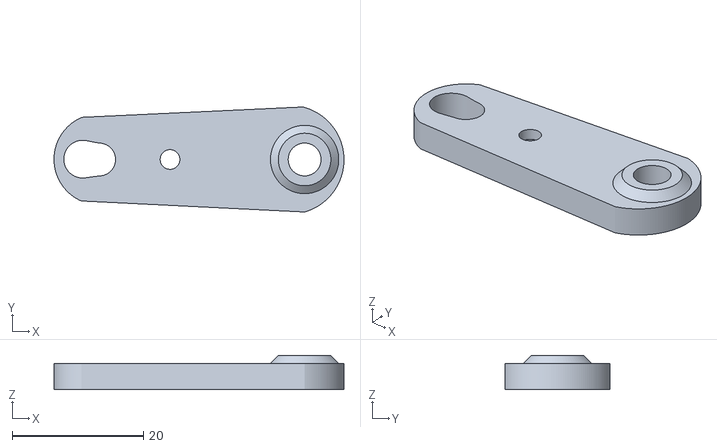
[picture p67: CAD file, 2026-10-13]
Shared Components/For Cutting/For Viewing/Tensioner Lever Arm Revised.stl
44.2 x 16.0 x 5.20
