MASantangelo/SV08-Enhanced-Gantry-Projects/Shared Components/Print Ready/2x Back Spacer Plate 30mm - For Printing.step

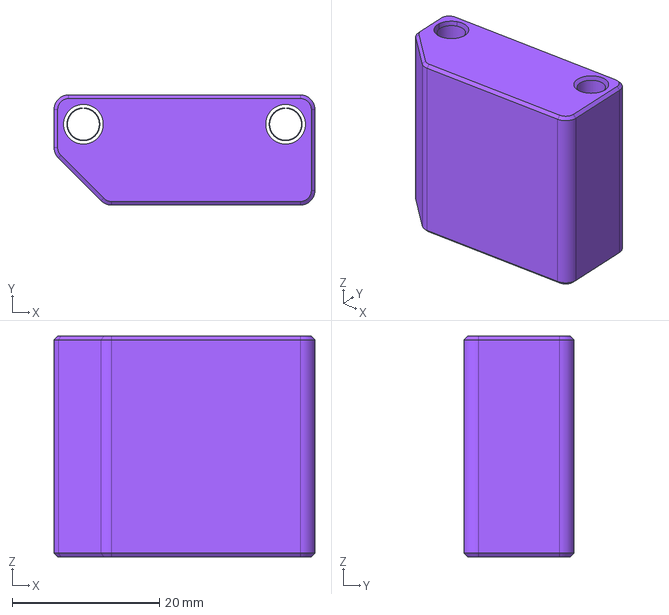
[picture p68: CAD file, 2026-11-04]
Shared Components/Print Ready/2x Back Spacer Plate 30mm - For Printing.step
35.5 x 15.0 x 30.0 mm
