MASantangelo/SV08-Enhanced-Gantry-Projects/Shared Components/Stock Parts/For Viewing/SV08 Stock Gantry Y Extrusion.stl

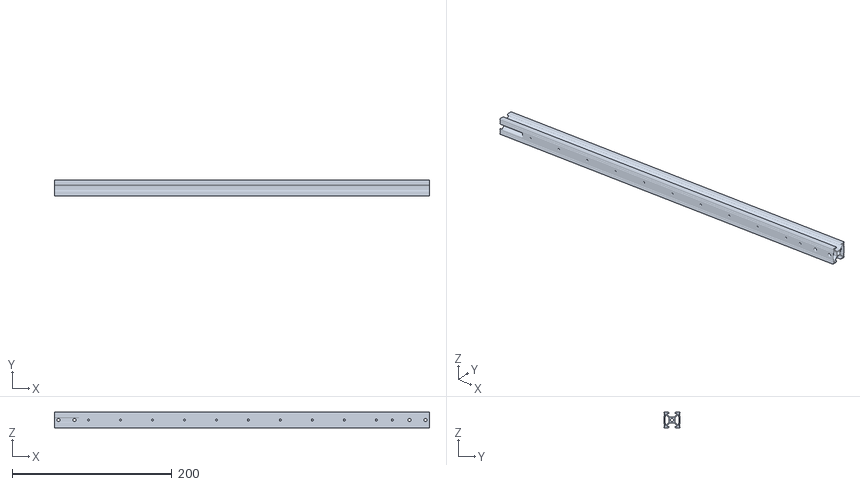
[picture p69: CAD file, 2026-10-22]
Shared Components/Stock Parts/For Viewing/SV08 Stock Gantry Y Extrusion.stl
469.0 x 20.0 x 20.0
