MASantangelo/SV08-Enhanced-Gantry-Projects/Shared Components/Stock Parts/SV08 Stock Gantry X Extrusion.step

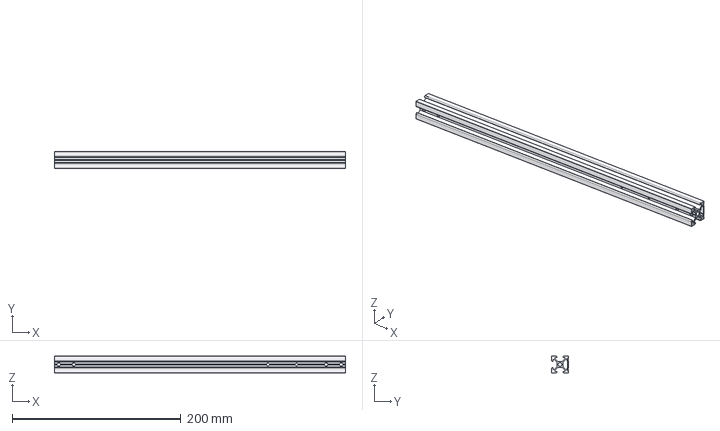
[picture p70: CAD file, 2026-10-22]
Shared Components/Stock Parts/SV08 Stock Gantry X Extrusion.step
345.0 x 20.0 x 20.0 mm
