MASantangelo/SV08-Enhanced-Gantry-Projects/CF Version/Base Components/9mm Belt Mod/Back Motor 5mm Spacer for Y Gantry.step

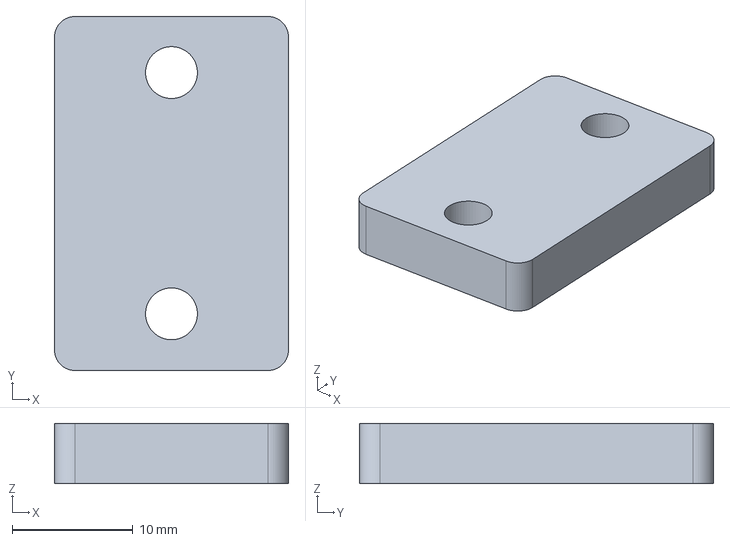
[picture p71: CAD file, 2026-11-04]
CF Version/Base Components/9mm Belt Mod/Back Motor 5mm Spacer for Y Gantry.step
19.4 x 29.4 x 5.00 mm
