MASantangelo/SV08-Enhanced-Gantry-Projects/CF Version/Base Components/For Viewing/XY Live Idler Right Bottom Plate CF6mm.stl

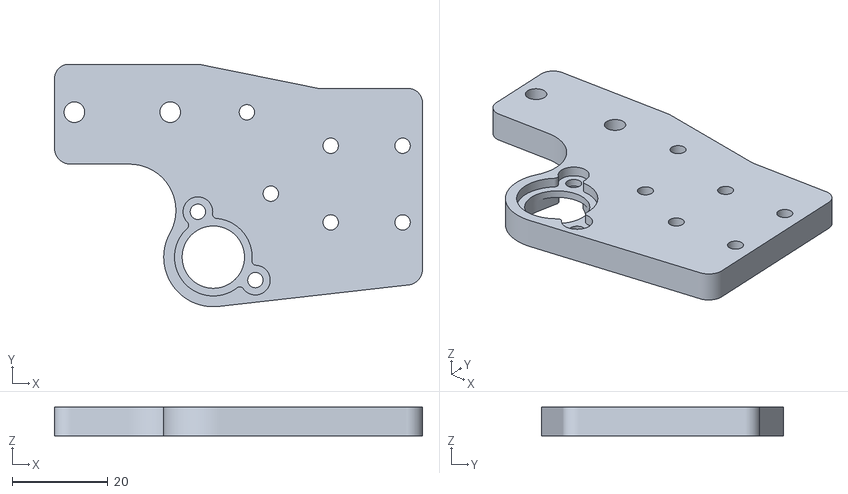
[picture p72: CAD file, 2026-11-04]
CF Version/Base Components/For Viewing/XY Live Idler Right Bottom Plate CF6mm.stl
76.8 x 50.6 x 6.00
