MASantangelo/SV08-Enhanced-Gantry-Projects/Metal Version/Base Components/For Viewing/XY Live Idler Right Top Plate Metal5mm.stl

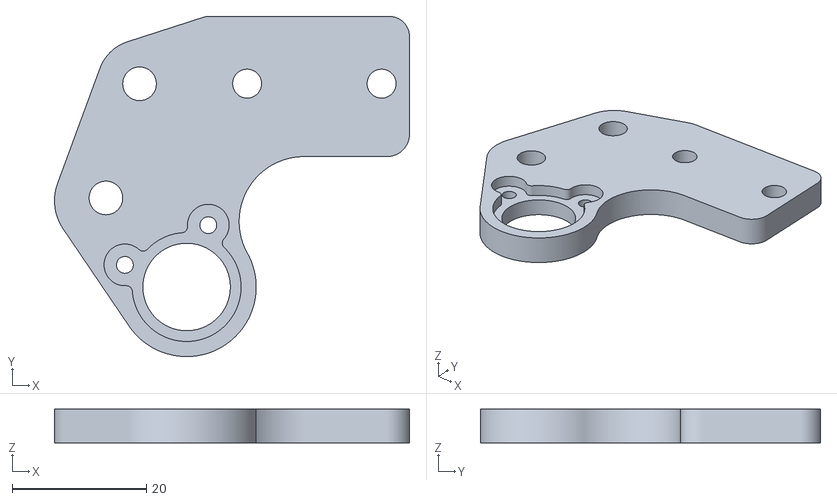
[picture p73: CAD file, 2026-11-04]
Metal Version/Base Components/For Viewing/XY Live Idler Right Top Plate Metal5mm.stl
52.8 x 50.6 x 5.00
