MASantangelo/SV08-Enhanced-Gantry-Projects/Shared Components/Print Ready/2x Front Spacer Plate 30mm - For Printing.step

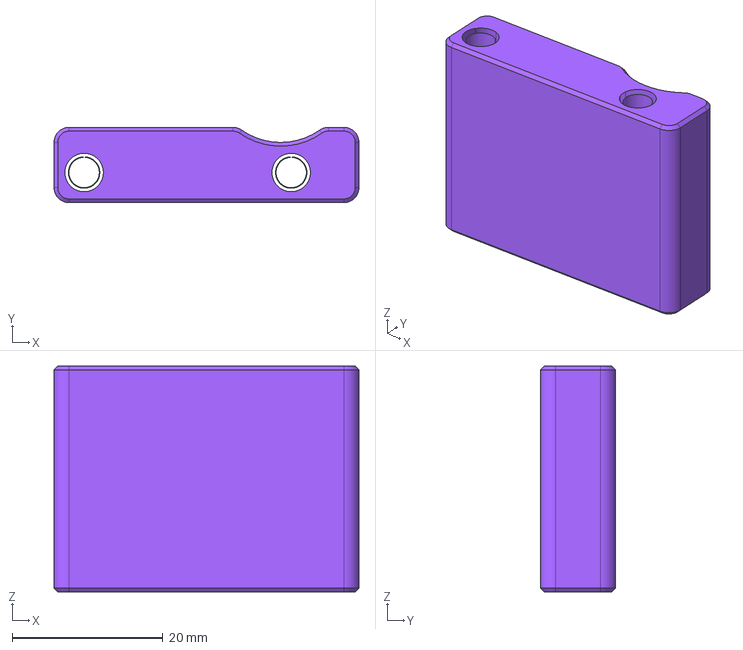
[picture p74: CAD file, 2026-11-04]
Shared Components/Print Ready/2x Front Spacer Plate 30mm - For Printing.step
40.5 x 10.0 x 30.0 mm
