MASantangelo/SV08-Enhanced-Gantry-Projects/Shared Components/Print Ready/For Viewing/2x XY Live Idler Spacer 35mm - For Printing.stl

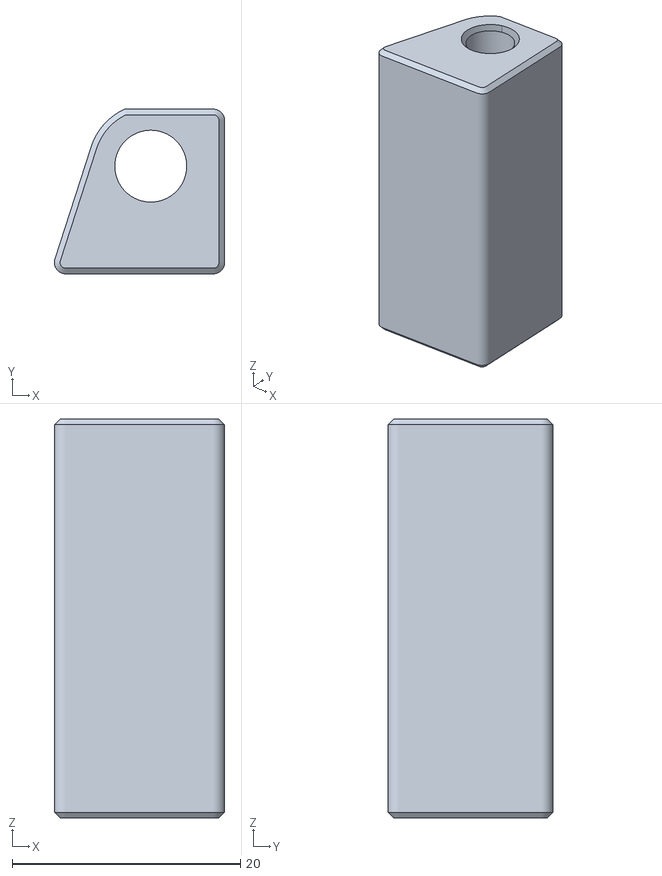
[picture p75: CAD file, 2026-11-04]
Shared Components/Print Ready/For Viewing/2x XY Live Idler Spacer 35mm - For Printing.stl
14.9 x 14.4 x 35.0
