MASantangelo/SV08-Enhanced-Gantry-Projects/Shared Components/Stock Parts/For Viewing/SV08 Stock Toolhead Extrusion.stl

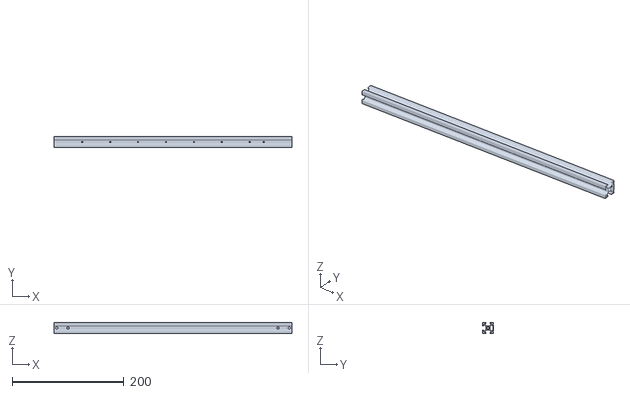
[picture p76: CAD file, 2026-10-22]
Shared Components/Stock Parts/For Viewing/SV08 Stock Toolhead Extrusion.stl
426.0 x 20.0 x 20.0
