MASantangelo/SV08-Enhanced-Gantry-Projects/Shared Components/Print Ready/For Viewing/4x Z Carriage Spacer - For Printing.stl

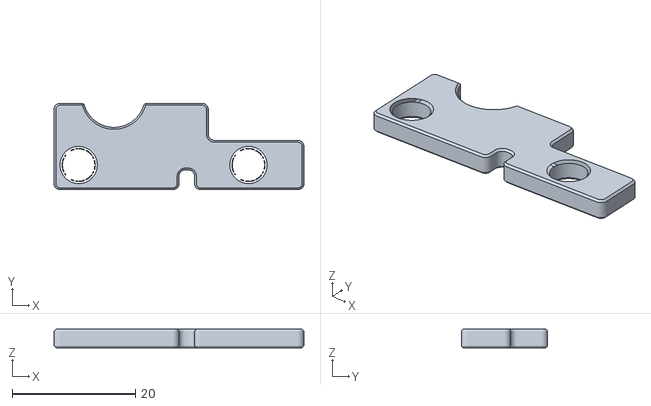
[picture p77: CAD file, 2026-10-11]
Shared Components/Print Ready/For Viewing/4x Z Carriage Spacer - For Printing.stl
40.5 x 14.0 x 3.00
