MASantangelo/SV08-Enhanced-Gantry-Projects/CF Version/Base Components/Back Left Top Plate CF6mm.step

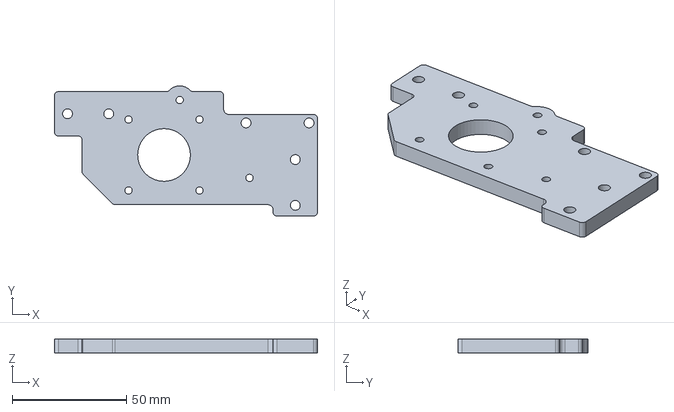
[picture p78: CAD file, 2026-11-01]
CF Version/Base Components/Back Left Top Plate CF6mm.step
114.9 x 56.9 x 6.00 mm
