MASantangelo/SV08-Enhanced-Gantry-Projects/CF Version/Base Components/For Viewing/Front Right Top CF6mm.stl

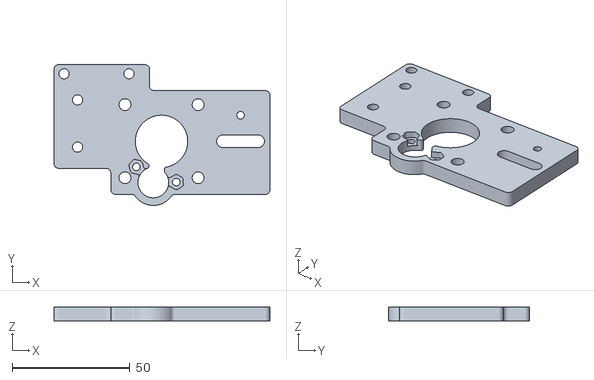
[picture p79: CAD file, 2026-10-22]
CF Version/Base Components/For Viewing/Front Right Top CF6mm.stl
91.6 x 59.7 x 6.00
