MASantangelo/SV08-Enhanced-Gantry-Projects/Metal Version/Base Components/Metal Printed Components.3mf

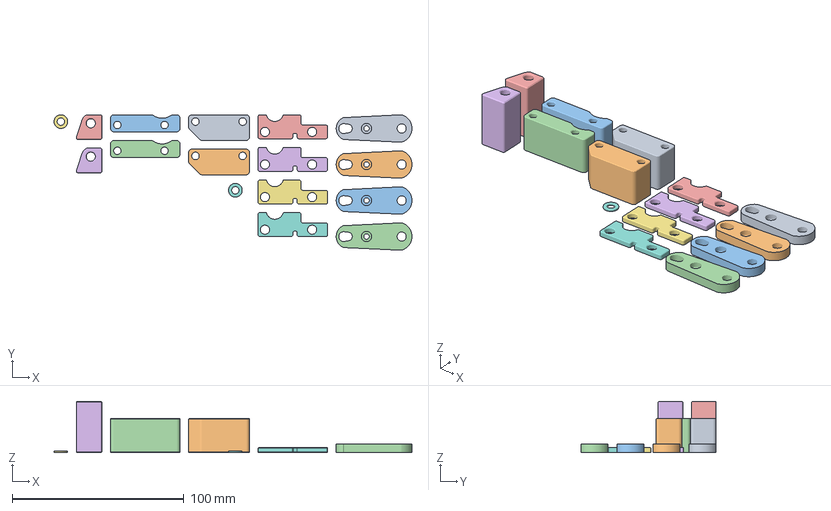
[picture p81: CAD file, 2026-10-22]
Metal Version/Base Components/Metal Printed Components.3mf
208.6 x 79.0 x 30.0 mm
Tensioner Lever Arm Revised - 5mm Metal Only.step x 4
4x Z Carriage Spacer - For Printing.step x 4
2x Back Spacer Plate 20mm - For Printing.step x 2
2x Front Spacer Plate 20mm - For Printing.step x 2
2x XY Live Idler Spacer - For Printing.step x 2
2x Printed Back Motor Spacer -For Printing.step x 2
