MASantangelo/SV08-Enhanced-Gantry-Projects/Printed Version/Base Components/Print Ready/For Viewing/Front Left Bottom Printed6mm - For Printing.stl

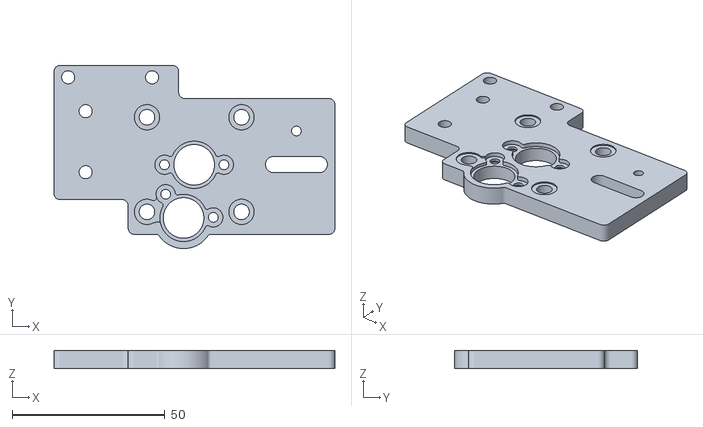
[picture p82: CAD file, 2026-10-22]
Printed Version/Base Components/Print Ready/For Viewing/Front Left Bottom Printed6mm - For Printing.stl
92.1 x 60.0 x 6.00
