MASantangelo/SV08-Enhanced-Gantry-Projects/Printed Version/Base Components/Print Ready/Printed Parts All.3mf

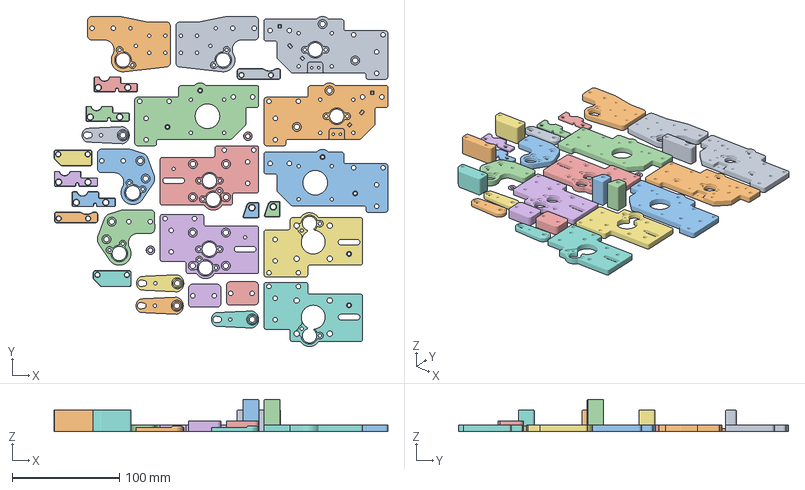
[picture p83: CAD file, 2026-10-22]
Printed Version/Base Components/Print Ready/Printed Parts All.3mf
312.1 x 308.5 x 30.0 mm
Back Right Top Plate Printed6mm - For Printing.step
Back Left Top Plate Printed6mm - For Printing.step
Back Left Bottom Plate Printed6mm - For Printing.step
Back Right Bottom Plate Printed6mm - For Printing.step
Front Right Bottom Printed6mm - For Printing.step
Front Left Bottom Printed6mm - For Printing.step
Front Right Top Printed6mm - For Printing.step
Front Left Top Printed6mm - For Printing.step
XY Live Idler Left Bottom Plate Printed6mm - For Printing.step
XY Live Idler Right Bottom Plate Printed6mm - For Printing.step
XY Live Idler Right Top Plate Printed6mm - For Printing.step
XY Live Idler Left Top Plate Printed6mm - For Printing.step
XY Live Idler Spacer 10mm Printed6mm - For Printing.step x 2
4x Tensioner Lever Arm Revised - For Printing.step x 4
4x Z Carriage Spacer - For Printing.step x 4
2x Back Spacer Plate 20mm - For Printing.step x 2
2x Front Spacer Plate 20mm - For Printing.step x 2
2x XY Live Idler Spacer - For Printing.step x 2
2x Printed Back Motor Spacer -For Printing.step x 2
