MASantangelo/SV08-Enhanced-Gantry-Projects/Shared Components/Print Ready/2x XY Live Idler Spacer - For Printing.step

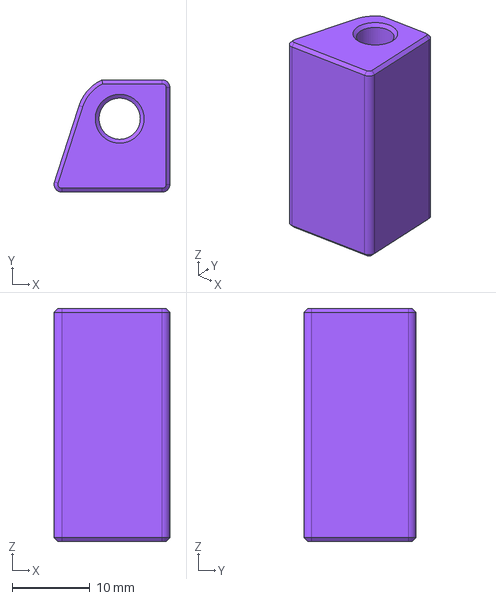
[picture p84: CAD file, 2026-10-11]
Shared Components/Print Ready/2x XY Live Idler Spacer - For Printing.step
14.9 x 14.5 x 30.0 mm
