MASantangelo/SV08-Enhanced-Gantry-Projects/Shared Components/Print Ready/4x Z Carriage Spacer - For Printing.step

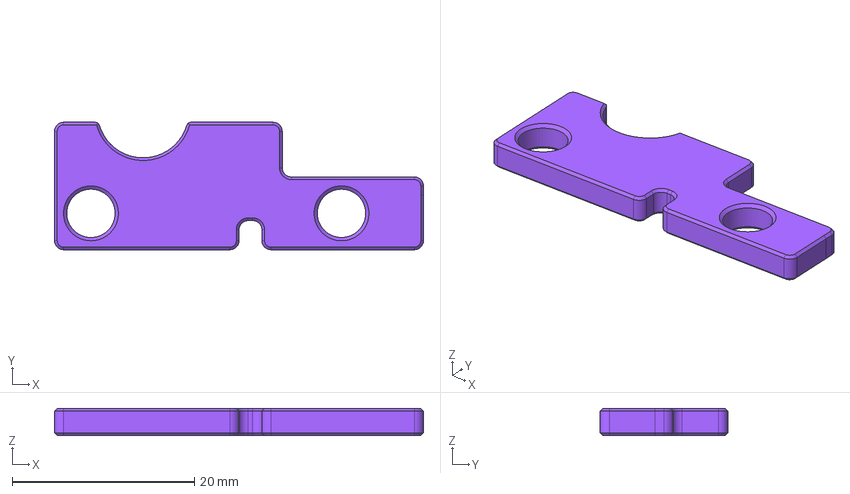
[picture p86: CAD file, 2026-10-11]
Shared Components/Print Ready/4x Z Carriage Spacer - For Printing.step
40.5 x 14.0 x 3.00 mm
