MASantangelo/SV08-Enhanced-Gantry-Projects/Shared Components/Print Ready/For Viewing/2x Front Spacer Plate 20mm - For Printing.stl

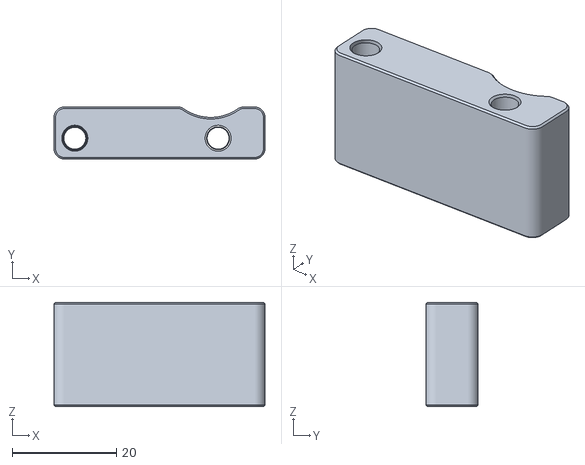
[picture p87: CAD file, 2026-10-11]
Shared Components/Print Ready/For Viewing/2x Front Spacer Plate 20mm - For Printing.stl
40.5 x 10.0 x 20.0
