MASantangelo/SV08-Enhanced-Gantry-Projects/Metal Version/Base Components/For Viewing/Front Right Bottom Metal5mm.stl

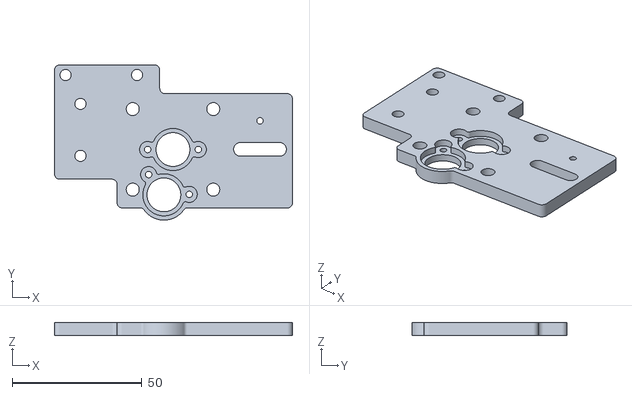
[picture p88: CAD file, 2026-10-22]
Metal Version/Base Components/For Viewing/Front Right Bottom Metal5mm.stl
91.6 x 59.7 x 5.00
