MASantangelo/SV08-Enhanced-Gantry-Projects/Metal Version/Base Components/XY Live Idler Spacer 5mm Metal5mm.step

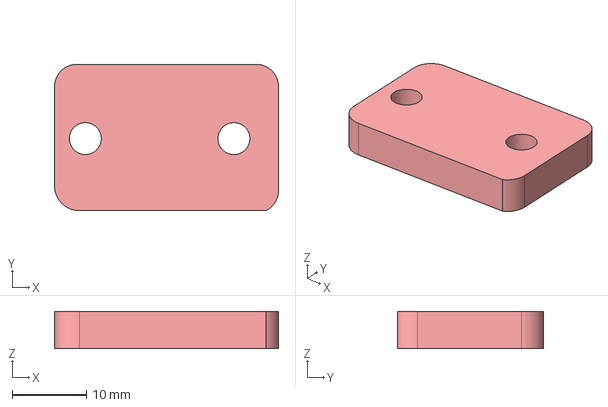
[picture p89: CAD file, 2026-10-22]
Metal Version/Base Components/XY Live Idler Spacer 5mm Metal5mm.step
30.1 x 19.7 x 5.00 mm
