MASantangelo/SV08-Enhanced-Gantry-Projects/Shared Components/Print Ready/2x Back Spacer Plate 20mm - For Printing.step

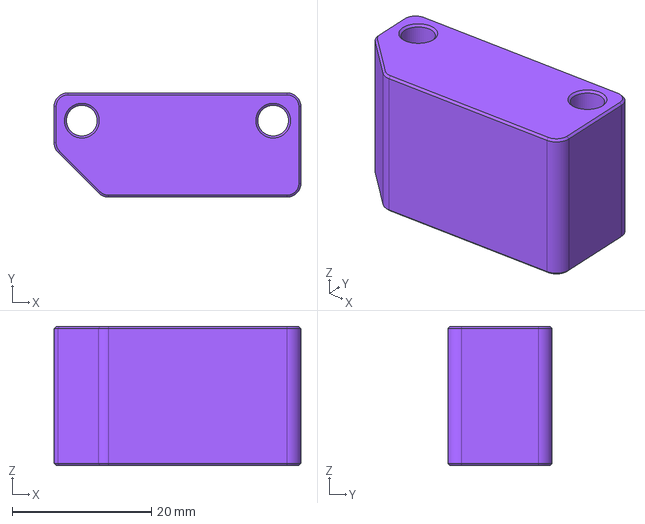
[picture p90: CAD file, 2026-10-11]
Shared Components/Print Ready/2x Back Spacer Plate 20mm - For Printing.step
35.5 x 15.0 x 20.0 mm
