MASantangelo/SV08-Enhanced-Gantry-Projects/Shared Components/Print Ready/2x Printed Back Motor Spacer -For Printing.step

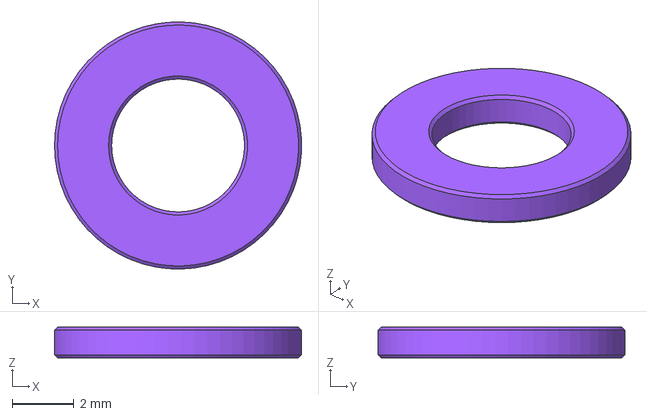
[picture p91: CAD file, 2026-10-11]
Shared Components/Print Ready/2x Printed Back Motor Spacer -For Printing.step
7.99 x 8.00 x 1.00 mm
