MASantangelo/SV08-Enhanced-Gantry-Projects/Printed Version/Base Components/Print Ready/For Viewing/XY Live Idler Spacer 10mm Printed6mm - For Printing.stl

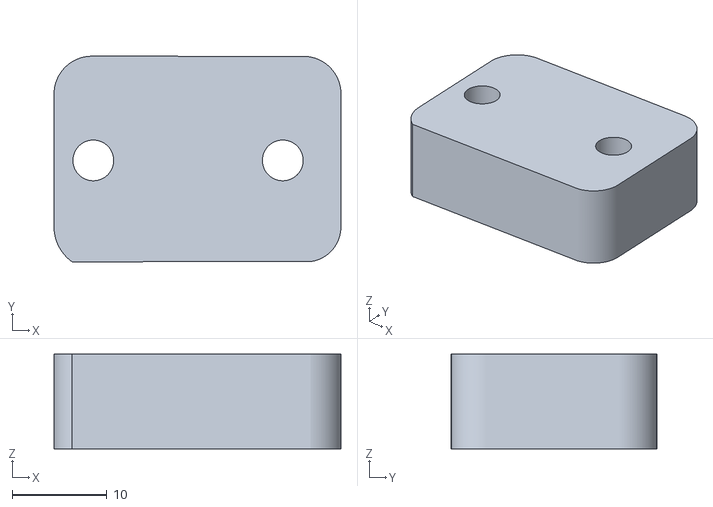
[picture p92: CAD file, 2026-10-21]
Printed Version/Base Components/Print Ready/For Viewing/XY Live Idler Spacer 10mm Printed6mm - For Printing.stl
30.3 x 21.7 x 10.0
