MASantangelo/SV08-Enhanced-Gantry-Projects/Metal Version/Base Components/For Viewing/Tensioner Lever Arm Revised - 5mm Metal Only.stl

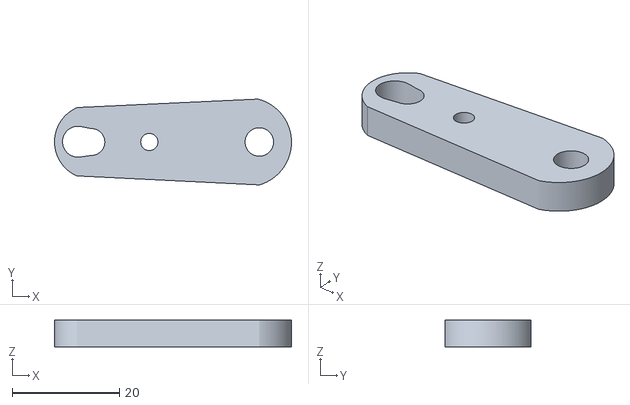
[picture p93: CAD file, 2026-10-14]
Metal Version/Base Components/For Viewing/Tensioner Lever Arm Revised - 5mm Metal Only.stl
44.2 x 16.0 x 5.00
