MASantangelo/SV08-Enhanced-Gantry-Projects/Printed Version/Base Components/Print Ready/For Viewing/Back Left Top Plate Printed6mm - For Printing.stl

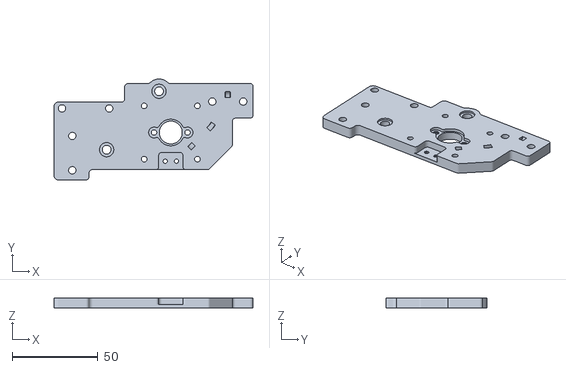
[picture p94: CAD file, 2026-10-17]
Printed Version/Base Components/Print Ready/For Viewing/Back Left Top Plate Printed6mm - For Printing.stl
115.9 x 58.8 x 6.00
