MASantangelo/SV08-Enhanced-Gantry-Projects/(list of files, cad)

Other CAD files:
CF Version/Base Assemblies/For Viewing/Back Left Motor Assembly CF6mm.stl
Printed Version/Base Assemblies/Front Left Motor Assembly Printed 6mm.step
CF Version/Base Assemblies/9mm Belt Mod/For Viewing/Back Left Motor Assembly CF6mm (For 9mm Belts).stl
CF Version/Base Assemblies/Back Left Motor Assembly CF6mm.step
CF Version/Base Assemblies/For Viewing/Back Right Motor Assembly CF6mm.stl
Metal Version/Base Assemblies/For Viewing/Front Right Motor Assembly Metal5mm.stl
Printed Version/Base Assemblies/Front Right Motor Assembly Printed 6mm.step
CF Version/Base Assemblies/9mm Belt Mod/For Viewing/Back Right Motor Assembly CF6mm (For 9mm Belts).stl
CF Version/Base Assemblies/9mm Belt Mod/Front Left Motor Assembly CF6mm (For 9mm Belts).step
CF Version/Base Assemblies/Front Right Motor Assembly CF6mm.step
Metal Version/Base Assemblies/For Viewing/Back Left Motor Assembly Metal5mm.stl
Printed Version/Base Assemblies/For Viewing/Back Left Motor Assembly Printed 6mm.stl
CF Version/Base Assemblies/9mm Belt Mod/Back Right Motor Assembly CF6mm (For 9mm Belts).step
CF Version/Base Assemblies/9mm Belt Mod/For Viewing/Front Right Motor Assembly CF6mm (For 9mm Belts).stl
CF Version/Base Assemblies/Front Left Motor Assembly CF6mm.step
Metal Version/Base Assemblies/Back Right Motor Assembly Metal5mm.step
Metal Version/Base Assemblies/For Viewing/Back Right Motor Assembly Metal5mm.stl
Printed Version/Base Assemblies/Back Left Motor Assembly Printed 6mm.step
Printed Version/Base Assemblies/For Viewing/Back Right Motor Assembly Printed 6mm.stl
CF Version/9mm Belt Mod/SV08-CF6 Dual Shear Live Idlers Front Tensioners (for 9mm Belts).step
CF Version/Base Assemblies/9mm Belt Mod/XY Joint Left CF6mm (For 9mm Belts).step
CF Version/Base Assemblies/XY Joint Right CF6mm.step
CF Version/Base Components/XY Live Idler Left Top Plate CF6mm.step
CF Version/SV08-CF6 Dual Shear Live Idlers Front Tensioners.step
Metal Version/Base Components/XY Live Idler Left Bottom Plate Metal5mm.step
Metal Version/SV08-M5 Dual Shear Live Idlers Front Tensioners.step
Printed Version/Base Assemblies/XY Joint Right Printed 6mm.step
Printed Version/SV08-P6 Dual Shear Live Idlers Front Tensioners.step
Shared Components/For Cutting/Tensioner Lever Arm Revised.step
Shared Components/Print Ready/For Viewing/2x Back Spacer Plate 30mm - For Printing.stl
CF Version/Base Assemblies/9mm Belt Mod/For Viewing/XY Joint Right CF6mm (For 9mm Belts).stl
CF Version/Base Assemblies/9mm Belt Mod/XY Joint Right CF6mm (For 9mm Belts).step
CF Version/Base Assemblies/For Viewing/XY Joint Right CF6mm.stl
CF Version/Base Assemblies/XY Joint Left CF6mm.step
CF Version/Base Components/9mm Belt Mod/For Viewing/Back Motor 5mm Spacer for Y Gantry.stl
CF Version/Base Components/XY Live Idler Left Bottom Plate CF6mm.step
Metal Version/Base Assemblies/For Viewing/XY Joint Left Metal5mm.stl
Metal Version/Base Assemblies/XY Joint Left Metal5mm.step
Metal Version/Base Components/XY Live Idler Right Top Plate Metal5mm.step
Printed Version/Base Assemblies/For Viewing/XY Joint Right Printed 6mm.stl
Printed Version/Base Assemblies/XY Joint Left Printed 6mm.step
Printed Version/Base Components/Print Ready/For Viewing/XY Live Idler Right Top Plate Printed6mm - For Printing.stl
Printed Version/Base Components/Print Ready/XY Live Idler Right Bottom Plate Printed6mm - For Printing.step
CF Version/Base Components/9mm Belt Mod/Back Motor 5mm Spacer for X Gantry.step
CF Version/Base Components/9mm Belt Mod/For Viewing/Front Motor 5mm Spacer for Y Gantry.stl
CF Version/Base Components/For Viewing/XY Live Idler Right Top Plate CF6mm.stl
CF Version/Base Components/XY Live Idler Right Bottom Plate CF6mm.step
Metal Version/Base Components/For Viewing/XY Live Idler Left Top Plate Metal5mm.stl
Metal Version/Base Components/XY Live Idler Left Top Plate Metal5mm.step
Printed Version/Base Components/Print Ready/For Viewing/XY Live Idler Left Bottom Plate Printed6mm - For Printing.stl
Printed Version/Base Components/Print Ready/XY Live Idler Left Top Plate Printed6mm - For Printing.step
Shared Components/Print Ready/2x XY Live Idler Spacer 35mm - For Printing.step
Shared Components/Print Ready/For Viewing/2x Front Spacer Plate 30mm - For Printing.stl
CF Version/Base Components/For Viewing/XY Live Idler Left Bottom Plate CF6mm.stl
CF Version/Base Components/XY Live Idler Right Top Plate CF6mm.step
Metal Version/Base Components/For Viewing/XY Live Idler Left Bottom Plate Metal5mm.stl
Metal Version/Base Components/XY Live Idler Right Bottom Plate Metal5mm.step
Printed Version/Base Components/Print Ready/For Viewing/XY Live Idler Left Top Plate Printed6mm - For Printing.stl
Printed Version/Base Components/Print Ready/XY Live Idler Left Bottom Plate Printed6mm - For Printing.step
Shared Components/Print Ready/4x Tensioner Lever Arm Revised - For Printing.step
Shared Components/Stock Parts/SV08 Stock Toolhead Extrusion.step
Shared Components/Print Ready/For Viewing/4x Tensioner Lever Arm Revised - For Printing.stl
Shared Components/Stock Parts/For Viewing/SV08 Stock Gantry X Extrusion.stl
CF Version/Base Components/For Viewing/Front Left Top CF6mm.stl
Metal Version/Base Components/For Viewing/Front Right Top Metal5mm.stl
Metal Version/Base Components/Front Right Top Metal5mm.step
Printed Version/Base Components/Print Ready/For Viewing/Front Right Bottom Printed6mm - For Printing.stl
Printed Version/Base Components/Print Ready/Front Right Bottom Printed6mm - For Printing.step
Shared Components/Stock Parts/SV08 Stock Gantry Y Extrusion.step
CF Version/Base Components/Back Right Top Plate CF6mm.step
CF Version/Base Components/For Viewing/Front Right Bottom CF6mm.stl
Printed Version/Base Components/Print Ready/For Viewing/Front Left Top Printed6mm - For Printing.stl
Printed Version/Base Components/Print Ready/Front Left Bottom Printed6mm - For Printing.step
Shared Components/Print Ready/For Viewing/2x XY Live Idler Spacer - For Printing.stl
CF Version/Base Components/Back Left Bottom Plate CF6mm.step
CF Version/Base Components/For Viewing/Back Right Bottom Plate CF6mm.stl
Metal Version/Base Components/For Viewing/XY Live Idler Spacer 5mm Metal5mm.stl
Metal Version/Base Components/Front Left Top Metal5mm.step
Printed Version/Base Components/Print Ready/For Viewing/Front Right Top Printed6mm - For Printing.stl
Printed Version/Base Components/Print Ready/Front Right Top Printed6mm - For Printing.step
Shared Components/Print Ready/For Viewing/2x Printed Back Motor Spacer -For Printing.stl
CF Version/Base Components/For Viewing/Front Left Bottom CF6mm.stl
CF Version/Base Components/Front Right Bottom CF6mm.step
Metal Version/Base Components/For Viewing/Front Left Bottom Metal5mm.stl
Metal Version/Base Components/Front Left Bottom Metal5mm.step
Printed Version/Base Components/Print Ready/Front Left Top Printed6mm - For Printing.step
Shared Components/Print Ready/2x Front Spacer Plate 20mm - For Printing.step
Shared Components/Print Ready/For Viewing/2x Back Spacer Plate 20mm - For Printing.stl
CF Version/Base Components/For Viewing/Back Right Top Plate CF6mm.stl
CF Version/Base Components/Front Left Top CF6mm.step
Metal Version/Base Components/Front Right Bottom Metal5mm.step
Printed Version/Base Components/Print Ready/XY Live Idler Spacer 10mm Printed6mm - For Printing.step
CF Version/Base Components/For Viewing/Back Left Top Plate CF6mm.stl
CF Version/Base Components/Front Right Top CF6mm.step
CF Version/Base Components/CF Printed Parts.3mf
CF Version/Base Components/For Viewing/Back Left Bottom Plate CF6mm.stl
CF Version/Base Components/For Viewing/XY Live Idler Spacer 5mm CF6mm.stl
CF Version/Base Components/Front Left Bottom CF6mm.step
CF Version/Base Components/XY Live Idler Spacer 5mm CF6mm.step
Metal Version/Base Components/Back Left Bottom Plate Metal5mm.step
Metal Version/Base Components/Back Left Top Plate Metal5mm.step
Metal Version/Base Components/Back Right Bottom Plate Metal5mm.step
Metal Version/Base Components/Back Right Top Plate Metal5mm.step
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
