MASantangelo/SV08-Enhanced-Gantry-Projects/Printed Version/README.md

# SV08-P6 Printed Gantry (6 mm)

The printed-plate variant: every gantry plate is 3D printed at 6 mm.

> [!NOTE]
> **This is the v2 printed design:** the plates, sub-assemblies, full gantry assembly, BOM, 3MF and renders. The original v1 files are in the [Printed v1 release](https://github.com/MASantangelo/SV08-Enhanced-Gantry-Projects/releases/tag/printed-v1).

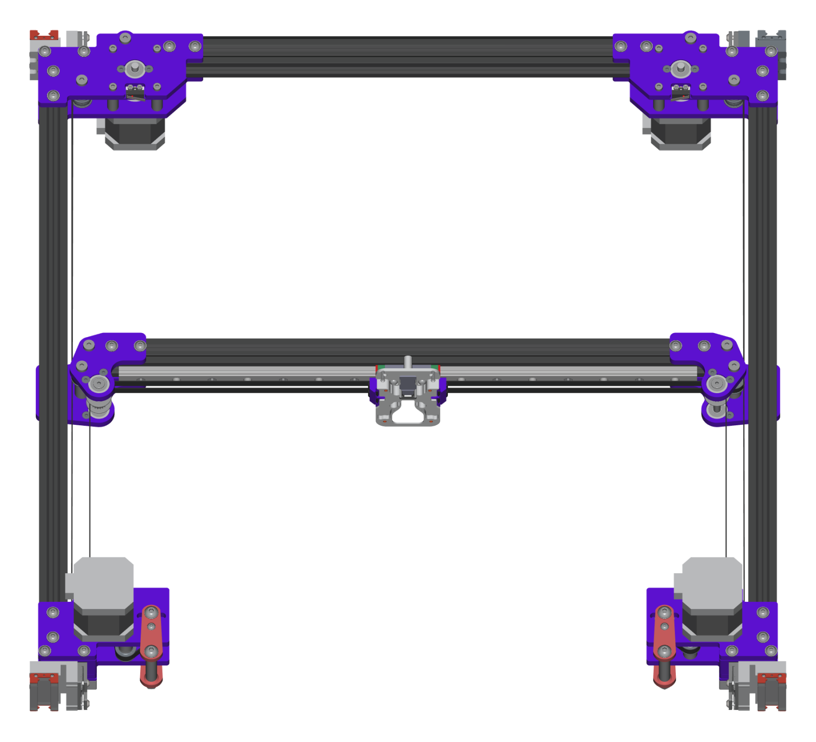
[picture p95: Printed Version/Renders/Full Gantry - Overview.png]
Full gantry overview, rendered from the current STEP file


## Folder structure

```text
Printed Version/
├── BOM.md                                   Bill of materials with purchase links
├── SV08_P6_Printed_BOM_from_STEP.xlsx       BOM spreadsheet (source for BOM.md)
├── SV08-P6 Dual Shear Live Idlers Front Tensioners.step   Full assembly
├── For Viewing/                             STL preview of the full assembly (~38 MB)
│
├── Base Assemblies/                         Each corner and joint as its own assembly
│   ├── Back Left / Back Right Motor Assembly
│   ├── Front Left / Front Right Motor Assembly
│   ├── XY Joint Left / Right
│   └── For Viewing/                         STL previews
│
├── Base Components/
│   └── Print Ready/                         ← Print these (plus ../Shared Components/Print Ready)
│       ├── *.step                           Printed plates, holes enlarged ~0.3 mm for printing
│       ├── Printed Parts All.3mf            Every printed part, shared ones included, on one plate (OrcaSlicer)
│       └── For Viewing/                     STL previews
│
├── Photos/                                  Photos of real builds
├── Renders/                                 Auto-generated from the STEP files (always current)
└── Screenshots/                             Fusion screenshots, belt paths, tensioner motion (GIF + MP4)
```

## Quick links

| I want to... | Go to |
|---|---|
| Buy the hardware | [BOM.md](BOM.md) |
| Install it | [Installation guide](../Docs/Installation.md) |
| Put the back motors on top | The CAD hangs them below; swap the back plates left for right to flip them ([Motor up or motor down](../Docs/Installation.md#motor-up-or-motor-down)) |
| Print the parts | The plates in [Base Components/Print Ready](Base%20Components/Print%20Ready) and the spacers and levers in [Shared Components/Print Ready](../Shared%20Components/Print%20Ready). Or print everything from the all-in-one [3MF plate](Base%20Components/Print%20Ready/Printed%20Parts%20All.3mf). |
| Look at the assembly in 3D | [Full assembly STL](For%20Viewing/SV08-P6%20Dual%20Shear%20Live%20Idlers%20Front%20Tensioners.stl) · [Sub-assemblies](Base%20Assemblies/For%20Viewing) |
| See the tensioner move | [Front Left Tensioner Motion.gif](Screenshots/Front%20Left%20Tensioner%20Motion.gif) |
| Browse all screenshots | [Screenshots](Screenshots) |

The print-ready plates have their holes enlarged by about 0.3 mm to allow for printing tolerances. The same files are used in the assemblies, so what you see in the CAD is exactly what you print.

## Build photos

The first v2 test build, printed with no supports.

**Fully assembled on an SV08**

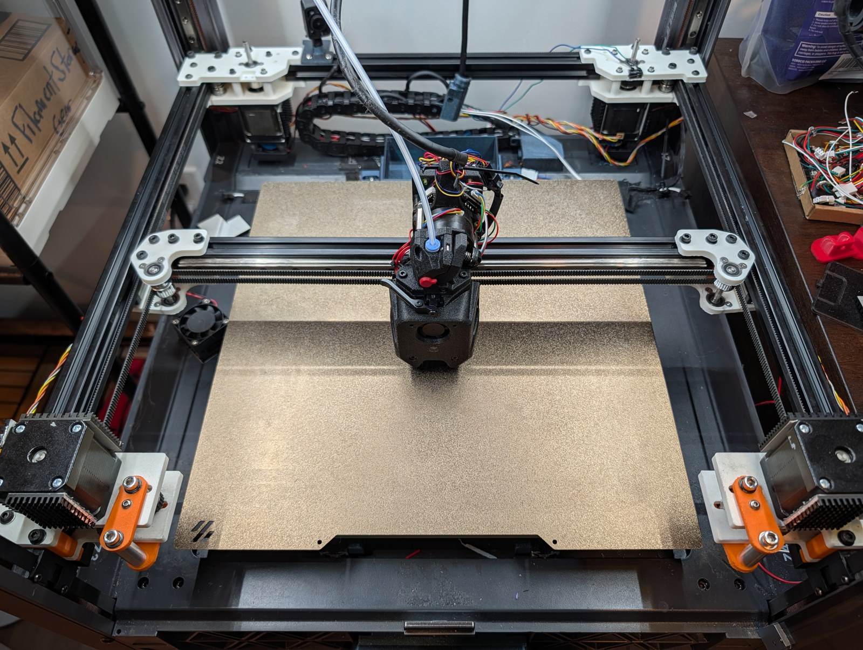
[picture p96: Printed Version/Photos/Full Gantry v2 - Top.jpg]
The full v2 printed gantry installed on an SV08, seen from above: all four motor corners, both XY joints and the orange tensioner lever arms at the front


| Front left corner and XY joint | XY joint (left) |
|---|---|
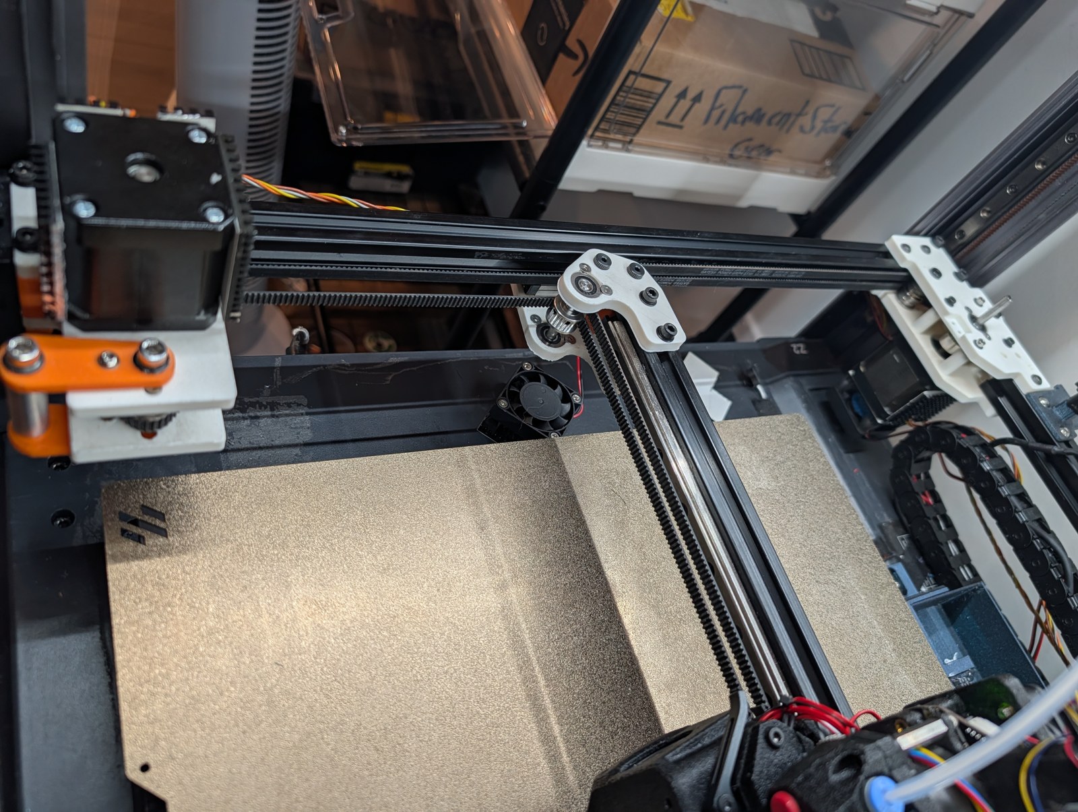
[picture p97: Printed Version/Photos/Full Gantry v2 - Front Left.jpg]
The front left motor corner with its orange tensioner lever, the left XY joint and the back left corner of the v2 printed gantry
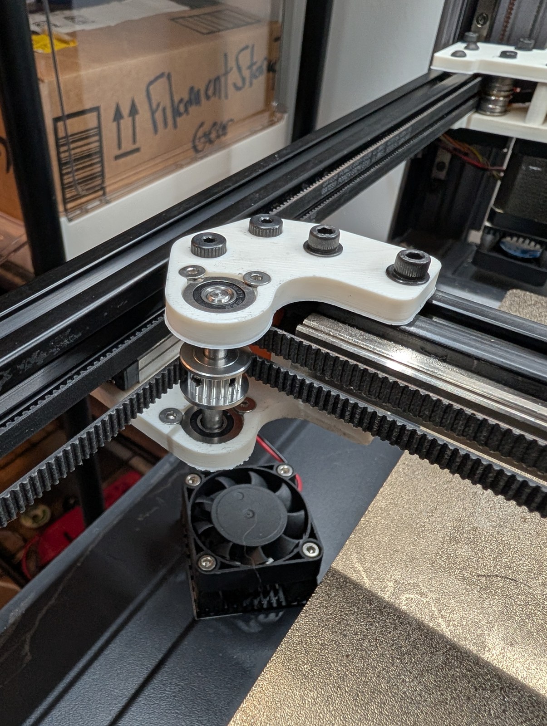
[picture p98: Printed Version/Photos/XY Joint Left v2 - Angle.jpg]
Close-up of the left XY joint v2: the live idler pulley on its shaft between the top and bottom bearing plates, with both belts running past
|  |  |

**Front left motor assembly** (before the motors were fitted)

| Side | Top | Angle |
|---|---|---|
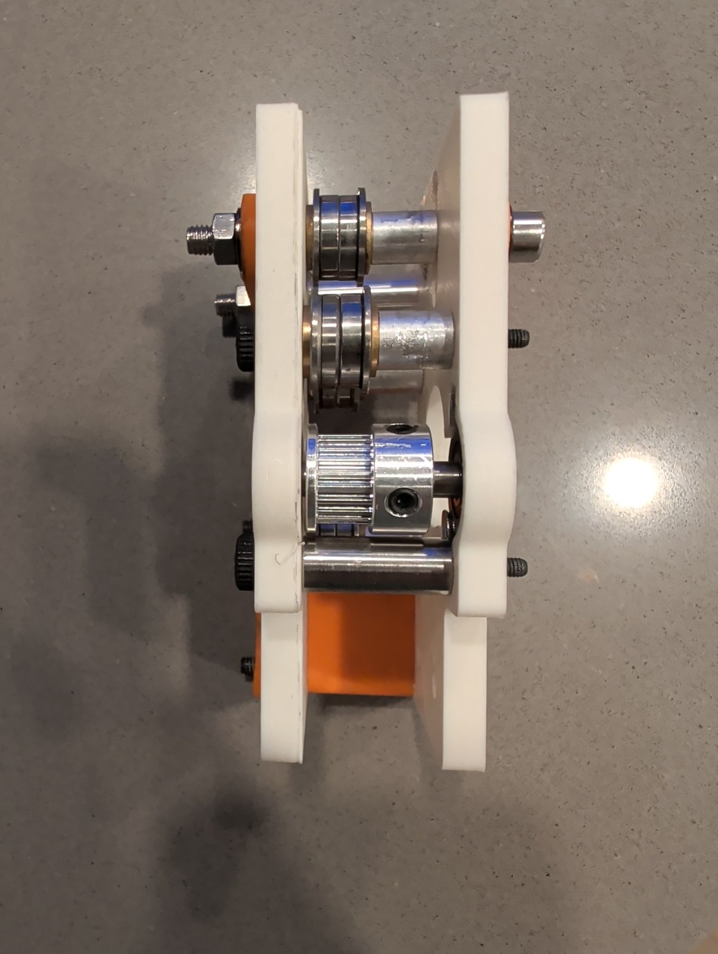
[picture p99: Printed Version/Photos/Front Left Motor Assembly v2 - Side.jpg]
Front left motor assembly v2, side view showing the bearing stacks and motor pulley between the plates
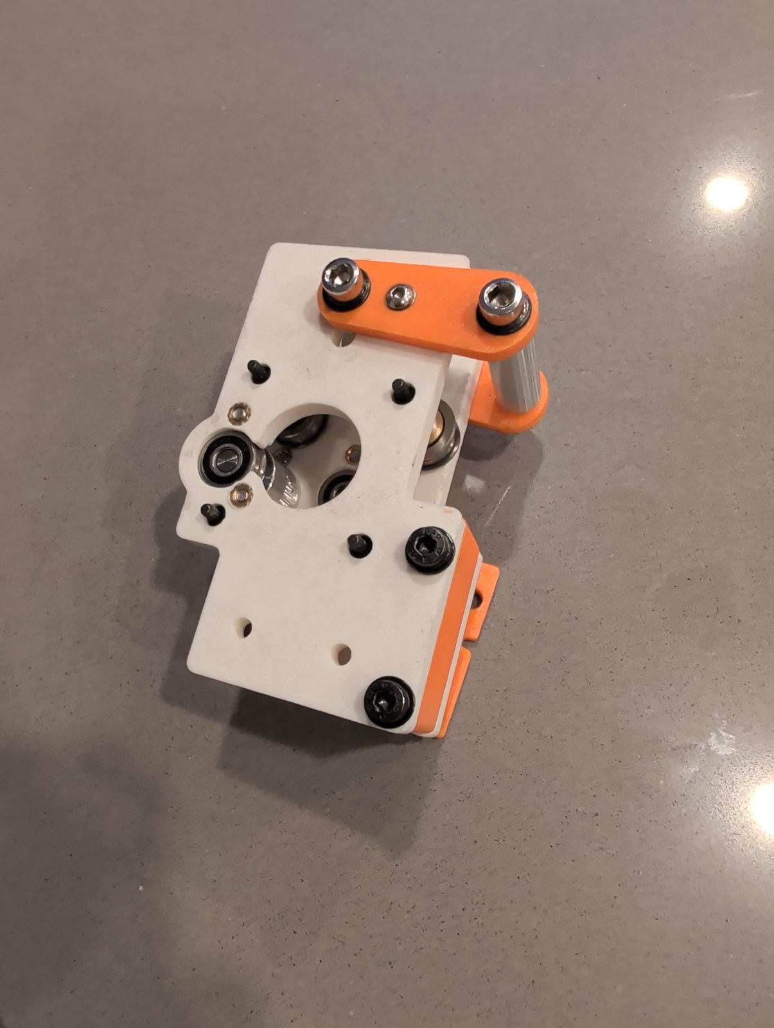
[picture p100: Printed Version/Photos/Front Left Motor Assembly v2 - Top.jpg]
Front left motor assembly v2 from the motor side, with the tensioner lever
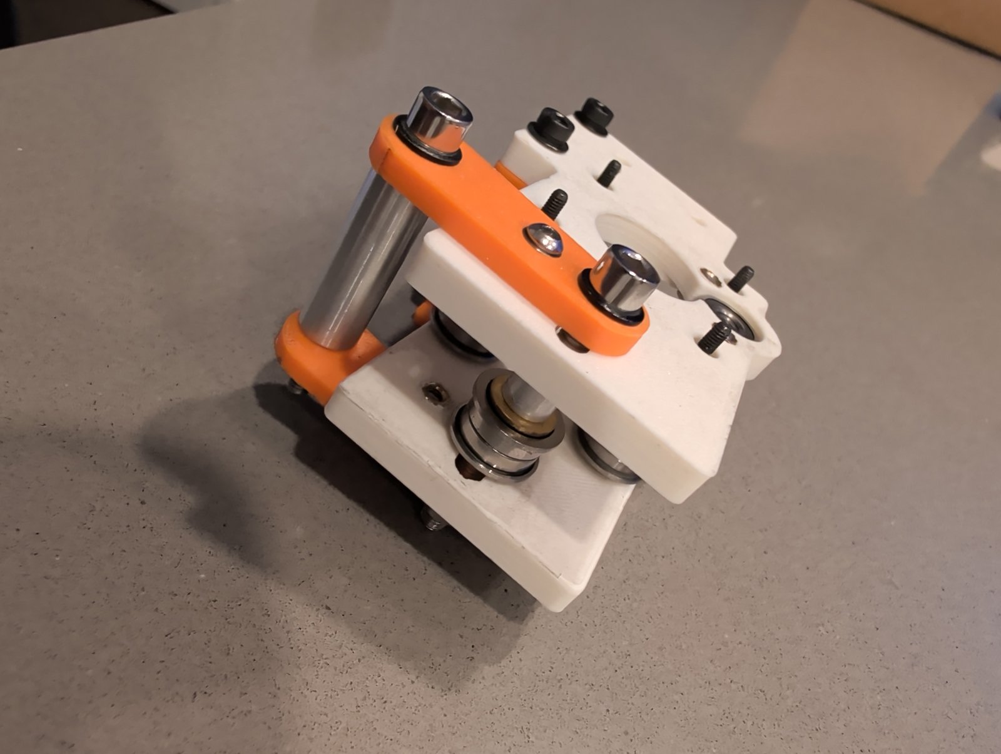
[picture p101: Printed Version/Photos/Front Left Motor Assembly v2 - Angle.jpg]
Front left motor assembly v2 at an angle, showing the tensioner lever arm and idler
|  |  |  |

**Back left motor assembly** (here with printed motor standoffs and the printed back spacer plate, in orange)

| Side | End |
|---|---|
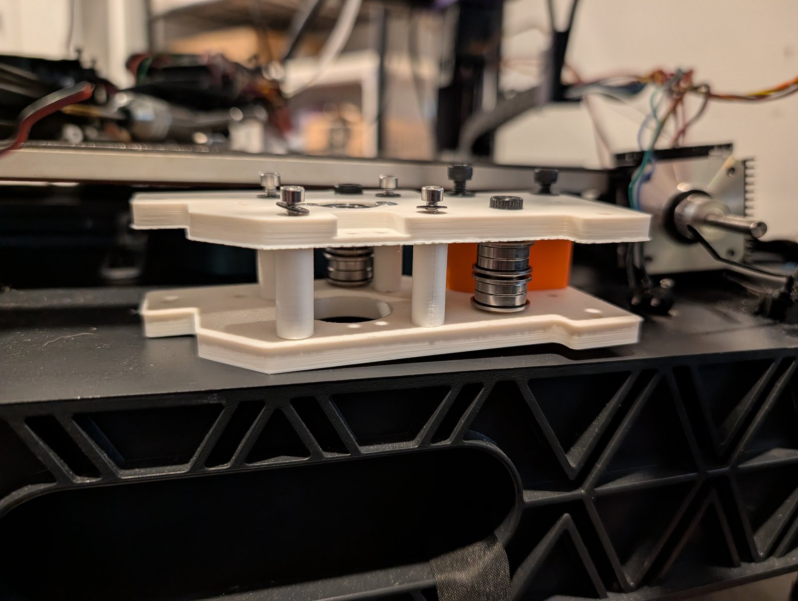
[picture p102: Printed Version/Photos/Back Left Motor Assembly v2 - Side.jpg]
Back left motor assembly v2 from the side, showing the standoffs and the bearing stack between the plates
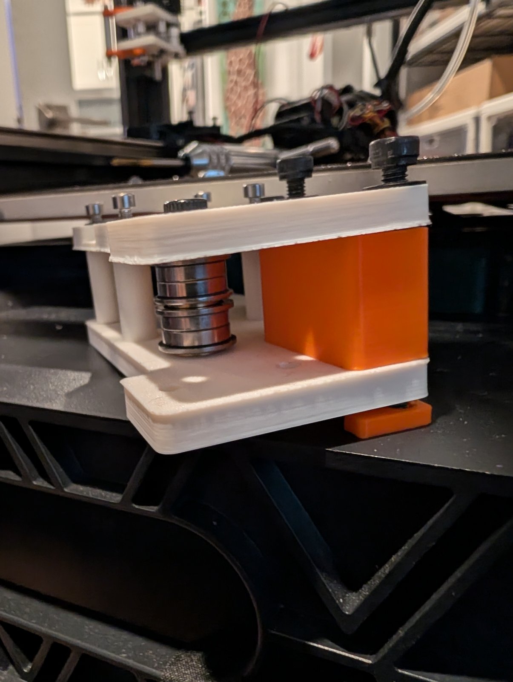
[picture p103: Printed Version/Photos/Back Left Motor Assembly v2 - End.jpg]
Back left motor assembly v2 from the end, showing the bearing stack and the orange back spacer plate
|  |  |

## Installing the heat-set inserts

The M3 heat-set inserts go in from the bed side of each plate. Several sit close to a bearing bore, so take them one at a time:

1. **Press the bearings in first.** With the bearing already seated, it backs up the thin wall between the insert and the bore, so the softened plastic can't bulge into the bore.
2. **Start the insert straight with a screw.** Thread an M3 screw into the insert from the other side of the plate, through the screw hole, and pull the insert's leading edge into its seat. That lines it up before you heat it, so it goes in square. Don't skip this: an insert that goes in crooked will cross-thread its screw, and a screw stuck in a crooked insert usually can't be removed without ruining the plate.
3. **No bearing in that seat yet? Push the plastic back.** Without a bearing to back it up, the wall flexes inward as the insert goes in. While it's still warm, push it back into place with a spudger so the bore stays round.
4. **Set it flush or slightly deep, never proud.** It's fine for the insert to sink a little below the surface, but one left sticking out holds the next part off the plate, so the joint won't sit flat or clamp properly.
5. **Trim any plastic pushed up around the insert.** Pay attention to the screw path and the edges. A raised lip looks untidy, and plastic in the screw path can make the screw cross-thread.
6. **Chase the threads before assembly, from the opposite side.** Once the insert has cooled, run an M3 screw through it from the side the real screw *doesn't* come in from, all the way through. That pushes any melted plastic out of the side where the assembly screw enters. Going in from the screw's side would just push the plastic deeper into the threads.

## Renders

Generated automatically from the current STEP files whenever the repo is refreshed (see [tools](../tools)), so they always show the latest design.

| | |
|---|---|
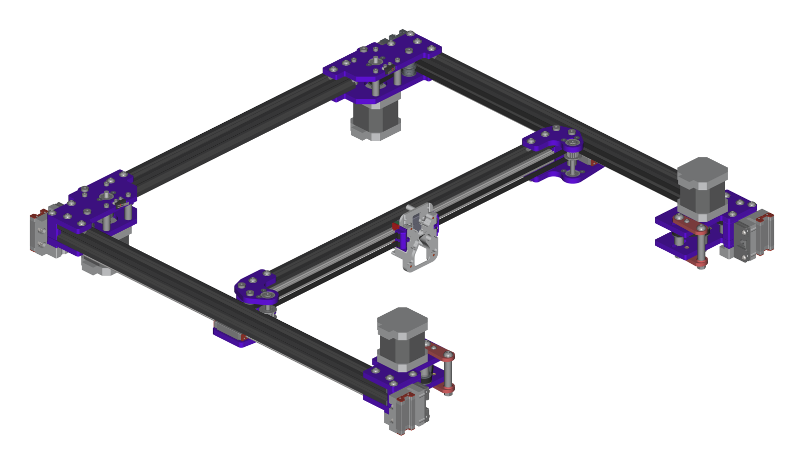
[picture p104: Printed Version/Renders/Full Gantry - Front Left.png]
Full gantry, front left
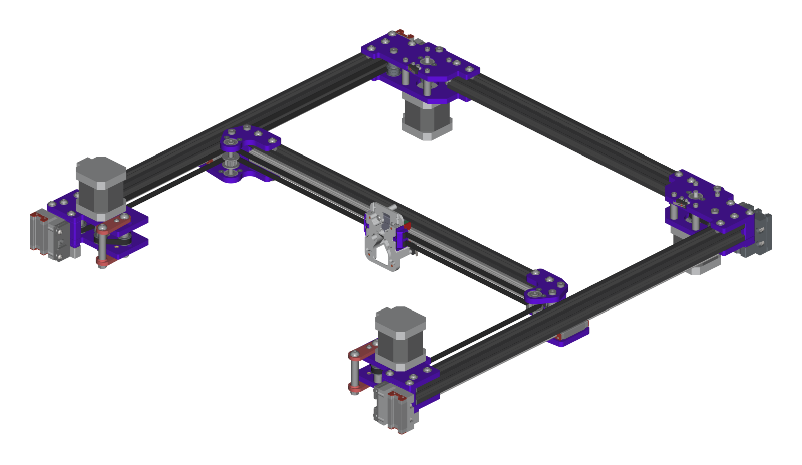
[picture p105: Printed Version/Renders/Full Gantry - Front Right.png]
Full gantry, front right
|  |  |
| Front left | Front right |
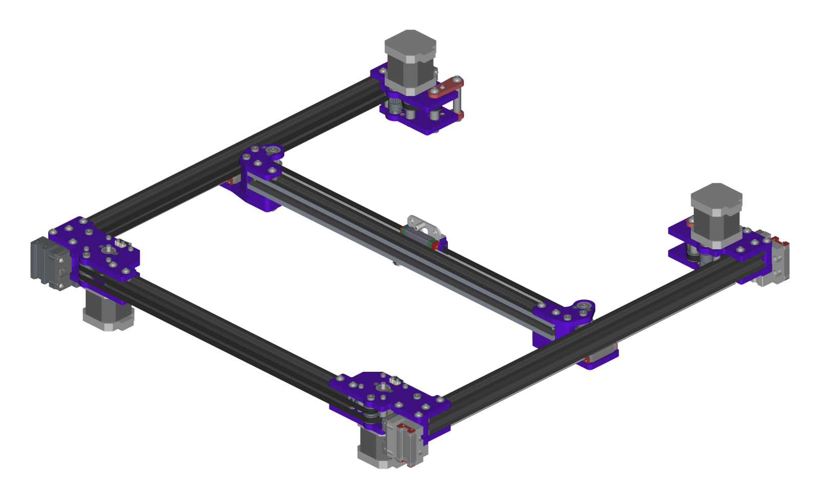
[picture p106: Printed Version/Renders/Full Gantry - Rear Left.png]
Full gantry, rear left
|  | Full gantry, overview |
| Rear left | Overview |

### Sub-assemblies

| | | |
|---|---|---|
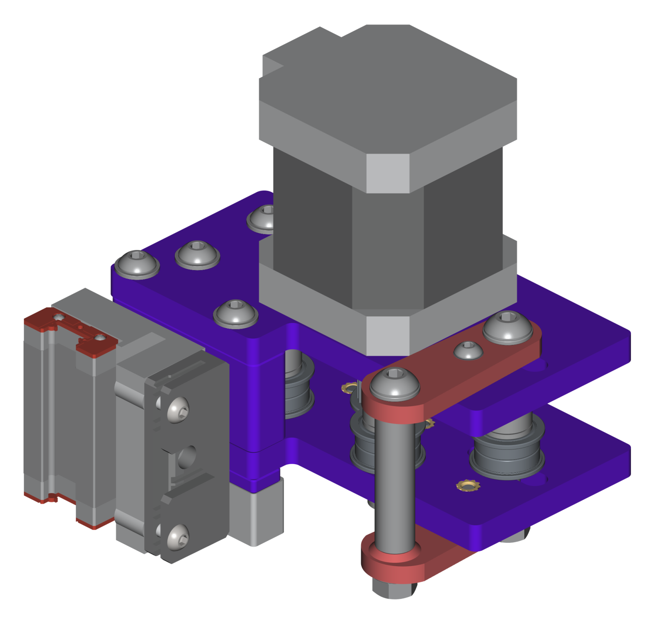
[picture p107: Printed Version/Renders/Front Left Motor Assembly Printed 6mm - Iso.png]
Front left motor assembly
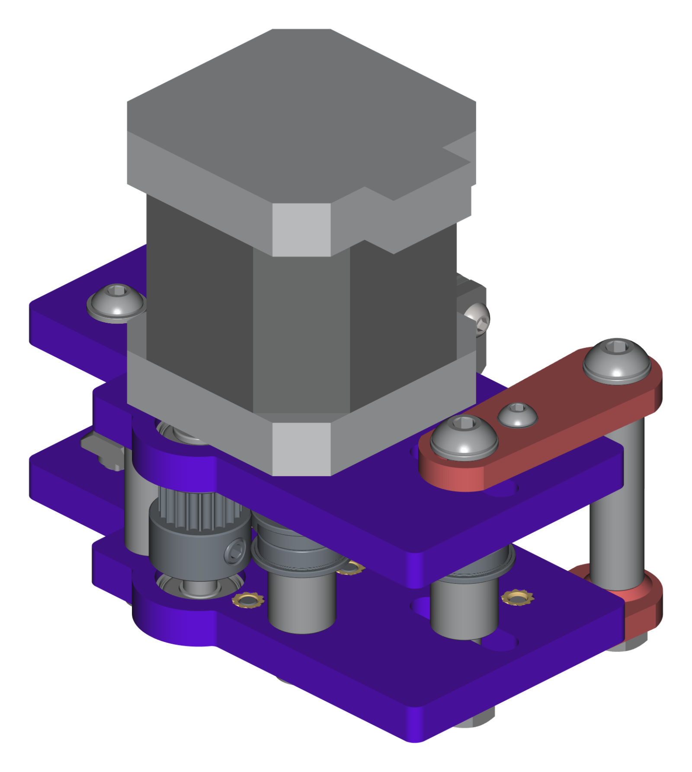
[picture p108: Printed Version/Renders/Front Right Motor Assembly Printed 6mm - Iso.png]
Front right motor assembly
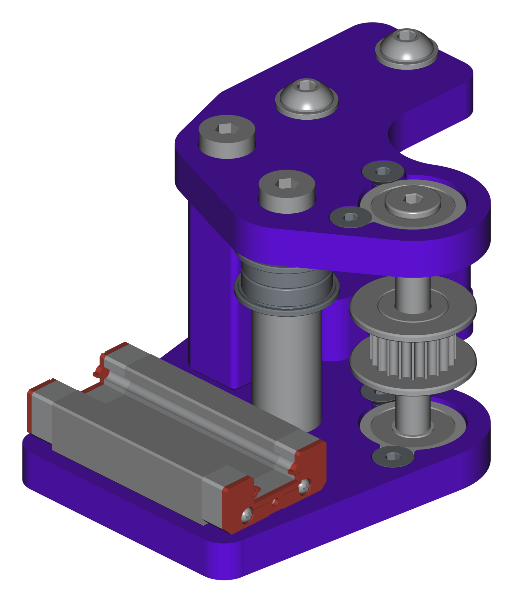
[picture p109: Printed Version/Renders/XY Joint Left Printed 6mm - Iso.png]
XY joint left
|  |  |  |
| Front left motor | Front right motor | XY joint left |
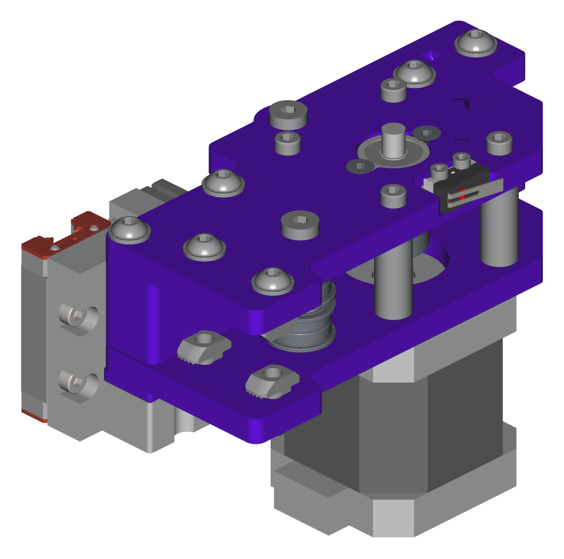
[picture p110: Printed Version/Renders/Back Left Motor Assembly Printed 6mm - Iso.png]
Back left motor assembly
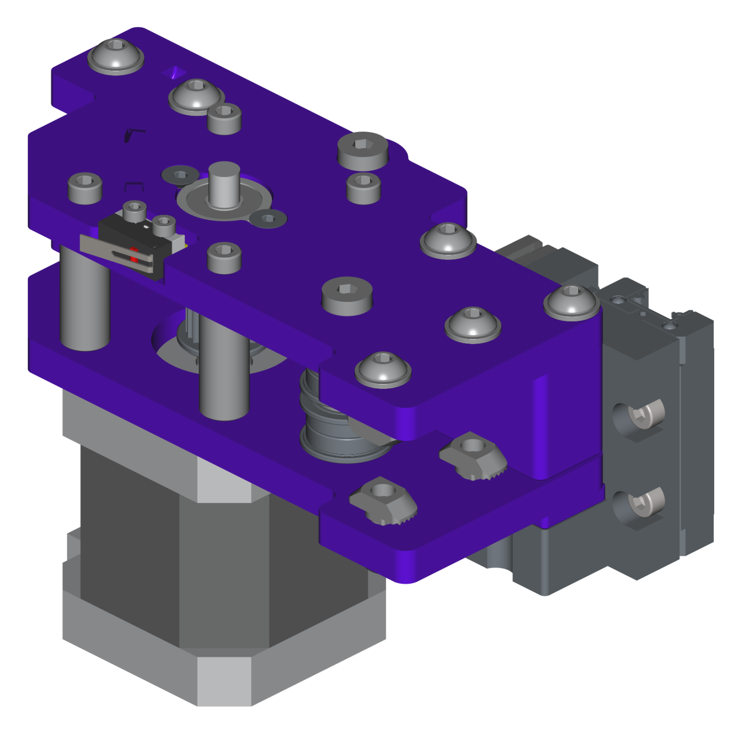
[picture p111: Printed Version/Renders/Back Right Motor Assembly Printed 6mm - Iso.png]
Back right motor assembly
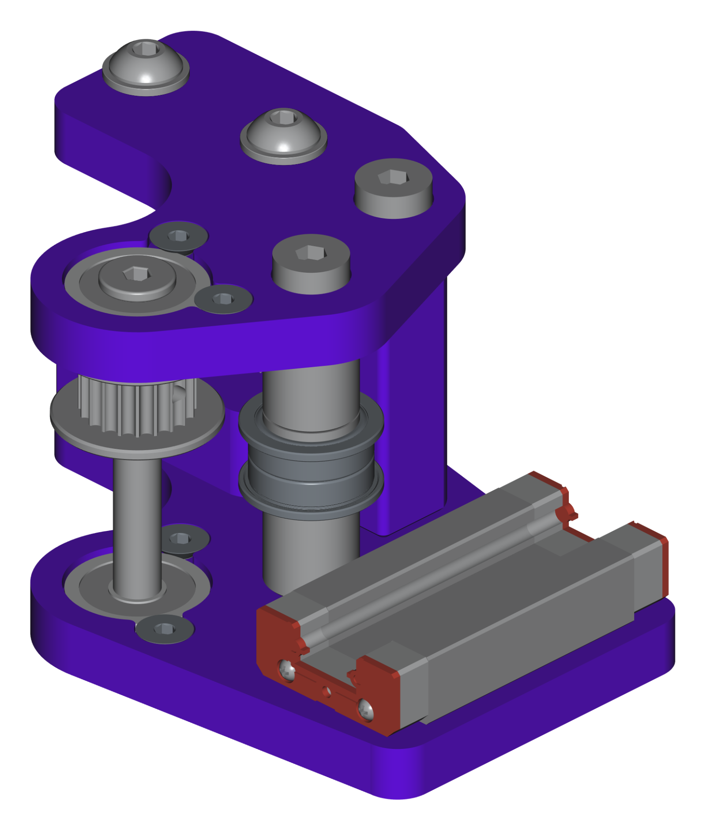
[picture p112: Printed Version/Renders/XY Joint Right Printed 6mm - Iso.png]
XY joint right
|  |  |  |
| Back left motor | Back right motor | XY joint right |
