MASantangelo/SV08-Enhanced-Gantry-Projects/Printed Version/Screenshots/Back Left Motor Plate Assembly - No Belts.png

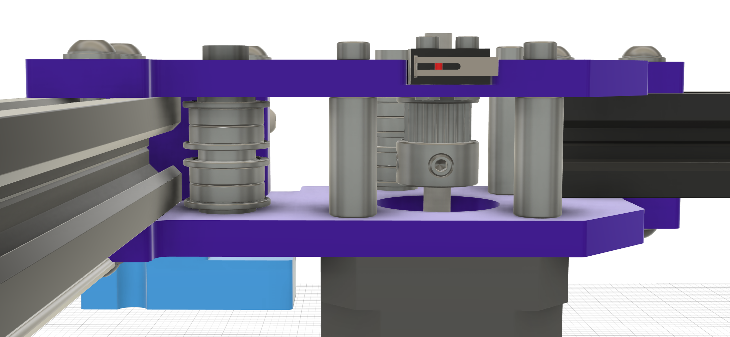
Printed Version/Screenshots/Back Left Motor Plate Assembly - No Belts.png
