MASantangelo/SV08-Enhanced-Gantry-Projects/Printed Version/Screenshots/Bottom Belt Path.png

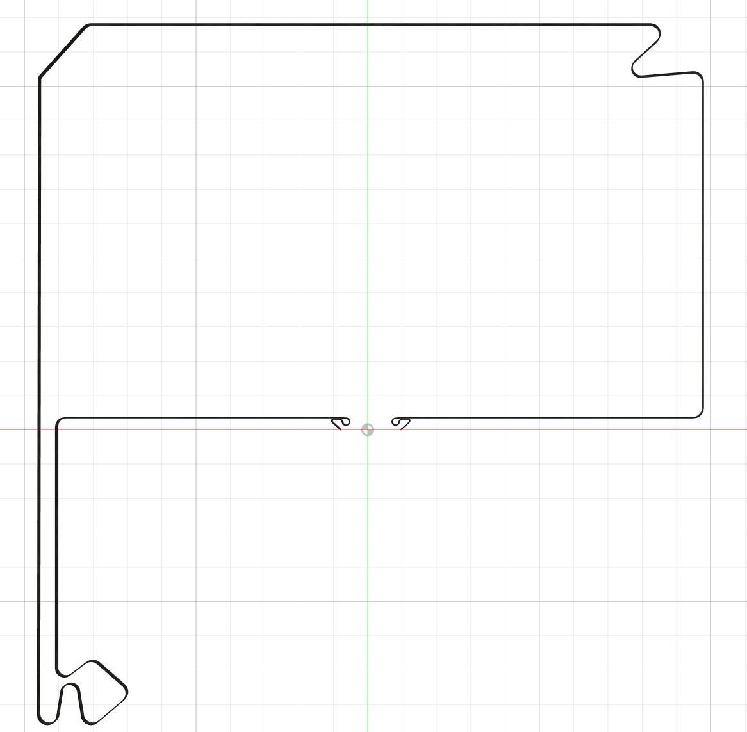
Printed Version/Screenshots/Bottom Belt Path.png
