MASantangelo/SV08-Enhanced-Gantry-Projects/Printed Version/Screenshots/Front Left Motor Plate Assembly - No Belts.png

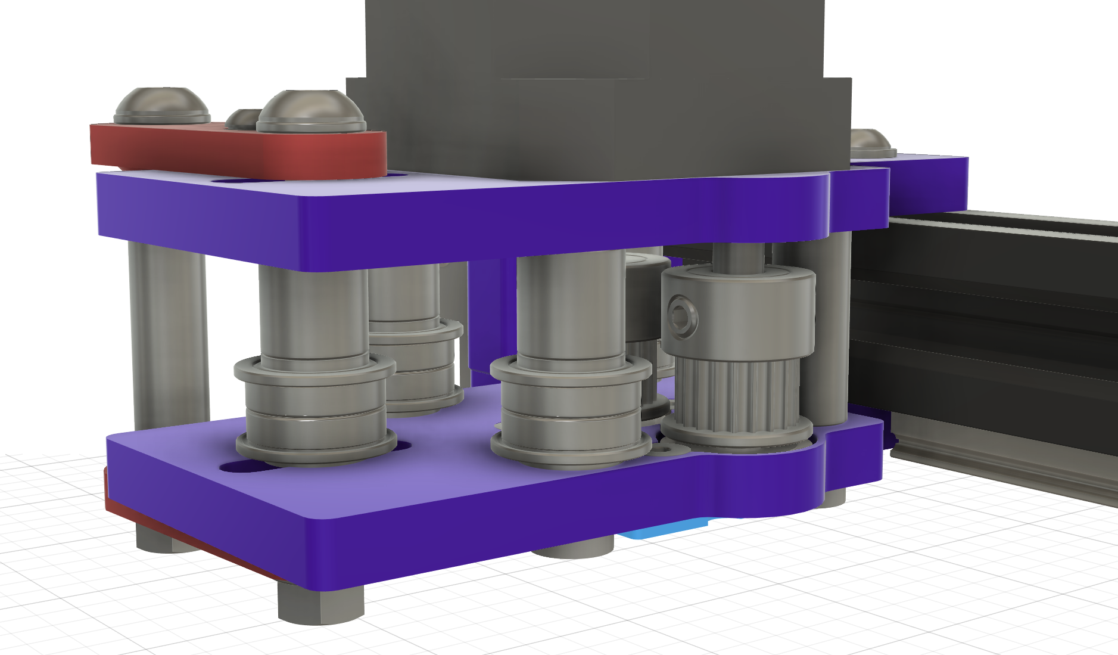
Printed Version/Screenshots/Front Left Motor Plate Assembly - No Belts.png
