MASantangelo/SV08-Enhanced-Gantry-Projects/Printed Version/Screenshots/Full Assembled Gantry Overview.png

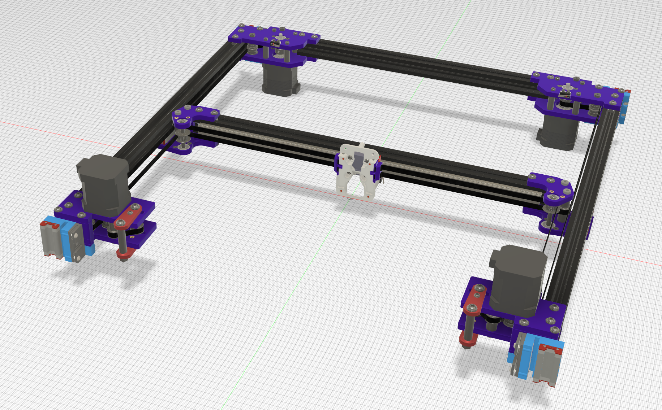
Printed Version/Screenshots/Full Assembled Gantry Overview.png
