MASantangelo/SV08-Enhanced-Gantry-Projects/Printed Version/Screenshots/Top Belt Path.png

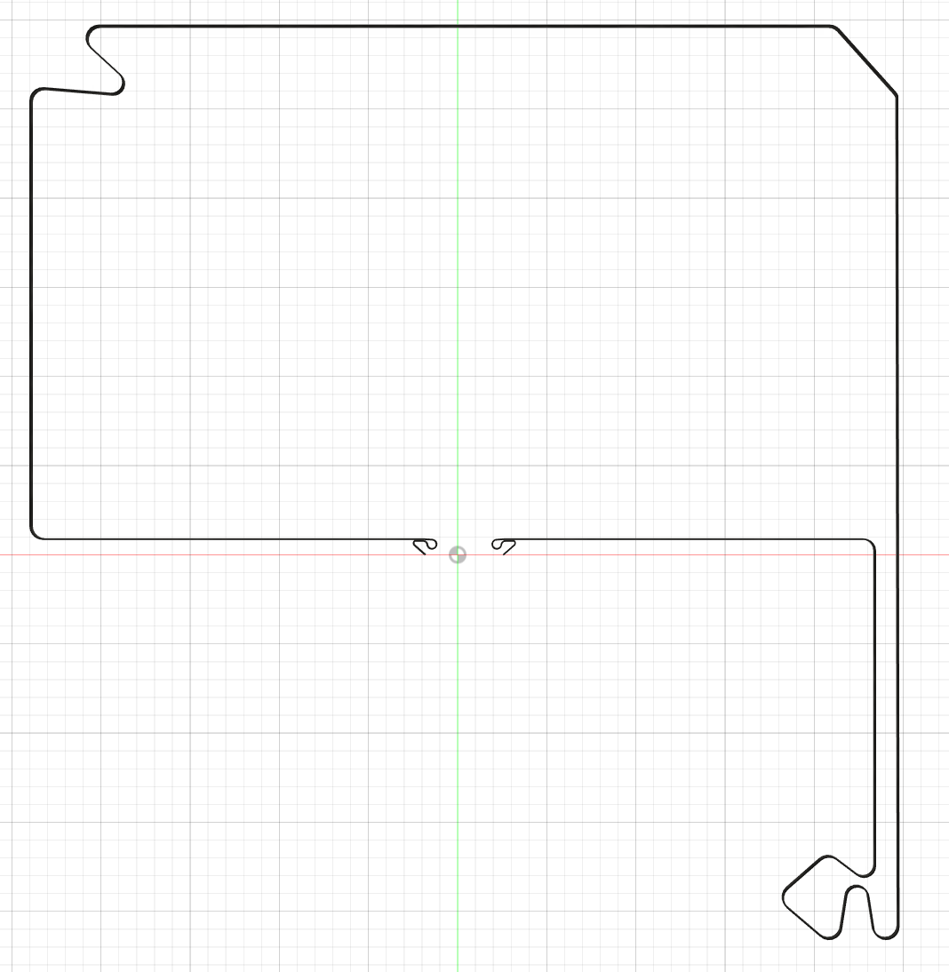
Printed Version/Screenshots/Top Belt Path.png
