MASantangelo/SV08-Enhanced-Gantry-Projects/Printed Version/Screenshots/XY Left Assembly - No Belts.png

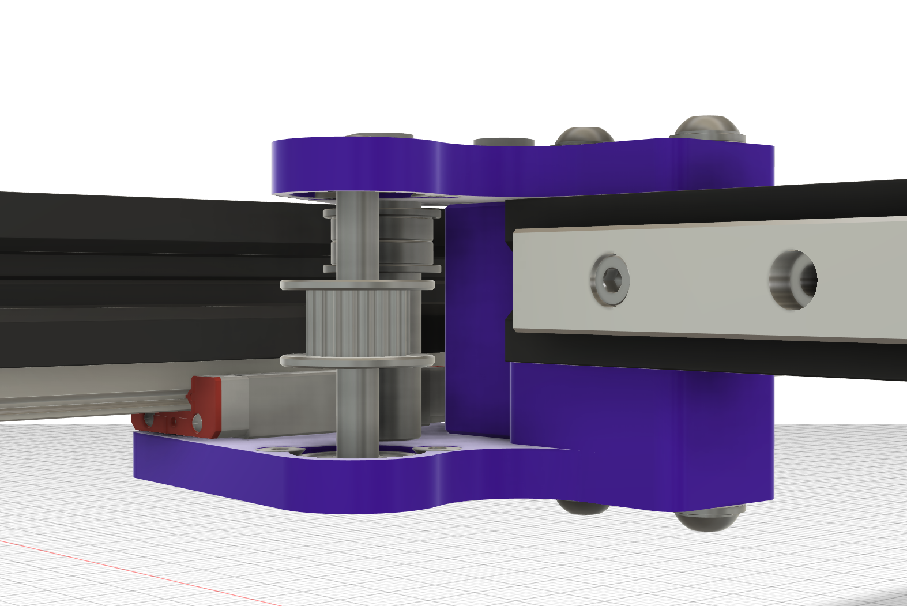
Printed Version/Screenshots/XY Left Assembly - No Belts.png
