MASantangelo/SV08-Enhanced-Gantry-Projects/(commit log)

2026-10-11 Add printed 6mm gantry version
    Initial upload of the SV08 AWD dual-shear live idlers / front tensioners
    printed-gantry variant: full assembly STEP, print-ready and mockup plates,
    BOMs, README and CC BY-NC-SA 4.0 license.
    [2x Back Spacer Plate 20mm - For Printing.step, 2x Front Spacer Plate 20mm - For Printing.step, 2x Printed Back Motor Spacer -For Printing.step, 2x XY Live Idler Spacer - For Printing.step, 4x Z Carriage Spacer - For Printing.step, Back Left Bottom Plate Printed6mm - For Printing.step, Back Left Bottom Plate Printed6mm.step, Back Left Top Plate Printed6mm - For Printing.step]
2026-10-11 Add tensioner lever arm and STL previews of print-ready parts
    - New part: 4x Tensioner Lever Arm Revised (STEP)
    - Print Ready/For Viewing: STL copies of all print-ready STEP files so
    they render in GitHub's 3D viewer
    [2x Back Spacer Plate 20mm - For Printing.stl, 2x Front Spacer Plate 20mm - For Printing.stl, 2x Printed Back Motor Spacer -For Printing.stl, 2x XY Live Idler Spacer - For Printing.stl, 4x Tensioner Lever Arm Revised - For Printing.step, 4x Tensioner Lever Arm Revised - For Printing.stl, 4x Z Carriage Spacer - For Printing.stl, Back Left Bottom Plate Printed6mm - For Printing.stl]
2026-10-11 Add STL previews of mockup parts
    For Mockups Only/For Viewing: STL copies of all mockup STEP files so
    they render in GitHub's 3D viewer.
    [Back Left Bottom Plate Printed6mm.stl, Back Left Top Plate Printed6mm.stl, Back Right Bottom Plate Printed6mm.stl, Back Right Top Plate Printed6mm.stl, Front Left Bottom Printed6mm.stl, Front Left Top Printed6mm.stl, Front Right Bottom Printed6mm.stl, Front Right Top Printed6mm.stl]
2026-10-11 Add STL preview of full printed assembly
    Printed Version/For Viewing: size-aware tessellation (coarse for hardware
    under 25mm, fine for plates and large parts) to keep the 1092-solid
    assembly at ~38MB for GitHub's 3D viewer.
    [SV08-P6 Dual Shear Live Idlers Front Tensioners.stl]
2026-10-11 Rotate main assembly, add base assemblies and screenshots
    - Main P6 assembly STEP rotated 180 deg; STL preview regenerated
    - Base Assemblies: 4 corner motor assemblies + 2 XY joints, with STL
    previews in Base Assemblies/For Viewing
    - Screenshots: renders, belt paths, tensioner motion GIF/MP4
    - README features the gantry overview and tensioner motion GIF
    [Back Left Motor Assembly Printed 6mm.step, Back Left Motor Assembly Printed 6mm.stl, Back Right Motor Assembly Printed 6mm.step, Back Right Motor Assembly Printed 6mm.stl, Front Left Motor Assembly Printed 6mm.step, Front Left Motor Assembly Printed 6mm.stl, Front Right Motor Assembly Printed 6mm.step, Front Right Motor Assembly Printed 6mm.stl]
2026-10-11 Add all-parts 3MF plate for the printed version
    [Printed Parts All.3mf]
2026-10-12 Add purchase links to BOM and a browsable BOM.md
    - BOM xlsx now includes purchase links (clean Amazon/AliExpress URLs)
    - Printed Version/BOM.md: sectioned tables with clickable buy links and
    printed parts linked to their STL previews
    - README links to the BOM
    [SV08_P6_Printed_BOM_from_STEP.xlsx]
2026-10-12 Rename X-axis extrusion to its actual 342mm length in main assembly
    [SV08-P6 Dual Shear Live Idlers Front Tensioners.step]
2026-10-12 BOM fixes: 342mm X extrusion, MGN9H typo, Front Left plate names
    Spreadsheet corrections; BOM.md regenerated from it.
    [SV08_P6_Printed_BOM_from_STEP.xlsx]
2026-10-12 Add tools for regenerating STL previews and BOM.md
    - tools/update-previews.ps1: one command per variant that rebuilds all
    For Viewing STLs and BOM.md
    - step2stl.py: fine meshing for single parts, size-aware for assemblies
    - make_bom_md.py + read_xlsx.py: spreadsheet -> BOM.md (stdlib only)
    - Verified: rerunning on Printed Version reproduces every committed STL
    and BOM.md byte-for-byte
2026-10-12 Add Printed Version README with gantry overview and folder map
2026-10-12 Rename Fusion BOM export CSV from CF6 to P6
    [SV08-P6_Dual_Shear_Live_Idlers_Front_Tensioners_9_34_PM_Oct_11_2026_FusionBOMExport.csv]
2026-10-12 Drop Fusion CSV BOM export; add CF and Metal WIP folders
    - Remove the Fusion CSV export (inaccurate vs the STEP-derived xlsx)
    - CF Version/ and Metal Version/ placeholders with WIP READMEs
    - Main README variant table links to the new folders
    [SV08-P6_Dual_Shear_Live_Idlers_Front_Tensioners_9_34_PM_Oct_11_2026_FusionBOMExport.csv]
2026-10-12 Credit Stanciu-Andrei's original SV08 AWD Mod on the landing page
2026-10-12 Clarify that the original XY joints used non-live idlers
2026-10-13 Add step_bom.py: check/update the BOM spreadsheet against the STEP
    Reads part names and usage counts from the assembly STEP (PRODUCT +
    NEXT_ASSEMBLY_USAGE_OCCURRENCE), multiplies through sub-assemblies, maps CAD
    names to BOM lines via tools/bom_rules.json, and compares with the xlsx.
    'check' reports differences and exits non-zero; 'update' writes quantities
    and rebuilds BOM.md. Passes against the committed P6 assembly and BOM.
2026-10-13 Printed: threaded-spacer front idlers, ultra-thin flat heads, re-exports
    Design changes (from the new main STEP):
    - Front motor assemblies: M5x30 dowel replaced by an M3 internally
    threaded spacer (5mm OD, 25mm) held by 2x M3x10 ultra-thin flat heads
    - XY joints: 2x M3x10 BHCS + 2x M3 washers per joint replaced by
    2x M3x10 ultra-thin flat heads
    - X extrusion component name corrected to 342mm; MGN9H naming fixed
    BOM: new rows for the ultra-thin flat heads and 25mm spacer (clean links),
    M5 dowel row removed, BHCS 16->12 and M3 washers 12->8 via step_bom update.
    step_bom check passes. Re-exported base components, base assemblies and the
    all-parts 3MF; all STL previews and BOM.md regenerate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
    [Back Left Bottom Plate Printed6mm - For Printing.step, Back Left Bottom Plate Printed6mm.step, Back Left Motor Assembly Printed 6mm.step, Back Left Motor Assembly Printed 6mm.stl, Back Left Top Plate Printed6mm - For Printing.step, Back Left Top Plate Printed6mm.step, Back Right Bottom Plate Printed6mm - For Printing.step, Back Right Bottom Plate Printed6mm.step]
2026-10-13 Add automatic FreeCAD renders of the assemblies
    - tools/render.py + render.ps1: render the main assembly (4 views) and each
    base assembly (outside-corner view) from STEP with CAD colours, shaded
    without edges; 2x supersampled, auto-cropped
    - Renders are only rewritten when pixels change, and FreeCAD's PNG metadata
    (timestamp, local file path) is stripped, so unchanged models cause no
    git churn and no path leaks
    - update-previews.ps1 now renders too (-SkipRenders to opt out)
    - Printed Version README: render gallery; note that print-ready holes are
    enlarged ~0.3mm (why they're lighter than the mockup copies)
2026-10-13 Feature the Overview render at the top of the Printed Version README
2026-10-13 Add Shared Components for parts common to every version
    Moves the parts used unchanged by both the printed and CF assemblies out of
    Printed Version/Base Components/Print Ready into Shared Components/Print Ready
    (git mv, history kept): back/front spacer plates, back motor spacer, XY live
    idler spacer, Z carriage spacer and the tensioner lever arm. The nominal-size
    lever (for cutting from CF or metal) goes in Shared Components/For Cutting.
    - make_bom_md: links made parts to STLs in the variant or Shared Components;
    plate sections link too; Mouser/McMaster store labels
    - update-previews: finds STEP folders at any depth (flat CF Base Components,
    Shared Components subfolders)
    - bom_rules: CF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
    [2x Back Spacer Plate 20mm - For Printing.step, 2x Back Spacer Plate 20mm - For Printing.stl, 2x Front Spacer Plate 20mm - For Printing.step, 2x Front Spacer Plate 20mm - For Printing.stl, 2x Printed Back Motor Spacer -For Printing.step, 2x Printed Back Motor Spacer -For Printing.stl, 2x XY Live Idler Spacer - For Printing.step, 2x XY Live Idler Spacer - For Printing.stl]
2026-10-13 Printed: remove hidden Xol MGN9H shim from the main assembly STEP
    The shim was hidden in Fusion, so the STL preview and renders are unchanged
    and were intentionally not regenerated. step_bom check passes.
    [SV08-P6 Dual Shear Live Idlers Front Tensioners.step]
2026-10-13 Add the CF Version (6mm carbon fiber gantry)
    - Main assembly, 6 base assemblies and 13 CF base components (12 plates +
    5mm XY idler spacer), each with STL previews
    - BOM: SV08_CF6_BOM_from_STEP.xlsx + generated BOM.md. PEM self-clinching
    standoffs (SO-M3-3ZI x24, SO-M3-6ZI x12, Mouser) replace the heat-set
    inserts; CF Plates section; shared parts link to Shared Components.
    step_bom check passes.
    - Renders: 4 main views + 6 sub-assemblies; README features the Overview
    - Landing README: CF marked available
    [Back Left Bottom Plate CF6mm.step, Back Left Bottom Plate CF6mm.stl, Back Left Motor Assembly CF6mm.step, Back Left Motor Assembly CF6mm.stl, Back Left Top Plate CF6mm.step, Back Left Top Plate CF6mm.stl, Back Right Bottom Plate CF6mm.step, Back Right Bottom Plate CF6mm.stl]
2026-10-13 Landing image: printed and CF split on the diagonal; epoxy tip for CF
    - tools/landing_composite.py: combines each variant's Front Right render
    into Renders/Landing - Front Right.png, split top-right to bottom-left
    (aligned on content, pixel-only, rewritten only when pixels change);
    render.ps1 rebuilds it after every render run
    - Landing README features the composite
    - CF README: recommend epoxying the PEM standoffs so they can't fall out
    during assembly/disassembly, with a clean product link
2026-10-13 Landing variant table: BOM and XLSX links for each available variant
2026-10-14 Metal Version: initial 5mm 6061 plates + plate-check tool
    - 13 metal base components (front, back and XY live idler pairs + 5mm
    spacer) as STEP, with STL previews in For Viewing
    - Holes: M3 taps at 2.5 (M2 1.6 on back tops), close-fit clearance
    3.2/4.3/5.3, D5 shoulder-bolt holes 5.00, F695 seats 13.00 + 16.20x1.6,
    NEMA17 boss 22.00, tensioner slot 5.3; no CF counterbores (5mm native)
    - Front-top motor/bearing web removed; back-top pulley relief extended
    over the retainer taps; rims/walls >= 1.5mm except two accepted 1.08mm
    seat-to-shoulder rims on the front tops
    - All left/right pairs verified as exact mirrors; handedness matches CF
    - tools/plate_check.py + plate-check.ps1: thickn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
    [Back Left Bottom Plate Metal5mm.step, Back Left Bottom Plate Metal5mm.stl, Back Left Top Plate Metal5mm.step, Back Left Top Plate Metal5mm.stl, Back Right Bottom Plate Metal5mm.step, Back Right Bottom Plate Metal5mm.stl, Back Right Top Plate Metal5mm.step, Back Right Top Plate Metal5mm.stl]
2026-10-14 Metal: XY Joint Right sub-assembly, STL preview and render
    - XY Joint Right Metal5mm: plates match the committed base components;
    shoulder bolts seat on the bottom plate; retainer screws are M3x5 FHCS
    ending flush; threaded spacer clamped by ultra-thin flat heads (as CF)
    - Metal README: sub-assemblies section with render; build note that the
    6mm shoulder-bolt thread sticks out 1mm under the 5mm bottom plates
    (trim if wanted; don't add a washer under the head)
    - render.ps1 / update-previews.ps1: render sub-assemblies even before a
    variant has a main assembly STEP
    [XY Joint Right Metal5mm.step, XY Joint Right Metal5mm.stl]
2026-10-14 Landing README: 'Three styles of parts, one unified system' tagline
2026-10-14 Threadlocker recommendation for the ultra-thin flat heads
    The M3x10 ultra-thin flat heads thread into the internally threaded
    spacers that serve as live idler shafts, which spin with the pulleys.
    Landing README gets a Build notes section; Printed and CF BOM rows (and
    BOM.md) recommend blue threadlocker, red only for permanent builds.
    [SV08_CF6_BOM_from_STEP.xlsx, SV08_P6_Printed_BOM_from_STEP.xlsx]
2026-10-14 Metal: XY Joint Left sub-assembly; XY Joint Right part rename
    - XY Joint Left Metal5mm: plates match the committed base components,
    M3x5 FHCS retainers flush, shoulders seated, no collisions; STL and
    render added
    - XY Joint Right: retainer screws renamed to 'M3x5mm FHCS' in the CAD
    (mesh unchanged, so its STL and render are byte-identical)
    - render.ps1: fixed mirror angles for the XY joints (Left 315, Right 45),
    matching the Printed/CF renders, since the metal file positions gave
    an inconsistent automatic view
    - Metal README: both XY joints side by side
    [XY Joint Left Metal5mm.step, XY Joint Left Metal5mm.stl, XY Joint Right Metal5mm.step]
2026-10-14 Metal: Back Right Motor Assembly sub-assembly, STL and render
    - Plates match the committed base components; shoulder bolts seated;
    bearing retainers are M3x4 FHCS ending on the pulley-relief floor; D2F
    endstop screws into tapped M2 holes (nuts removed); M2x8 sticks out
    0.2mm under the top plate (accepted, noted in README)
    - render.ps1: -Only to render a single sub-assembly
    - Metal README: back right motor corner added
    [Back Right Motor Assembly Metal5mm.step, Back Right Motor Assembly Metal5mm.stl]
2026-10-14 Metal Back Right Motor Assembly: retainer screws renamed to M3x4 FHCS
    Re-exported STEP and regenerated STL; geometry unchanged.
    [Back Right Motor Assembly Metal5mm.step, Back Right Motor Assembly Metal5mm.stl]
2026-10-14 Metal: Back Left motor assembly; both back pulleys lowered 1mm
    - Back motor pulleys lowered 1mm relative to the plates so they line up
    with the idler stacks again (the 5mm plates dropped the idlers 1mm);
    fixes the Back Left pulley rubbing the top bearing (now 0.7mm clear)
    - Back Left: duplicate M4x10 BHCS + washer removed; plates match files
    - Back Right: re-exported (M3x4mm FHCS naming + pulley fix)
    - STLs, renders and Metal README updated
    [Back Left Motor Assembly Metal5mm.step, Back Left Motor Assembly Metal5mm.stl, Back Right Motor Assembly Metal5mm.step, Back Right Motor Assembly Metal5mm.stl]
2026-10-14 CF: fix malformed M4 holes on XY Live Idler Left Top
    The two M4 holes at (-20.6, 10) and (-0.6, 10) were a clean 4.0 through
    hole overlapped by 4.3 and 4.2 bores 5mm deep from the bottom face. Now a
    clean 4.0 through, matching XY Live Idler Right Top exactly (7785.4 mm3).
    XY Joint Left sub-assembly and the CF main assembly re-exported with the
    fixed plate; STL previews regenerated (renders and BOM unchanged).
    [SV08-CF6 Dual Shear Live Idlers Front Tensioners.step, SV08-CF6 Dual Shear Live Idlers Front Tensioners.stl, XY Joint Left CF6mm.step, XY Joint Left CF6mm.stl, XY Live Idler Left Top Plate CF6mm.step, XY Live Idler Left Top Plate CF6mm.stl]
2026-10-14 Metal: 5mm tensioner lever arm
    - Tensioner Lever Arm Revised - 5mm Metal Only: flat 5mm version of the
    shared lever (no 1.2mm boss); M3 clearance 3.2 through an MR63ZZ seat
    (6.00 x 2.6), pivot 5.3 for the M5x45 bolt; STL preview
    - Metal README: lever listed (14 parts); hole guide gains the MR63ZZ seat
    (6 H7 light press, retaining compound if loose)
    - Shared Components README: metal builds use their own lever
    - plate_check: levers exempt from the tapped-hole rule; slot arc accepted
    [Tensioner Lever Arm Revised - 5mm Metal Only.step, Tensioner Lever Arm Revised - 5mm Metal Only.stl]
2026-10-14 Metal: Front Left motor assembly; flipped front-top bearing pocket
    - Front Left Top: bearing pocket flipped (flange ledge on the motor side)
    and dropped 0.2mm; the ultra-thin flat head clears the motor by 0.2mm
    and the clamp load goes into the plate; top retainers M3x4 FHCS
    - Front Left Bottom re-exported; both plates pass plate-check
    - Front Left Motor Assembly Metal5mm: pulleys aligned with the idlers;
    2x M5 washers under each shoulder head so 4mm of thread goes into the
    motor (the front shoulder bolts are the motor screws); STL + render
    - Metal README: front corner notes and a build note on the front shoulder
    bolts (washers, or trim the thread to 4mm)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
    [Front Left Bottom Metal5mm.step, Front Left Motor Assembly Metal5mm.step, Front Left Motor Assembly Metal5mm.stl, Front Left Top Metal5mm.step, Front Left Top Metal5mm.stl]
2026-10-14 Metal: Front Right motor assembly; pulley-gap build note
    - Front Right Motor Assembly Metal5mm (STEP, STL preview, render)
    - Front Right Top/Bottom plates re-exported with the flipped front-top
    bearing pocket; front plates are exact mirror pairs again
    - Front Right pulleys lowered 0.3 mm: 0.4 mm to the bearing, belt still
    fully on the teeth
    - README: pulley-to-bearing gap build note; Front Right in the metal
    sub-assembly gallery
    [Front Right Bottom Metal5mm.step, Front Right Bottom Metal5mm.stl, Front Right Motor Assembly Metal5mm.step, Front Right Motor Assembly Metal5mm.stl, Front Right Top Metal5mm.step, Front Right Top Metal5mm.stl]
2026-10-14 Metal: full gantry assembly, renders and three-way landing image
    - SV08-M5 main assembly STEP + STL preview (32 MB) and all four gantry renders
    - Front Left/Right Top: tips where the bearing step meets the motor-boss
    recess filleted (were knife-edge spikes); the remaining 1.08 mm tongue
    is accepted in plate_accepted.json
    - Front Left plates flattened to single-level "Metal5mm" components;
    Front Right re-placed as an exact mirror; Back Left motor connector
    orientation matched to Back Right
    - Landing image: Y split from the centre with labels
    (Printed 6mm left, Aluminum 5mm top, Carbon Fiber 6mm right)
    - READMEs: metal full-assembly section, status "plates and assemblies
    available,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
    [Back Left Motor Assembly Metal5mm.step, Back Left Motor Assembly Metal5mm.stl, Front Left Bottom Metal5mm.step, Front Left Bottom Metal5mm.stl, Front Left Motor Assembly Metal5mm.step, Front Left Motor Assembly Metal5mm.stl, Front Left Top Metal5mm.step, Front Left Top Metal5mm.stl]
2026-10-14 Metal BOM is live, and the wall sweep moves into tools 🙂
    - Metal Version: SV08_M5_BOM_from_STEP.xlsx + BOM.md, derived from the CF
    BOM and checked against the metal STEP (M3 x 5 / M3 x 4 FHCS retainers,
    no PEM standoffs or M2 nuts, 60 M5 washers, metal plates and lever arms).
    The metal variant is now marked Available on the landing page.
    - tools/wall_check.py: direct wall and floor sweep that also catches merged
    pockets (knife-edge tips, thin tongues). plate-check.ps1 runs it after
    plate_check.py; -SkipWallSweep / -SweepOnly pick one.
    - Printed-part rules with your own numbers: -WallMultiple (line width,
    e.g. 0.4 / 0.45 / 0.5) up to -WallMax, and -LayerHeight (e.g. 0.2 / 0.15)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
    [SV08_M5_BOM_from_STEP.xlsx]
2026-10-14 CF: XY live idler plates and spacer reworked with machining tolerances
    - XY Live Idler Left/Right Top and Bottom: clearance holes 3.2 / 4.3,
    PEM bores 4.3, bearing step 16.2, retainer counterbores 6.2,
    shoulder-head counterbores 8.3 (D5 shoulder holes stay 5.00); outline
    grown for 1.5 mm around the retainer "mouse ears"; hex PEM pockets
    merged into one relief with R1 corners (3 full + 2 half flats), which
    removes the old 0.85-1.34 mm walls. Left plates are exact mirrors.
    - XY spacer: back at the origin, now identical to the metal spacer;
    BOM note says it's machined to 5 mm from the 6 mm sheet.
    - plate_accepted.json: the remaining 1.10/1.35 mm PEM-to-bearing walls,
    0.40 mm hex-s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
    [SV08_CF6_BOM_from_STEP.xlsx, XY Live Idler Left Bottom Plate CF6mm.step, XY Live Idler Left Bottom Plate CF6mm.stl, XY Live Idler Left Top Plate CF6mm.step, XY Live Idler Left Top Plate CF6mm.stl, XY Live Idler Right Bottom Plate CF6mm.step, XY Live Idler Right Bottom Plate CF6mm.stl, XY Live Idler Right Top Plate CF6mm.step]
2026-10-15 CF: back motor plates reworked with machining tolerances
    - Back Left/Right Bottom: clearance holes 3.2 / 4.3, 6ZI PEM bores 4.3
    with 0.6 mm hex pockets (R1 corners), matching the XY plates.
    - Back Left/Right Top: clearance holes 3.2 / 4.3; retainer PEM bores
    4.3, now running through to the 6.2 FHCS counterbores (the 0.40 mm
    floor is gone; the PEM is located by its hex shoulder at z 1.6);
    hex PEM and M2 nut pockets with R1 corners; bearing step 16.2, top
    relief 15.2, shoulder-head counterbores 8.3 (D5 holes stay 5.00).
    - Left plates are exact flipped mirrors of the right.
    - plate_accepted.json: 1.10 mm PEM-to-bearing walls, 0.25 mm hex-shoulder
    ledges, 0.95 mm FHCS seat rings and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
    [Back Left Bottom Plate CF6mm.step, Back Left Bottom Plate CF6mm.stl, Back Left Top Plate CF6mm.step, Back Left Top Plate CF6mm.stl, Back Right Bottom Plate CF6mm.step, Back Right Bottom Plate CF6mm.stl, Back Right Top Plate CF6mm.step, Back Right Top Plate CF6mm.stl]
2026-10-15 CF: front motor plates reworked; all 13 CF plates pass both checks
    - Front Left/Right Top: clearance 3.2 / 4.3, PEM bores 4.3, retainer
    counterbores 6.2, bearing step 16.2, tensioner slot 5.3, tensioner PEM
    4.3 with a 0.6 mm R1 hex pocket. The Ø22 motor boss and Ø13 bearing bore
    are merged (removes the 0.27 mm web), hex PEM pockets merged with R1
    corners, outline grown at the bearing end with smaller mouse-ear notches.
    - Front Left/Right Bottom: the same hole updates for all four retainer
    PEMs, shoulder-head counterbores 8.3 (D5 holes stay 5.00), bearing steps
    and counterbores now 1.6 mm deep on both sides (fixes the 0.1 mm
    left/right bearing-height difference), outline and p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
    [Front Left Bottom CF6mm.step, Front Left Bottom CF6mm.stl, Front Left Top CF6mm.step, Front Left Top CF6mm.stl, Front Right Bottom CF6mm.step, Front Right Bottom CF6mm.stl, Front Right Top CF6mm.step, Front Right Top CF6mm.stl]
2026-10-15 CF: XY joint plates with larger PEM hex pockets; XY joint assemblies updated
    - XY Live Idler Left/Right Top and Bottom: hex PEM pockets opened from
    5.1 to 5.3 mm across flats (R1 corners), so the 4.8 mm PEM hex corners
    clear the corner fillets by ~0.13 mm instead of ~0.02 mm. Bearing bores
    confirmed at 13.00 on all four plates. Left plates remain exact mirrors.
    - XY Joint Left/Right CF6mm assemblies re-exported with the new plates and
    spacers: plates identical to their files, no PEM/plate interference.
    STL previews and renders updated.
    - plate_accepted.json: hex-shoulder ledges updated from 0.40 to 0.50 mm.
    [XY Joint Left CF6mm.step, XY Joint Left CF6mm.stl, XY Joint Right CF6mm.step, XY Joint Right CF6mm.stl, XY Live Idler Left Bottom Plate CF6mm.step, XY Live Idler Left Bottom Plate CF6mm.stl, XY Live Idler Left Top Plate CF6mm.step, XY Live Idler Left Top Plate CF6mm.stl]
2026-10-15 CF: under-review notice; back plates with larger PEM hex pockets
    - CF README: notice that the CF plates and assemblies are under review
    and shouldn't be cut or ordered until the review is finished.
    - Back Left/Right Top and Bottom: hex PEM pockets opened to ~5.3 mm
    across flats with R1 corners (PEM hex corners clear by >= 0.13 mm;
    the hex-shoulder ledge on the tops grows from 0.25 to 0.50 mm).
    Left plates remain exact flipped mirrors. STL previews updated.
    - plate_accepted.json: back-top ledge entries updated to 0.50 mm.
    The front plates are still being revised and aren't in this commit.
    [Back Left Bottom Plate CF6mm.step, Back Left Bottom Plate CF6mm.stl, Back Left Top Plate CF6mm.step, Back Left Top Plate CF6mm.stl, Back Right Bottom Plate CF6mm.step, Back Right Bottom Plate CF6mm.stl, Back Right Top Plate CF6mm.step, Back Right Top Plate CF6mm.stl]
2026-10-15 CF: front plates with larger PEM hex pockets; all 13 CF plates pass
    - Front Left/Right Top and Bottom: hex PEM pockets opened to 5.3 mm
    across flats (R1 corners; tensioner pocket R1.1), so the 4.8 mm PEM
    hex corners clear by ~0.12-0.13 mm. Fixed the half-flat end fillet on
    the front-bottom pocket at (34.23, 1.79), where a PEM corner touched
    the plate. Front Left Top re-exported as a single body. All shoulder
    holes confirmed at 5.00. Left plates remain exact flipped mirrors.
    - plate_accepted.json: front ledges updated to 0.50 mm; 1.41 mm wall
    between the retainer hex pocket and the motor-boss opening accepted on
    both front tops.
    All 13 CF plates pass plate_check and wall_check.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
    [Front Left Bottom CF6mm.step, Front Left Bottom CF6mm.stl, Front Left Top CF6mm.step, Front Left Top CF6mm.stl, Front Right Bottom CF6mm.step, Front Right Bottom CF6mm.stl, Front Right Top CF6mm.step, Front Right Top CF6mm.stl]
2026-10-15 CF: front right motor assembly with the reworked plates; 0.5 mm shoulder recess
    - Front Left/Right Bottom: D5 shoulder-bolt head recess reduced from 1.0
    to 0.5 mm (still Ø8.3), so the shoulder bolts that hold the motor now
    thread 4.5 mm into it instead of 5.0.
    - Front Right Motor Assembly CF6mm re-exported with the reworked plates:
    plates identical to their files, 4.5 mm of thread in the motor, 0.40 mm
    ultra-thin head clearance, belt line centred on the pulley teeth, both
    bottom bearings at the same height. STL preview and render updated.
    - README build note: for motors with 4 mm-deep screw holes, trim 0.5 mm
    off the front shoulder bolts' threads.
    The CF README keeps its under-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
    [Front Left Bottom CF6mm.step, Front Left Bottom CF6mm.stl, Front Right Bottom CF6mm.step, Front Right Bottom CF6mm.stl, Front Right Motor Assembly CF6mm.step, Front Right Motor Assembly CF6mm.stl]
2026-10-15 CF: back right motor assembly with the reworked plates
    - Back Right Motor Assembly CF6mm re-exported with the reworked plates:
    plates identical to their files; both retainer PEMs on their bores with
    the hex head on the pocket ledge (z 1.1-4.1); D5 shoulder bolts seat on
    the 6ZI PEMs with the head in the 1.0 mm recess; pulley teeth centred on
    the lower belt's bearing stack; motor screws 2.88 mm into the motor.
    - STL preview and render updated.
    [Back Right Motor Assembly CF6mm.step, Back Right Motor Assembly CF6mm.stl]
2026-10-15 CF review complete; landing page reorganized around all three versions
    - CF: Back Left, Front Left, Front Right and both XY joint assemblies and
    the main STEP re-exported with the reworked plates. All checks pass:
    plates identical to their files, no PEM/plate interference, Front Left
    tensioner washer and Front Right lever-arm PEM fixed, Front Right motor
    orientation matched, Front Right position fixed in the main, Z-carriage
    spans 531.000 mm front and back, collisions normal, BOM matches.
    Under-review notice removed from the CF README.
    - Metal: sub-assemblies and main re-exported (no geometry changes);
    Z-carriage spans 531.000 mm front and back.
    - STL previews, renders and the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
    [Back Left Motor Assembly CF6mm.step, Back Left Motor Assembly CF6mm.stl, Back Left Motor Assembly Metal5mm.step, Back Right Motor Assembly CF6mm.step, Back Right Motor Assembly CF6mm.stl, Back Right Motor Assembly Metal5mm.step, Back Right Motor Assembly Metal5mm.stl, Front Left Motor Assembly CF6mm.step]
2026-10-16 Metal: washers under the back motor screws; duplicate-component check
    - Metal back corners: two M3 washers under each M3 x 35 motor screw head,
    so 3.68 mm of thread goes into the motor (was 4.88). Build note added to
    the Metal README and the landing page; BOM washer row is now 24.
    - M3 washer renamed to "M3 Washer (3mm ID | 7mm OD | .5-.6mm Tall)" in the
    CF and Metal assemblies and BOMs.
    - Copy-pasted components (Fusion "Name (1)") replaced with instances in the
    CF and Metal XY joints and the Metal back right; no geometry changes.
    - tools/step_bom.py: new "dupes" mode, also run by "check", that flags
    copy-pasted components in the main and every sub-assembly (stock Sovol
    Z carriag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
    [Back Left Motor Assembly Metal5mm.step, Back Left Motor Assembly Metal5mm.stl, Back Right Motor Assembly Metal5mm.step, Back Right Motor Assembly Metal5mm.stl, SV08-CF6 Dual Shear Live Idlers Front Tensioners.step, SV08-CF6 Dual Shear Live Idlers Front Tensioners.stl, SV08-M5 Dual Shear Live Idlers Front Tensioners.step, SV08-M5 Dual Shear Live Idlers Front Tensioners.stl]
2026-10-16 tools: two-tier printed wall check, insert walls, drawings of every finding
    - wall_check.py: -PreferredWall second tier (BELOW-PREFERRED WALL, kind
    "preferred") and -InsertHole (INSERT WALL, kind "insert": walls beside
    heat-set insert holes thinner than the preferred wall). The exact
    line-width multiple rule stays available but optional.
    - Every part with findings gets a marked-up drawing in
    %TEMP%\sv08-plate-check: overview, key, and a zoom of each finding at
    its own height, open ones numbered and accepted ones in green (A1, A2...).
    - Printed rules documented: 2.0 mm minimum, 3.6 mm preferred, 4.7 mm
    insert holes, 0.2 mm layers.
    - plate_accepted.json: accepted walls for the rewo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
2026-10-16 tools: printed preferred wall lowered to 3.0 mm; drop accepted entries that no longer apply
2026-10-16 tools: accepted walls for the printed XY Live Idler Right Bottom
2026-10-16 tools: accepted walls for the printed XY Live Idler Left Bottom (mirror of the right)
2026-10-16 tools: accepted end wall on the printed 10 mm XY live idler spacer
2026-10-16 tools: printed Back Right plates accepted; drop XY bearing-step ring entries (step now 15.5)
2026-10-16 tools: accepted walls for the Back Right Top endstop wire channel
2026-10-16 tools: accepted walls for the printed Back Left plates (mirrors of the right)
2026-10-17 tools: back plates' walls along the edge cut back for the Z carriage
2026-10-17 tools: restore the back plates' end-hole wall entries
2026-10-17 tools: accepted insert and Z-gantry edge walls on the printed Front Right Top
2026-10-17 tools: more accepted walls on the printed Front Right Top
2026-10-17 tools: Front Right Top walls between 2.0 and 3.0 mm accepted
2026-10-17 tools: Front Right Top passes (insert walls accepted)
2026-10-17 tools: all four printed front plates pass
2026-10-17 Printed v2 alpha: reworked plates, sub-assemblies, BOM and 3MF
    Every printed plate reworked for printing:
    - support-free: all pockets on one face, inserts open on the bed face,
    stepped bridging over the M2 nut traps
    - walls checked against the printed rules (2.0 mm minimum, 3.0 mm
    preferred, insert walls), with accepted exceptions in plate_accepted.json
    - holes at nominal +0.3, D5 shoulder bores at 5.1 (drill to 5 mm),
    bearing steps 15.5, front-bottom shoulder recess 0.4
    - back plates: edge cut back to clear the Z carriage, endstop wire tunnel
    on the back tops; front tops: merged relief around the bearing
    - one 10 mm XY idler spacer replaces two 5 mm ones
    - Print Ready parts now used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
    [Back Left Bottom Plate Printed6mm - For Printing.step, Back Left Bottom Plate Printed6mm - For Printing.stl, Back Left Motor Assembly Printed 6mm.step, Back Left Motor Assembly Printed 6mm.stl, Back Left Top Plate Printed6mm - For Printing.step, Back Left Top Plate Printed6mm - For Printing.stl, Back Right Bottom Plate Printed6mm - For Printing.step, Back Right Bottom Plate Printed6mm - For Print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]
2026-10-17 Printed v2 alpha: heat-set insert installation notes from the first test build
    Step-by-step section in the Printed README (bearings first, start the
    insert straight with a screw, push back any bulge, set flush or slightly
    deep, trim, chase the threads from the side opposite the real screw), with
    a summary in the landing page's printed build notes.
2026-10-17 Printed v2 alpha: build photos of the first test assembly (front left)
    Photos resized to 1600 px with all metadata stripped.
2026-10-18 BOMs: threaded spacers under review (linked ones measure ~5.05 mm); sanding note for anyone who has them
    [SV08_CF6_BOM_from_STEP.xlsx, SV08_M5_BOM_from_STEP.xlsx, SV08_P6_Printed_BOM_from_STEP.xlsx]
2026-10-18 BOMs: 5 mm slip-fit dowel (40 mm XY, 30 mm front) as an alternative to the threaded spacers
    [SV08_CF6_BOM_from_STEP.xlsx, SV08_M5_BOM_from_STEP.xlsx, SV08_P6_Printed_BOM_from_STEP.xlsx]
2026-10-19 Printed v2 alpha: back left test-build photos (metadata stripped)
2026-10-19 Printed v2 alpha: full gantry assembly, renders and landing image
    - Main assembly rebuilt on the v2 parts: all six sub-assemblies match it
    exactly, Z carriage span 531.000 front and back (was 531.049), BOM and
    duplicate checks pass
    - XY Joint Left: the shared XY live idler spacer moved to mirror the right
    joint (mock-up layout only; no plate changes)
    - Full gantry STL preview, renders and the three-way landing image
    regenerated
    - README alpha notes updated: everything is v2 now, test build in progress
    [SV08-P6 Dual Shear Live Idlers Front Tensioners.step, SV08-P6 Dual Shear Live Idlers Front Tensioners.stl, XY Joint Left Printed 6mm.step, XY Joint Left Printed 6mm.stl]
2026-10-19 Printed v2 is current: remove the v1 mockup plates and the 5 mm XY spacer
    - Delete Base Components/For Mockups Only (old v1 plates in assembled
    orientation); the Print Ready parts are used in every assembly
    - Delete the 5 mm XY live idler spacer (replaced by the 10 mm spacer)
    - READMEs: alpha warnings replaced by a v2 note linking the printed-v1
    release; folder tree and mockup references updated
    [Back Left Bottom Plate Printed6mm.step, Back Left Bottom Plate Printed6mm.stl, Back Left Top Plate Printed6mm.step, Back Left Top Plate Printed6mm.stl, Back Right Bottom Plate Printed6mm.step, Back Right Bottom Plate Printed6mm.stl, Back Right Top Plate Printed6mm.step, Back Right Top Plate Printed6mm.stl]
2026-10-19 Printed v2: fully assembled build photos (metadata stripped)
2026-10-19 BOMs: threaded spacers confirmed working once sanded full length to fit (pulleys must slide over them too)
    [SV08_CF6_BOM_from_STEP.xlsx, SV08_M5_BOM_from_STEP.xlsx, SV08_P6_Printed_BOM_from_STEP.xlsx]
2026-10-19 Printed main: fix rail T-nut placement (Y-rail nut height, X-rail nuts in the slot)
    [SV08-P6 Dual Shear Live Idlers Front Tensioners.step, SV08-P6 Dual Shear Live Idlers Front Tensioners.stl]
2026-10-19 BOMs: break out the linear rail mounting screws and M3 T-nuts into their own section
    step_bom category_by_assembly accepts {as, only} to move only matching parts of a group.
    [SV08_CF6_BOM_from_STEP.xlsx, SV08_M5_BOM_from_STEP.xlsx, SV08_P6_Printed_BOM_from_STEP.xlsx]
2026-10-21 BOMs: stock extrusion compatibility notes; stock 345 mm gantry X fits with a 6 mm OD spacer at each end
    [SV08_CF6_BOM_from_STEP.xlsx, SV08_M5_BOM_from_STEP.xlsx]
2026-10-21 Printed: XY joint M4 holes moved 0.99 mm to match the stock SV08 toolhead extrusion
    Holes now 5 mm and 25 mm from the extrusion ends, like the stock holes; outlines grown 0.54 mm,
    end walls 2.0 mm (accepted). Main, XY joint assemblies, STL previews, renders and BOM notes updated.
    [SV08-P6 Dual Shear Live Idlers Front Tensioners.step, SV08-P6 Dual Shear Live Idlers Front Tensioners.stl, SV08_P6_Printed_BOM_from_STEP.xlsx, XY Joint Left Printed 6mm.step, XY Joint Left Printed 6mm.stl, XY Joint Right Printed 6mm.step, XY Joint Right Printed 6mm.stl, XY Live Idler Left Bottom Plate Printed6mm - For Printing.step]
2026-10-22 Printed: Chicago bolt live idler shafts; stock parts models; stock extrusion notes
    Printed fronts and XY joints now use 304 stainless Chicago bolt bases (30/40 mm, 5 mm barrel)
    with M4x8 ultra-thin flat heads: full-width, clamped bearings, 0.4 mm under the front motors
    (front plate pocket floors 4.4 -> 4.6). Printed BOM: Live Idler Shafts section replaces the
    threaded spacers and M3 ultra-thin heads (kept as alternatives). New Shared Components/Stock
    Parts: Chicago bolt parts and the stock SV08 toolhead / gantry X / gantry Y extrusions.
    BOMs (all versions): trim the 345 mm gantry X 1.5 mm per end. New 3MF, STL previews, renders,
    README notes.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
    [Front Left Bottom Printed6mm - For Printing.step, Front Left Bottom Printed6mm - For Printing.stl, Front Left Motor Assembly Printed 6mm.step, Front Left Motor Assembly Printed 6mm.stl, Front Left Top Printed6mm - For Printing.step, Front Left Top Printed6mm - For Printing.stl, Front Right Bottom Printed6mm - For Printing.step, Front Right Bottom Printed6mm - For Printing.stl]
2026-10-22 CF: Chicago bolt live idler shafts, XY holes match the stock toolhead extrusion, CF printed parts 3MF
    CF fronts and XY joints use the M5x30/M5x40 Chicago bolt bases with M4x8 ultra-thin heads
    (spans 30/40 exact, 0.4 mm under the front motors); XY M4 holes moved 0.99 mm to 5 / 25 mm
    from the stock toolhead extrusion ends (outlines +1.19 mm); XY spacer re-exported. CF BOM:
    Live Idler Shafts section and stock toolhead note. Accepted: XY retainer floors 1.00 mm,
    shifted XY Left walls, and the front-bottom 0.40 mm retainer floors for a test cut.
    New CF Printed Parts.3mf, STL previews, renders, README notes.
    [CF Printed Parts.3mf, Front Left Bottom CF6mm.step, Front Left Bottom CF6mm.stl, Front Left Motor Assembly CF6mm.step, Front Left Motor Assembly CF6mm.stl, Front Left Top CF6mm.step, Front Left Top CF6mm.stl, Front Right Bottom CF6mm.step]
2026-10-22 Metal: Chicago bolt live idler shafts, XY holes match the stock toolhead extrusion, metal printed parts 3MF
    Metal XY joints and fronts use the M5x40/M5x30 Chicago bolt bases with M4x8 ultra-thin heads.
    XY span 40 mm exact; front span 29 mm, so one M5 washer under each front base head (BOM 60 -> 62
    washers) and a note to sand the front screw heads to ~1.0 mm (0.2 -> 0.4 mm under the motor).
    XY M4 holes now 5 / 25 mm from the stock toolhead extrusion ends: all three versions fit the
    stock extrusions. Metal BOM Live Idler Shafts section, stock toolhead note; README build notes;
    root README now describes Chicago bolts and stock extrusions for every version; note that
    machined aluminium lever arm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
    [Front Left Bottom Metal5mm.step, Front Left Bottom Metal5mm.stl, Front Left Motor Assembly Metal5mm.step, Front Left Motor Assembly Metal5mm.stl, Front Left Top Metal5mm.step, Front Left Top Metal5mm.stl, Front Right Bottom Metal5mm.step, Front Right Bottom Metal5mm.stl]
2026-10-22 CF: M3 hex nuts in hex pockets replace the PEM standoffs
    All 12 CF plates: SO-M3-3ZI / SO-M3-6ZI pockets become M3 nut pockets (5.9 mm A/F, R1 corners,
    2.5 mm deep, 2.4 mm at the front-bottom retainers for a 1.0 mm floor; 1 mm lead-in chamfer;
    3.2 mm through holes). 36 M3 nuts in the assemblies and main; every screw gets full thread
    except the lever-arm screws (2.1 of 2.4 mm, accepted). Collisions unchanged.
    BOM: PEM section replaced by an M3 Nut row. Accepted list: front walls/floors updated for the
    nut pockets. READMEs: nut pockets instead of PEMs, glue note instead of epoxy, CF hole guide
    with current bearing-step depths. STL previews and renders regenerated.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
    [Back Left Bottom Plate CF6mm.step, Back Left Bottom Plate CF6mm.stl, Back Left Motor Assembly CF6mm.step, Back Left Motor Assembly CF6mm.stl, Back Left Top Plate CF6mm.step, Back Left Top Plate CF6mm.stl, Back Right Bottom Plate CF6mm.step, Back Right Bottom Plate CF6mm.stl]
2026-10-25 Docs: build guides and FAQ, modeled after the Monolith Gantry documentation
    New Docs/ folder: a start-here index, the installation guide (bench prep, the frame and the
    front motor corners, in the on-printer order) and a draft XY joint bench guide, with step
    pictures rendered from the STEP files (new parts orange, fitted parts grey). New FAQ.md.
    tools/build-steps.ps1 + build_steps.py render the step images from Docs/steps/*.json.
    Main README gets a Start here section. Credit to Monolith3D's Monolith Gantry docs for the format.
2026-10-25 Docs: back motor corners in the installation guide
    Steps 26-38 for the back corners (top plate bearing, shoulder bolts and motor screws, standoffs
    and four-bearing stacks, back spacer plate, top plate, M4x45 into the Z carriage, top extrusion
    hardware, spin check, motor, endstop per version) with step pictures from the Back Left CAD.
    Frame step 2 notes the printed back motor spacer. Guide status updated.
2026-10-25 Docs: XY joints in the installation guide; retire the bench draft
    Steps 39-58 for the XY joints in the on-printer order, with step pictures from the XY Joint Left
    CAD and the left/right stack difference called out (left: 20 mm spacer, bearings high; right:
    10 mm spacers either side). Belt routing and pulley heights are left for the final section.
    The old bench-assembly draft (Docs/XY Joint.md and its pictures) is removed.
2026-10-26 Docs: belt routing, pulley heights and tensioning; installation guide complete
    Steps 59-73 route both belts (bottom first), with each belt's path rendered from the printed main.
    Step 74 gives the measured pulley heights for every toothed pulley. Steps 75-80 cover tensioning
    with the front lever arms (hex key plus slip-joint pliers, with two build photos, metadata
    stripped), aiming for 6-8 lb per span with a pluck-frequency table. FAQ belt answer updated.
2026-10-26 Docs: racking check and motors-sync steps
2026-10-27 CF: build photos of the first carbon fiber XY joint
2026-10-27 CF: name the build photos as the left XY joint
2026-10-27 CF: build photos of the X gantry on the stock SV08 extrusion
2026-10-30 CF: build photos of the front right motor corner
2026-11-01 CF: back motors on top, like the fronts; motor up or down documented for all versions
    The CF back corners now mount their motors above the plates. The back
    plates are the same cuts, swapped left for right and renamed to match their
    positions. The installation guide explains that any version can be built
    either way by swapping the back plates side for side.
    [Back Left Bottom Plate CF6mm.step, Back Left Bottom Plate CF6mm.stl, Back Left Motor Assembly CF6mm.step, Back Left Motor Assembly CF6mm.stl, Back Left Top Plate CF6mm.step, Back Left Top Plate CF6mm.stl, Back Right Bottom Plate CF6mm.step, Back Right Bottom Plate CF6mm.stl]
2026-11-04 CF: 9mm belt version (30mm corner gap, 9mm idlers, pulleys and longer hardware)
    New CF Version/9mm Belt Mod: full assembly, BOM (all links in), README and
    renders. Its six sub-assemblies and the three 5mm riser spacers sit in
    Base Assemblies/9mm Belt Mod and Base Components/9mm Belt Mod; the 30mm
    spacer plates and the 35mm XY live idler spacer are in Shared Components.
    The CF plates are unchanged.
    Tools understand sub-variants: step_bom inherits the parent's rules and
    finds sub-assemblies in <parent>/Base Assemblies/<name>, make_bom_md links
    the parent's plates and Shared Components, render.ps1 renders the
    sub-assemblies. Existing BOM.md files regenerate unchanged.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
    [2x Back Spacer Plate 30mm - For Printing.step, 2x Back Spacer Plate 30mm - For Printing.stl, 2x Front Spacer Plate 30mm - For Printing.step, 2x Front Spacer Plate 30mm - For Printing.stl, 2x XY Live Idler Spacer 35mm - For Printing.step, 2x XY Live Idler Spacer 35mm - For Printing.stl, Back Left Motor Assembly CF6mm (For 9mm Belts).step, Back Left Motor Assembly CF6mm (For 9mm Belts).stl]
2026-11-04 9mm belt mod works on every version: note in its README, pointer in the main README
    The 9mm Belt Mod is modelled on the CF plates but doesn't need them: the
    aluminum and printed versions take the same 9mm parts, with tapped holes or
    heat-set inserts in place of the CF M3 nuts.
2026-11-04 Mechanical analysis of the three gantry versions
    Adds Mechanical Analysis.md: plate FEA, corner and XY joint stiffness,
    gantry sag, vibration modes, yaw, thermal bow at 55/70 C chambers, motor
    heat, bolt slip, creep, a belt tensioning table and a predicted XY joint
    bench test. Carbon fiber is modelled orthotropic at 0/90 and 45 deg.
    The numbers come from tools/analysis (geometry from the assembly STEPs,
    gmsh + CalculiX from FreeCAD), rerunnable with analysis.ps1. Figures are
    in Renders/Analysis. The main README links the doc; tools/README
    documents the pipeline.
2026-11-04 Analysis doc: mark which direction is better in every table, tighten the summary
2026-11-04 Analysis: T-nut vs drilled through-bolt clamping, joint model fixes
    Adds a section comparing T-nut clamping with drilled M4 through-bolts at
    the corners and XY joints: slip capacity against thermal bow, corner
    stiffness bonded vs clamped-at-bolts, bolt lengths, clearances and
    drilling cautions (holes stay at the stock SV08 positions).
    Scripts: the corner stub follows the spacer face, corners and XY joints
    also run a clamped-at-bolts model, and each gmsh attempt times out after
    90 s so a stuck mesh is skipped instead of hanging the run.
2026-11-04 Analysis: 9mm belt mod, numbers refreshed on the current CAD
    Adds the 9mm belt mod to the mechanical analysis: plate FEA on its CF
    plates, both corners (36 mm deep back corner about twice as stiff), the
    35 mm XY joint, 1.5x belt stiffness (X/Y resonances up about 20 %),
    thermal bow, through-bolt lengths and a 9 mm tensioning table. All
    other results are rerun on the current CAD; drill end walls updated
    (XY joint 2.85 mm after the 0.99 mm hole move, X back extrusion 1.35 mm).
    Scripts: 9mm variant support, risers merged into their plates, Z-carriage
    bolts taken from the CAD, XY joints exported with three stand-in shaft
    post sizes, 6 mm CF XY joint falls back to the previous revision's
    result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
2026-11-04 Landing image aligned on the extrusions; README calls out the Mechanical Analysis
    The landing composite now registers each render to the first on its dark
    pixels (scale search + FFT cross-correlation), so the CF version's
    top-mounted motors no longer shift its region 40 px off the others.
2026-11-04 Analysis: 6 mm CF XY joint now meshes on the current CAD; fallback removed
    The joint failed because the CF spacers' 3.0 mm corner radius and the
    bottom plate's 3.35 mm one touch the same edge at one point and peel
    apart, leaving a sliver of plate face tapering to zero width. The model
    now fills that sliver into the spacer (same material), and the shoulder
    bolt stand-in post is 10.5 mm to clear an 8.3 mm relief in the top plate.
    CF XY joint, bounce and yaw figures are now from the current CAD.
2026-11-04 correcting printed xy joint belt path by moving pulley and smooth stack.
    [SV08-P6 Dual Shear Live Idlers Front Tensioners.step, SV08-P6 Dual Shear Live Idlers Front Tensioners.stl, XY Joint Left Printed 6mm.step, XY Joint Left Printed 6mm.stl, XY Joint Right Printed 6mm.step, XY Joint Right Printed 6mm.stl, XY Live Idler Left Bottom Plate Printed6mm - For Printing.step, XY Live Idler Left Bottom Plate Printed6mm - For Printing.stl]
2026-11-04 correcting metal and CF (6mm + 9mm) xy joint belt path by moving pulley and smooth stack.
    [SV08-CF6 Dual Shear Live Idlers Front Tensioners (for 9mm Belts).step, SV08-CF6 Dual Shear Live Idlers Front Tensioners (for 9mm Belts).stl, SV08-CF6 Dual Shear Live Idlers Front Tensioners.step, SV08-CF6 Dual Shear Live Idlers Front Tensioners.stl, SV08-M5 Dual Shear Live Idlers Front Tensioners.step, SV08-M5 Dual Shear Live Idlers Front Tensioners.stl, XY Joint Left CF6mm (For 9mm Belts).step, 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]
